vkottler/senior-design/README.md

# Fault-Tolerant Quadcopter

*Contributors: Vaughn Kottler, Cooper Green, Mayank Katwal*

An attempt at a quadcopter flight system that maintains
single-fault tolerance.

This project's documentation is hosted on
[Read the Docs](https://fault-tolerant-quadcopter.readthedocs.io/en/latest/).

## Repository Structure

### [cad](cad)

Schematic, printed circuit board, mechanical structure and mechanical enclosure
design assets.

### [docs](docs)

Documentation, including storage for documentation referenced for development
as well as design documentation.

### [logistics](logistics)

Bill of materials and other logistics-tracking assets.

### [src](src)

Source code for compute units and RIOs on the vehicle and on the ground.

### [scripts](scripts)

Utility shell scripts for installing dependencies to work on this project.
