vkottler/senior-design/docs/proposal/presentation.tex

\documentclass{beamer}
\setbeamertemplate{navigation symbols}{}

\usetheme{Madrid}
\usecolortheme{beaver}

% packages
\usepackage{graphicx}
\usepackage{enumitem}

% metadata
\title{Fault-Tolerant Quadcopter}
\author{Cooper, Vaughn, Mayank}
\date{\today}

\begin{document}

% title slide
{\setbeamertemplate{footline}{}
\begin{frame}
\begin{center}
{\Large\textbf{Fault-Tolerant Quadcopter}}\\
\vspace{\baselineskip}
ECE 453 Project Proposal (Fall 2018)\\
University of Wisconsin-Madison\\
\vspace{\baselineskip}
{\large\textit{Vaughn Kottler, Mayank Katwal, Cooper Green}}
\end{center}
\end{frame}
}

% state of the art (cheap toys)
\begin{frame}
\frametitle{State of the Art (Cheap Toys)}
\begin{center}
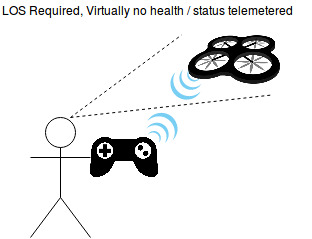
[picture p1: docs/src/im/crude.jpg]


Price Range: \$25 - \$50
\end{center}
\end{frame}

% state of the art (fpv)
\begin{frame}
\frametitle{State of the Art (Enthusiast FPV)}
\begin{center}
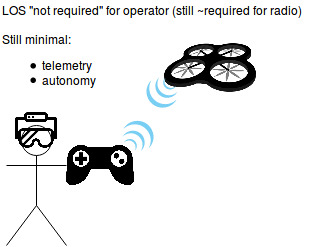
[picture p2: docs/src/im/fpv.jpg]


Price Range: \$100+
\end{center}
\end{frame}

% state of the art (industry)
\begin{frame}
\frametitle{State of the Art (Industry)}
\begin{center}
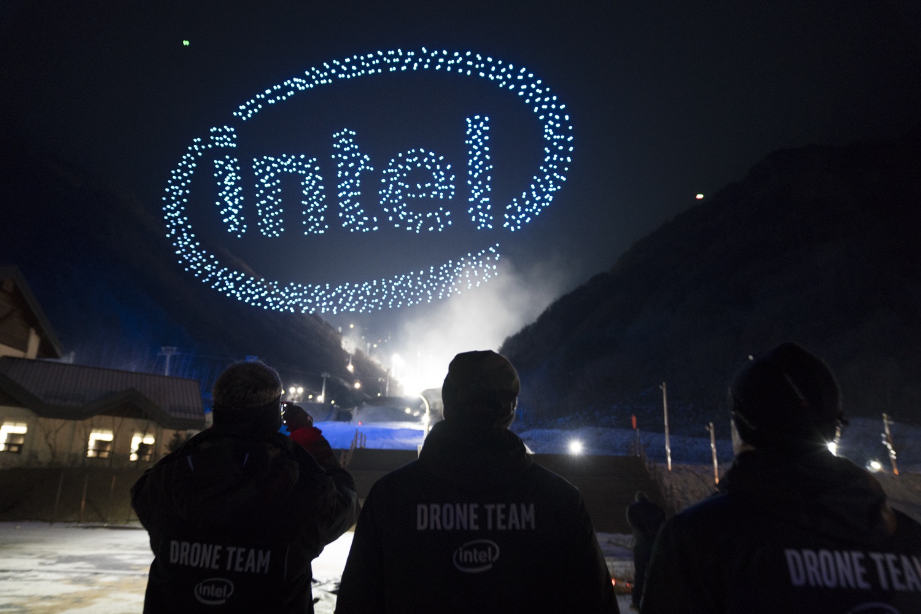
[picture p3: docs/src/im/autonomous2.jpg]


Light Show at the Olympics
\end{center}
\end{frame}

% state of the art (industry)
\begin{frame}
\frametitle{State of the Art (Industry)}
\begin{center}
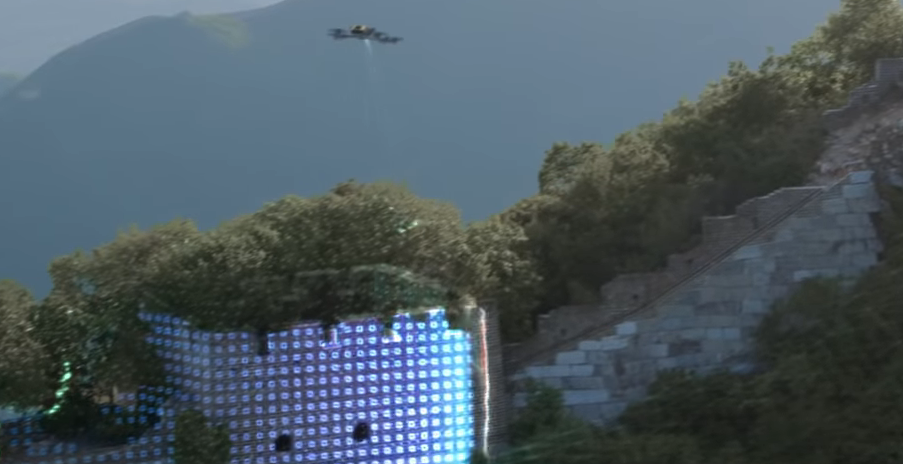
[picture p4: docs/src/im/great_wall1.png]


Intel Surveys Great Wall of China
\end{center}
\end{frame}

% problem statement
\begin{frame}
\frametitle{Problem Statement}
\Large
No ``multi-vehicle fleet'' or autonomous-flight capable drone
technology available to interact with.
\break

\textbf{What gap can we fill in this ecosystem?}
\break

To gain experience with aerospace-related problems, we propose
designing, testing and building a custom flying machine.
\break

\textbf{How hard are these problems?}
\end{frame}

% concept of approach
\begin{frame}
\frametitle{Concept of Operation}
\begin{center}
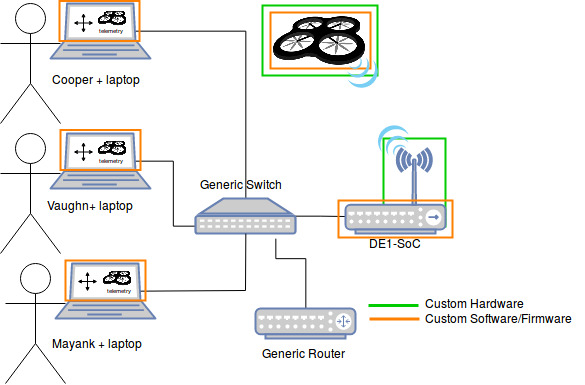
[picture p5: docs/src/im/conops.jpg]

\end{center}
\end{frame}

% features
\begin{frame}
\frametitle{Features}
\begin{description}[align=right,labelwidth=130pt,itemsep=15pt]
    \item [Telemetry Viewing] -- View vehicle data from the UI
    \item [Manual Commanding] -- Control the vehicle from the UI
    \item [Holding-Pattern Stability] -- Ability to ``idle'' with little to no motion
	\item [Single-Fault Tolerant] -- Land safely if communication is lost
\end{description}
\end{frame}

% quadcopter
\begin{frame}
\frametitle{Quadcopter}
\begin{center}
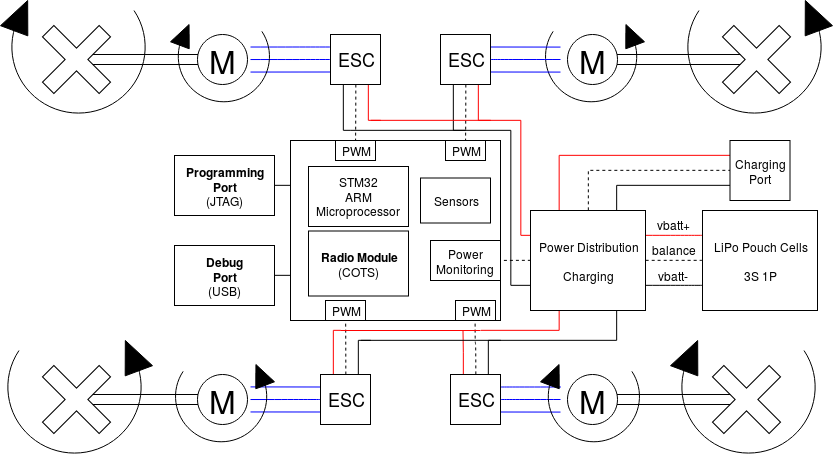
[picture p6: docs/src/im/quadcopter.png]

\end{center}
\end{frame}

% quadcopter components
\begin{frame}
\frametitle{Quadcopter Components}
\begin{center}
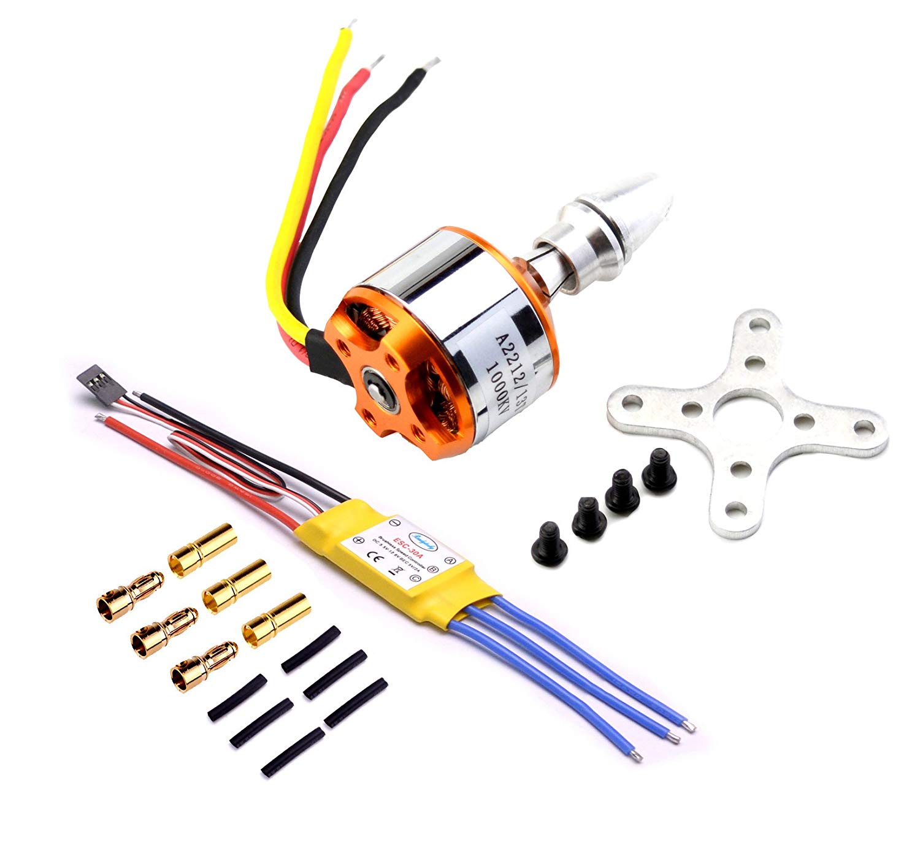
[picture p7: docs/src/im/motor_esc.jpg]




\break
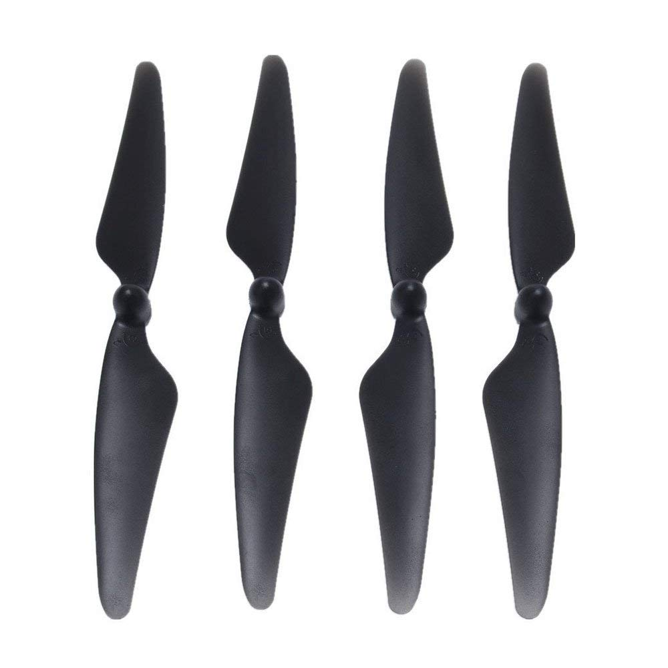
[picture p8: docs/src/im/propeller.jpg]

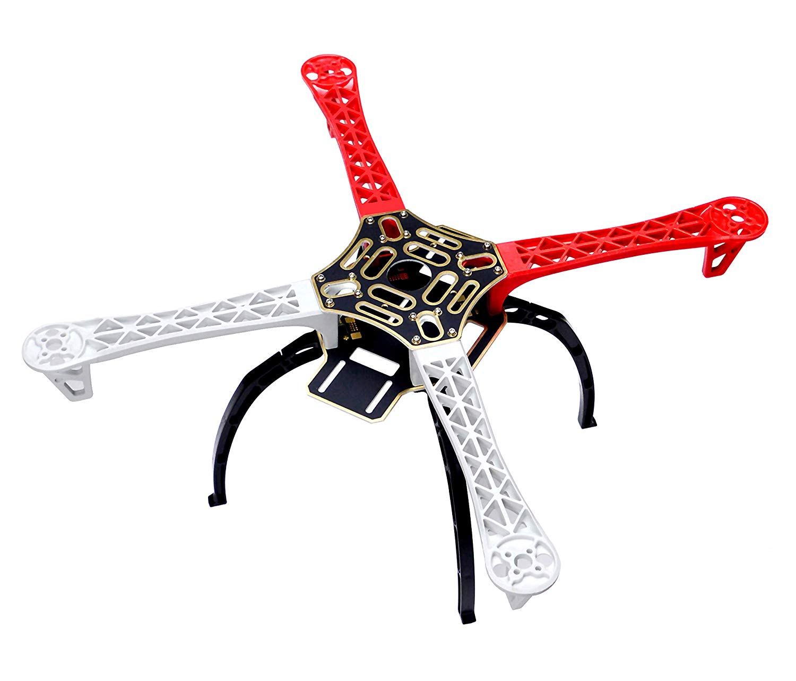
[picture p9: docs/src/im/chassis.jpg]

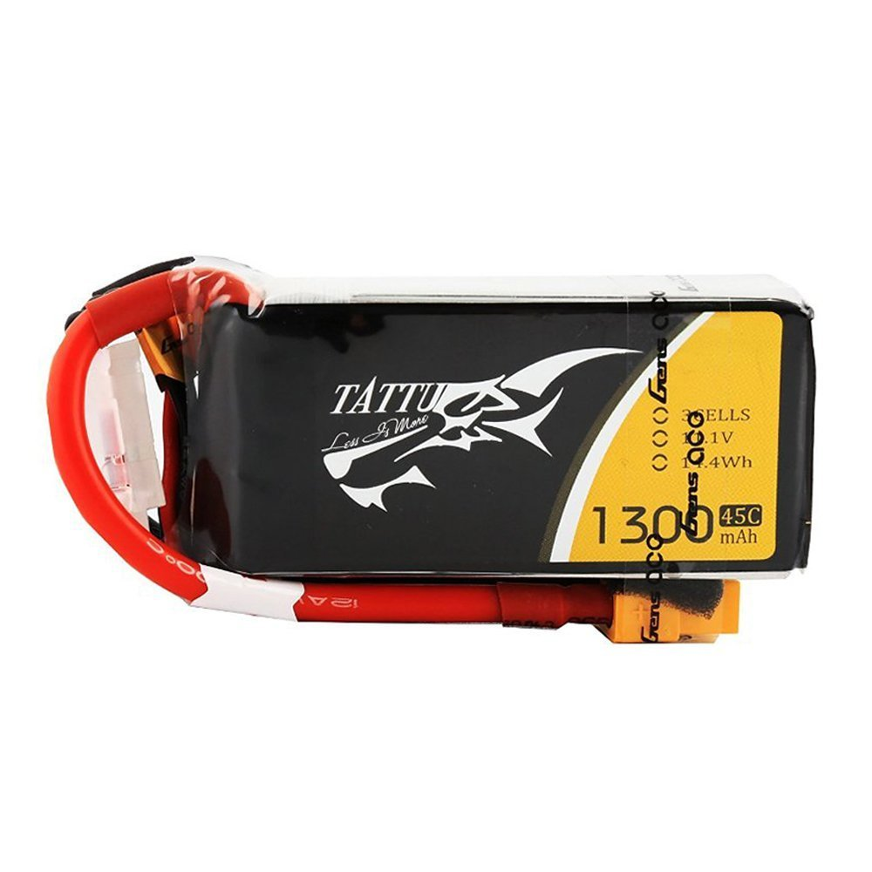
[picture p10: docs/src/im/battery.jpg]

\break
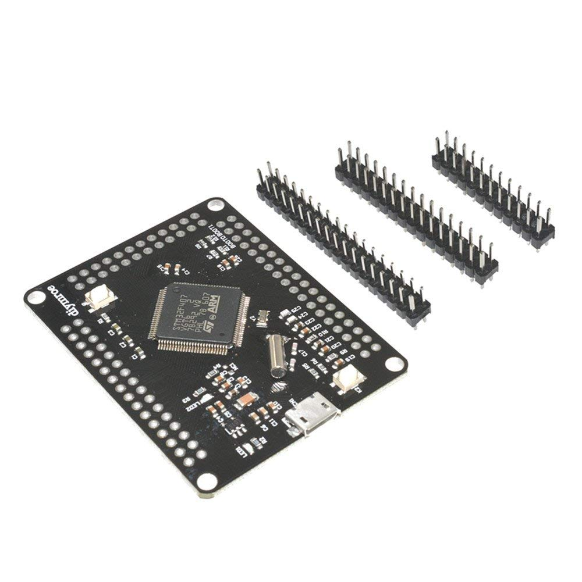
[picture p11: docs/src/im/dev_board.jpg]

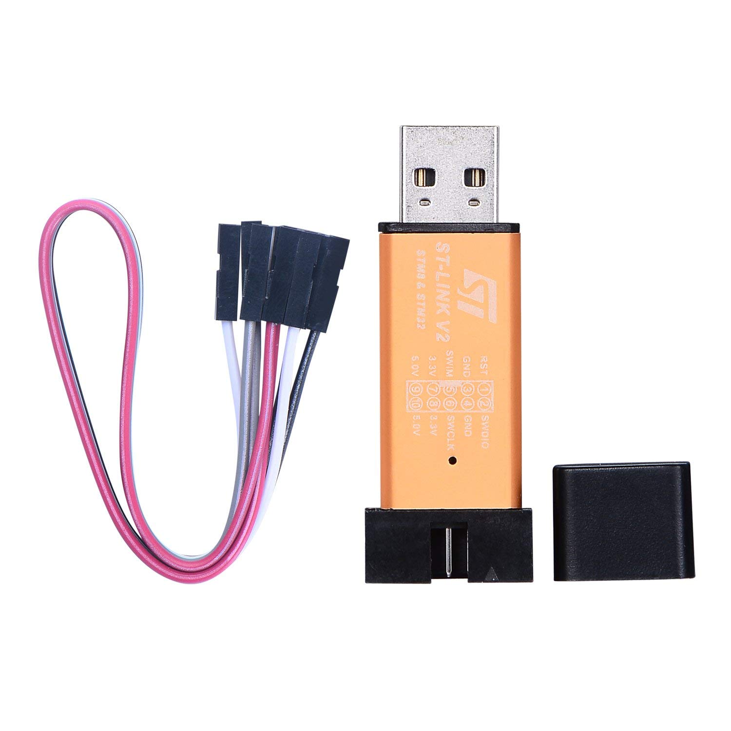
[picture p12: docs/src/im/programmer.jpg]

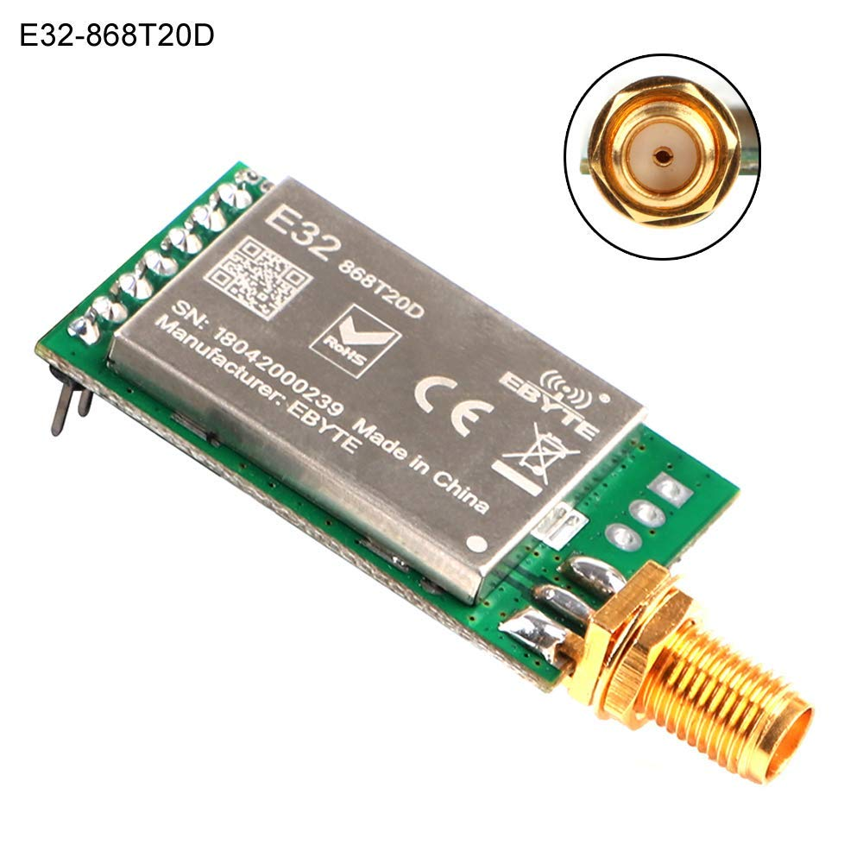
[picture p13: docs/src/im/radio1.jpg]

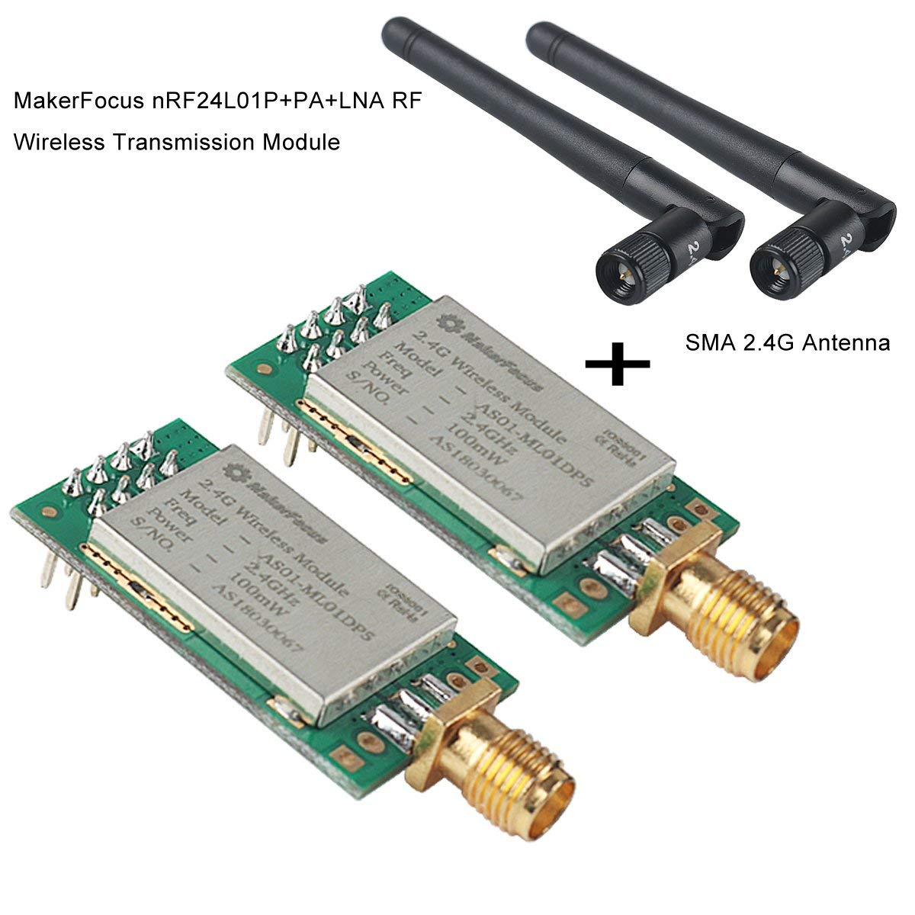
[picture p14: docs/src/im/radio2.jpg]

\end{center}
\end{frame}

% ground station
\begin{frame}
\frametitle{Ground Station}
\begin{center}
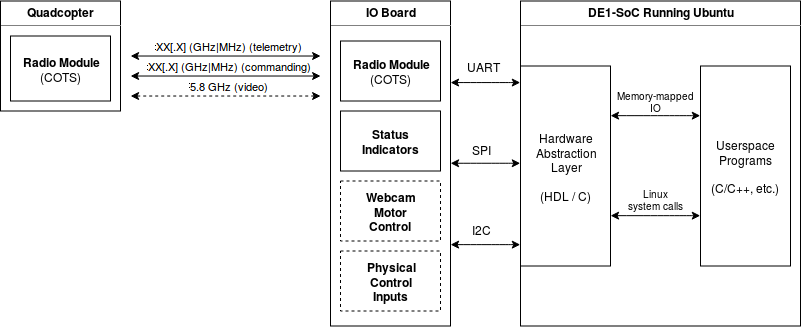
[picture p15: docs/src/im/ground_station.png]

\end{center}
\end{frame}

% display and controller
\begin{frame}
\frametitle{User Interface}
\begin{center}
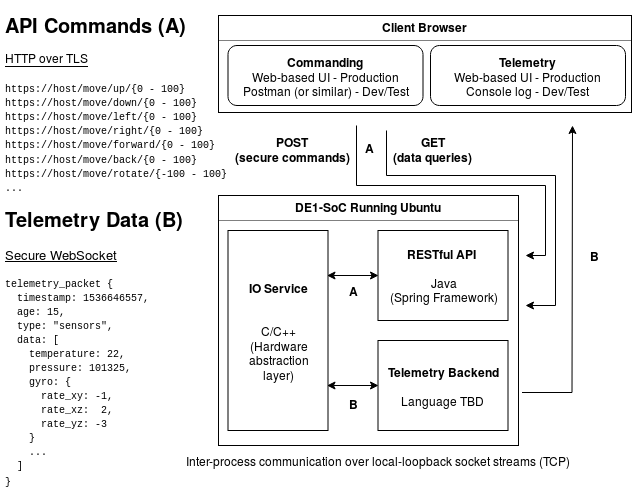
[picture p16: docs/src/im/display_controller.png]

\end{center}
\end{frame}

% total cost
\begin{frame}
\frametitle{Estimated Total Cost}
\large
\vspace{0.2in}
\begin{itemize}
\item \textbf{\$305} -- Quadcopter (Parts, custom PCB)
\item \textbf{\$108} -- Ground Station (Parts, custom PCB)
\item \textbf{\$200} -- General development and test equipment/components
\item \textbf{\$613} -- Total
\end{itemize}
\vspace{0.2in}
\Large
Higher-granularity breakdown in report.
    
\end{frame}

\begin{frame}
\frametitle{Summary}
\large
We feel prepared to take on this challenge:
\begin{itemize}
    \item[\textbullet] Prior experience with systems' engineering (vehicle projects)
    \item[\textbullet] At least a dozen previous failures
    \item[\textbullet] Confident in this architecture
    \item[\textbullet] Have development tools and equipment on standby
\end{itemize}
\vspace{0.5in}
\begin{center}
Funding would greatly increase the quality of the final product!
\end{center}
\end{frame}

\end{document}
