vkottler/senior-design/docs/src/ground.rst

Ground Hardware and Software
============================

Block diagram:
