vkottler/senior-design/docs/proposal/presentation-minimal.pdf

## Fault-Tolerant Quadcopter

ECE 453 Project Proposal (Fall 2018) University of Wisconsin-Madison

Vaughn Kottler, Mayank Katwal, Cooper Green

## Overview

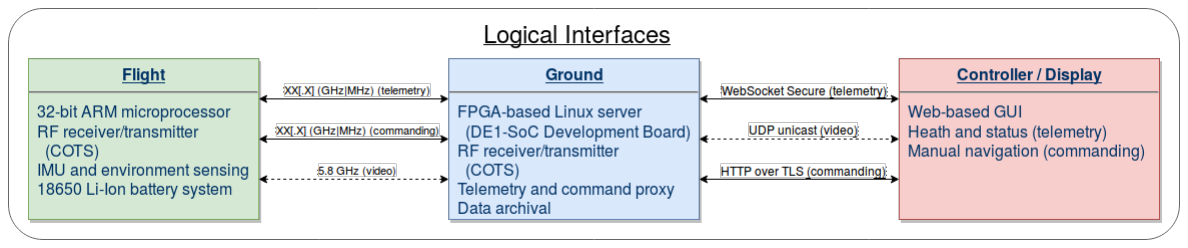
[picture p26: figure]

Quadcopter – Battery-powered, four-motor flying machine

Ground Station – Linux server managing the quadcopter’s radio endpoint, hosts wired-network services (i.e. telemetry)

Web-based UI – A modern dashboard for visualizing data and manually commanding the vehicle

## Learning Objectives and Features

Exposure to:
– Radio-frequency communication – Control theory
– SoC platform(s)
– Data pipelining in the aerospace/avionics problem space

– Modern user-interface design and implementation

Features:
Single-Fault Tolerant – Land safely in the event of communication “heartbeat timeout”
Telemetry Archival – Implement long-term telemetry storage for post-flight data analysis

## Quadcopter

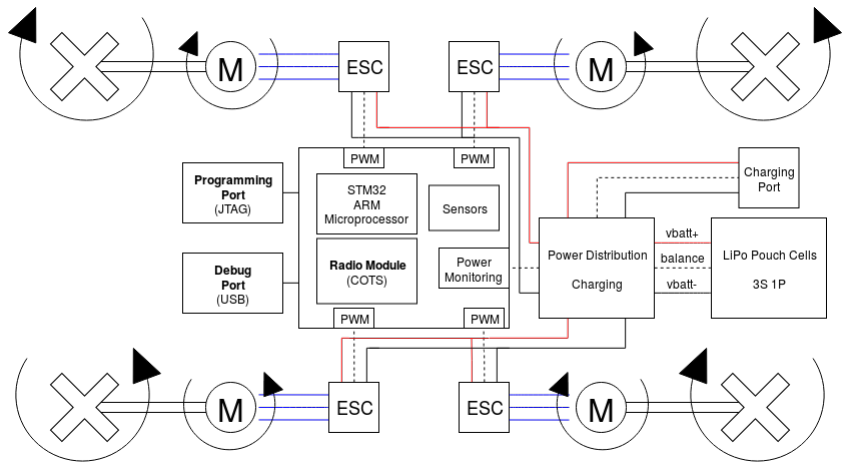
[picture p27: figure]

## Ground Station

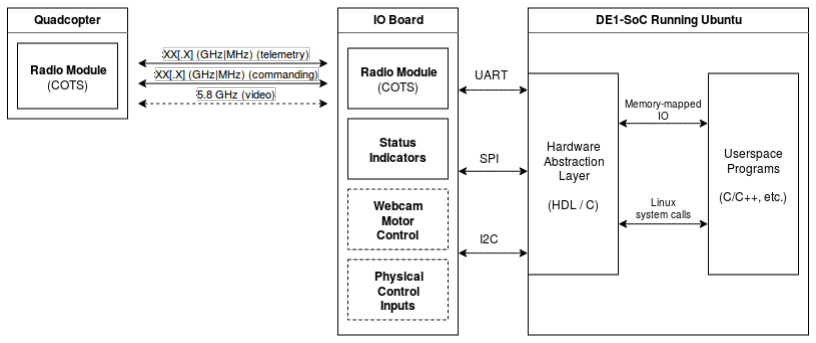
[picture p28: figure]

## User Interface

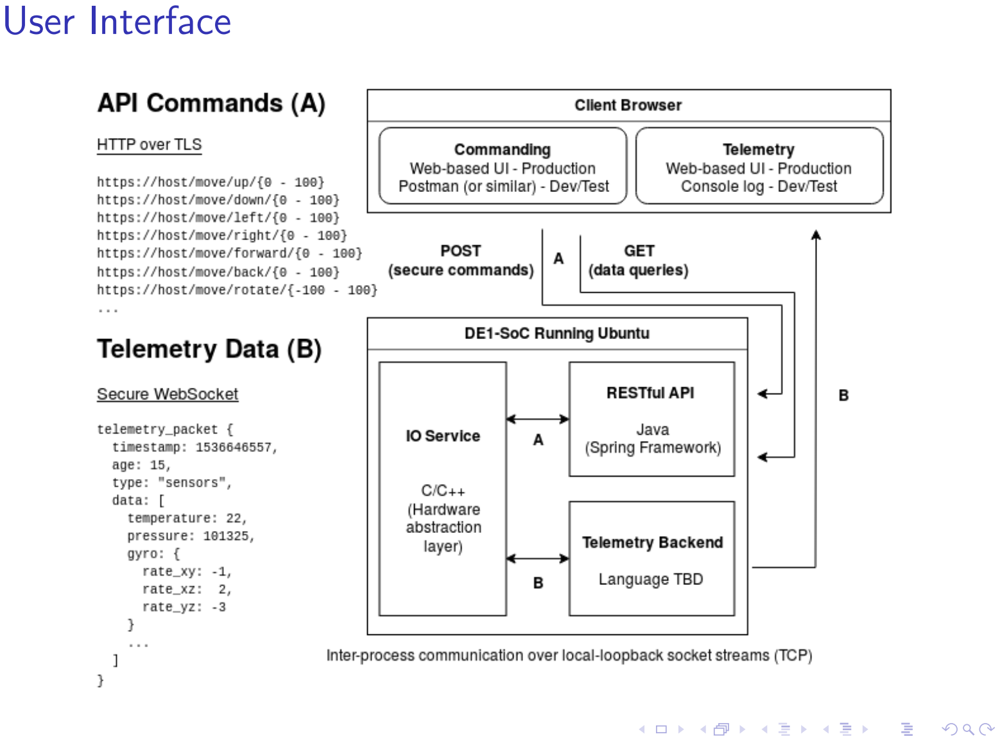
[picture p29: page 6]
