vkottler/senior-design/docs/proposal/presentation.pdf

## Fault-Tolerant Quadcopter

ECE 453 Project Proposal (Fall 2018) University of Wisconsin-Madison

Vaughn Kottler, Mayank Katwal, Cooper Green

## Overview


Quadcopter – Battery-powered, four-motor flying machine

Ground Station – Linux server managing the quadcopter’s radio endpoint, hosts wired-network services (i.e. telemetry)

Web-based UI – A modern dashboard for visualizing data and manually commanding the vehicle

## Learning Objectives

Exposure to:
– Radio-frequency communication

– Control theory

– System-level engineering

– SoC platform(s)

Also:
– Data pipelining in the aerospace/avionics problem space

– Modern user-interface design and implementation

## Features

Single-Fault Tolerant – Land safely in the event of communication “heartbeat timeout”

Telemetry Archival – Implement long-term telemetry storage for post-flight data analysis

## Quadcopter


## Ground Station


## User Interface


## Milestones

1) Establish wireless communication between the vehicle and ground station
2) Establish percentage-based throttle control over each motor
3) Establish manual-commanding capability to the vehicle from a web-based user interface
4) View live telemetry from a web-based user interface
5) Sense angular velocity via gyroscope and force experienced via inertial measurement unit

Milestones cont.

6) Develop a control algorithm to fly in a stable hover or holding pattern
7) Extend control algorithm to control for velocity in three axes to achieve controlled motion
8) Sense relative altitude
9) Extend control algorithm to control for a specific delta-y (perpendicular to ground plane)

## Initial Development and Prototyping

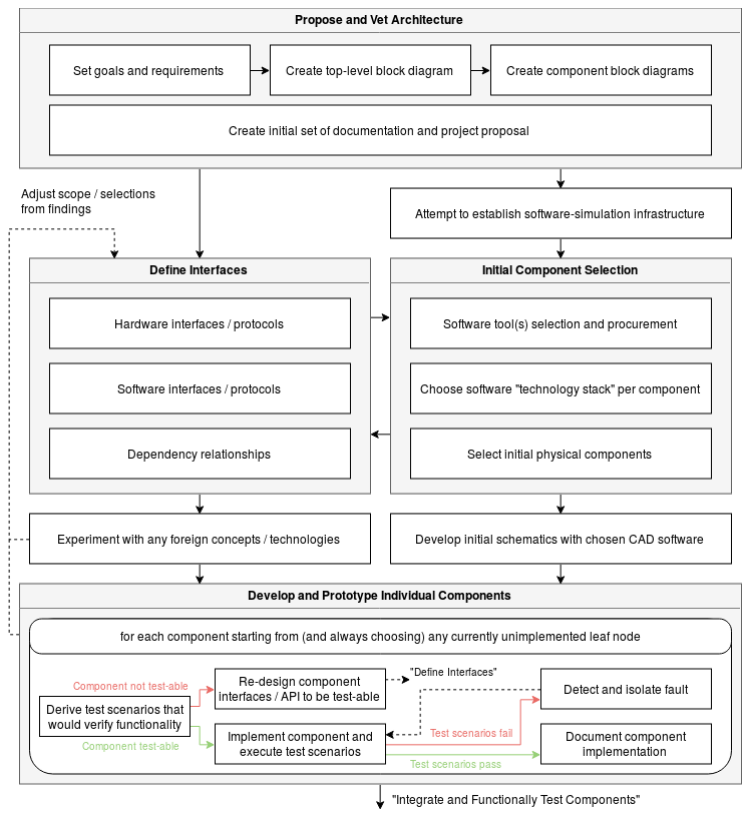
[picture p30: figure]

## Final Stages

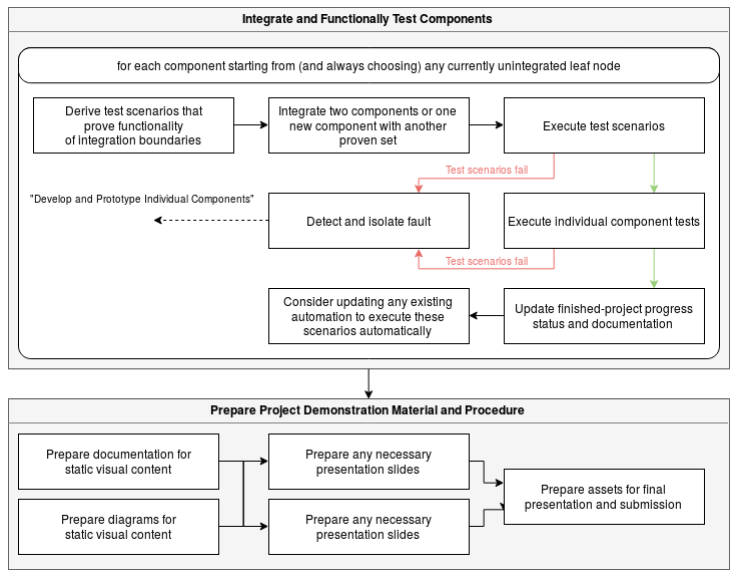
[picture p31: figure]
