vkottler/senior-design/docs/pdf/workflow.pdf

Propose and Vet Architecture

Define Interfaces | Initial Component Selection
Set goals and requirements | Create top-level block diagram | Create component block diagrams

Create initial set of documentation and project proposal

Attempt to establish software-simulation infrastructure

Hardware interfaces / protocols

Software interfaces / protocols

Dependency relationships

Software tool(s) selection and procurement

Choose software "technology stack" per component

Select initial physical components

Develop and Prototype Individual Components

Experiment with any foreign concepts / technologies | Develop initial schematics with chosen CAD software

Adjust scope / selections
from findings

for each component starting from (and always choosing) any currently unimplemented leaf node

Derive test scenarios that would verify functionality Implement component and
execute test scenarios

Re-design component
interfaces / API to be test-able

Component not test-able

Component test-able

"Define Interfaces"
Detect and isolate fault

Document component
implementation
Test scenarios pass

Test scenarios fail

"Integrate and Functionally Test Components"

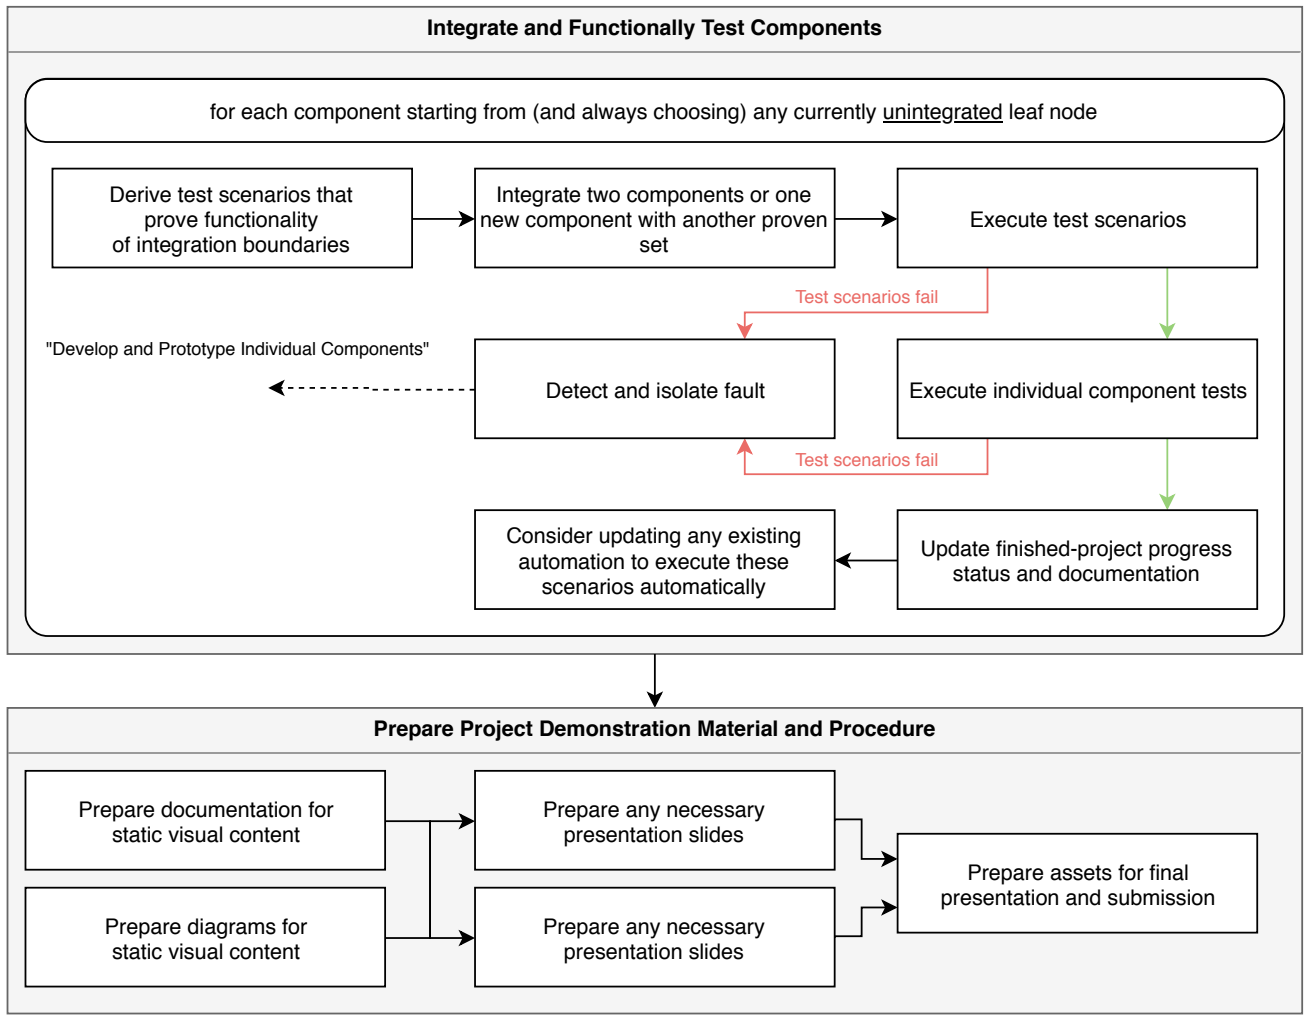
[picture p34: figure]
Integrate and Functionally Test Components; Derive test scenarios that prove functionality of integration boundaries; Integrate two components or one new component with another proven set; Execute test scenarios; Detect and isolate fault; Execute individual component tests; "Develop and Prototype Individual Components"; Test scenarios fail; Update finished-project progress status and documentation; Consider updating any existing automation to execute these scenarios automatically; Prepare documentation for static visual content; Prepare diagrams for static visual content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

Prepare Project Demonstration Material and Procedure for each component starting from (and always choosing) any currently unintegrated leaf node
