vkottler/senior-design/docs/src/display.rst

Display and Control Architecture
================================

Block diagram:
