vkottler/senior-design/docs/src/flight.rst

Flight Hardware and Software
============================

Block diagram:
