vkottler/senior-design/coursework/lab_2/Lab2_Software.PNG

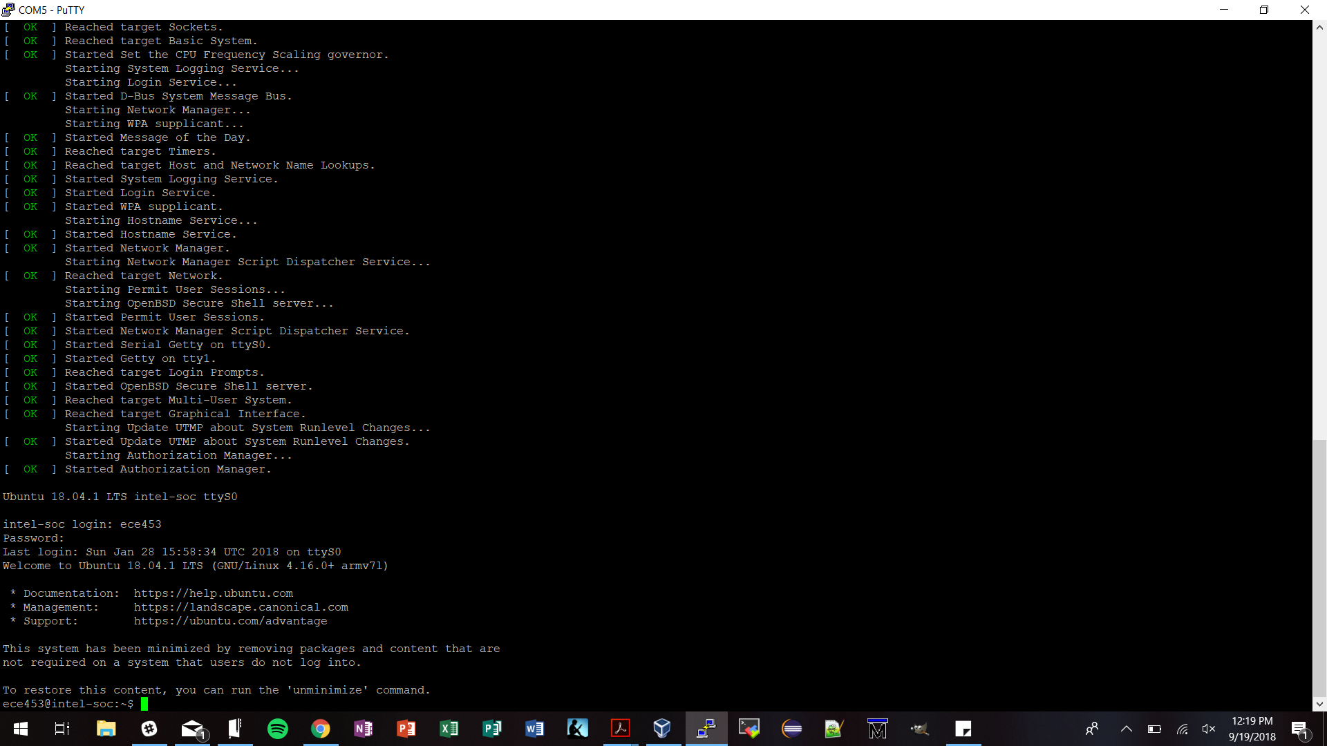
coursework/lab_2/Lab2_Software.PNG
