vkottler/senior-design/docs/src/im/autonomous3.jpg

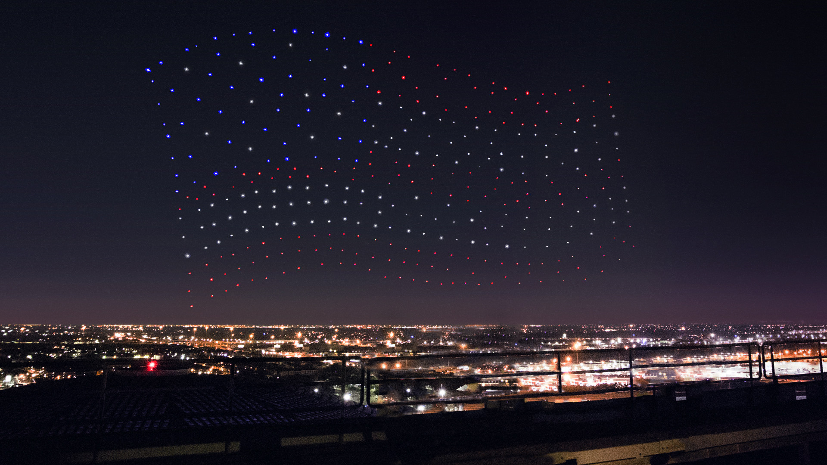
docs/src/im/autonomous3.jpg
