vkottler/senior-design/docs/src/im/autonomous.jpeg

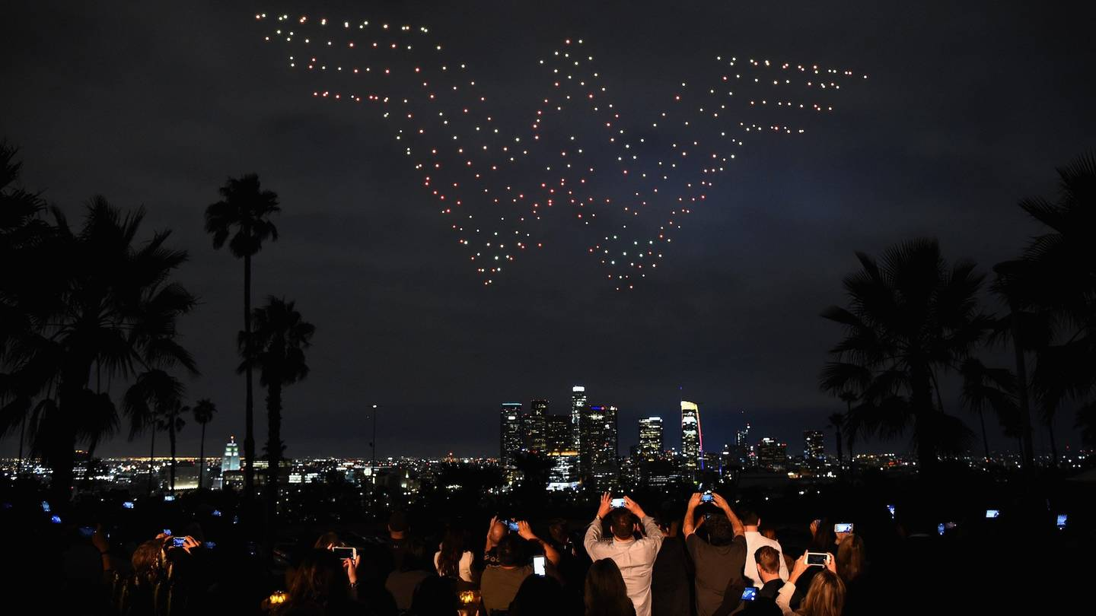
docs/src/im/autonomous.jpeg
