vkottler/senior-design/docs/src/im/great_wall2.png

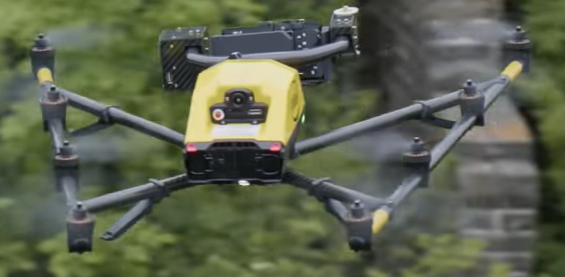
docs/src/im/great_wall2.png
