vkottler/senior-design/docs/src/im/great_wall3.png

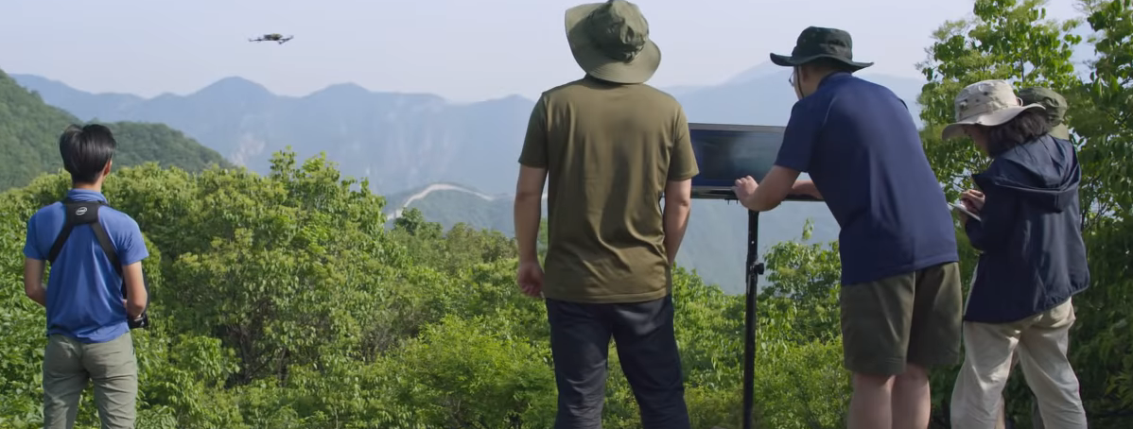
docs/src/im/great_wall3.png
