vkottler/senior-design/coursework/lab_1/InterfaceBoard/Bill of Materials-ECE453_Interface.xlsx

Description | Designator | Manufacturer Part Number | Quantity | Manufacturer Part Number 1 | Supplier Part Number | Supplier Part Number 1
CAP ALUM 100UF 20% 10V SMD | C1, C2, C8 | EEE-1AA101WR | 3 | EEE-1AA101WR (https://octopart-clicks.com/click/altium?sku=PCE3867CT-ND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) |  | PCE3867CT-ND (https://octopart-clicks.com/click/altium?sku=PCE3867CT-ND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)
CAP CER 10UF 16V 10% X5R 0805 | C3 | GRM21BR61C106KE15L | 1 | GRM21BR61C106KE15L (https://octopart-clicks.com/click/altium?sku=490-3886-1-ND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) | 490-3886-1-ND | 490-3886-1-ND (https://octopart-clicks.com/click/altium?sku=490-3886-1-ND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)
CAP CER 0.1UF 25V 10% X7R 0805 | C4, C5, C6, C7, C9 | C0805C104K3RACTU | 5 |  | 399-1168-1-ND
LED RED CLEAR 0805 SMD | D1, D2, D3 | LTST-C171KRKT | 3 | LTST-C171KRKT (https://octopart-clicks.com/click/altium?sku=160-1427-1-ND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) |  | 160-1427-1-ND (https://octopart-clicks.com/click/altium?sku=160-1427-1-ND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)
PTC RESTTBLE 0.75A 6V CHIP 0805 | F1, F2 | 0ZCK0075FF2E | 2 | 0ZCK0075FF2E (https://octopart-clicks.com/click/altium?sku=507-1814-1-ND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) |  | 507-1814-1-ND (https://octopart-clicks.com/click/altium?sku=507-1814-1-ND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)
CONN HEADER 2.54MM 10POS GOLD | J1 | SBH11-PBPC-D05-ST-BK | 1 |  | S9169-ND
CONN HEADER 2.54MM 16POS GOLD | J2 | SBH11-PBPC-D08-ST-BK | 1 |  | S9171-ND
Header, 4-Pin | J3 | 61300411121 | 1 | 61300411121 (https://octopart-clicks.com/click/altium?sku=732-5317-ND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) |  | 732-5317-ND (https://octopart-clicks.com/click/altium?sku=732-5317-ND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)
Header, 3-Pin | J4, J5, J6, J7, J8, J9 | PREC003SFAN-RC | 6 | PREC003SFAN-RC (https://octopart-clicks.com/click/altium?sku=S1212EC-03-ND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) | S1212EC-03-ND | S1212EC-03-ND (https://octopart-clicks.com/click/altium?sku=S1212EC-03-ND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)
 | JP1 | SFH11-PBPC-D20-ST-BK | 1 | SFH11-PBPC-D20-ST-BK (https://octopart-clicks.com/click/altium?sku=S9200-ND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) |  | S9200-ND (https://octopart-clicks.com/click/altium?sku=S9200-ND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)
SHUNT JUMPER .1" BLACK GOLD | M1, M2, M3, M4, M5, M6 | 969102-0000-DA | 6 | 969102-0000-DA (https://octopart-clicks.com/click/altium?sku=3M9580-ND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) |  | 3M9580-ND (https://octopart-clicks.com/click/altium?sku=3M9580-ND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)
RES SMD 2.21K OHM 1% 1/8W 0805 | R1, R2 | RC0805FR-072K21L | 2 | RC0805FR-072K21L (https://octopart-clicks.com/click/altium?sku=311-2.21KCRCT-ND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) |  | 311-2.21KCRCT-ND (https://octopart-clicks.com/click/altium?sku=311-2.21KCRCT-ND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)
RES 220 1/10W 1% 0805 SMD | R3, R13, R14 | ERJ-6ENF2200V | 3 |  | P220CTR-ND
RES 10K 1/10W 1% 0805 SMD | R4, R5, R6, R7, R8, R9, R15, R16, R17, R18, R19, R20 | ERJ-6ENF1002V | 12 | ERJ-6ENF1002V (https://octopart-clicks.com/click/altium?sku=P10.0KCCT-ND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) | P10.0KCCT-ND | P10.0KCCT-ND (https://octopart-clicks.com/click/altium?sku=P10.0KCCT-ND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)
RES 0, , 1%, 0.125W, 1/8W 0805 | R10 |  | 1 | ERJ-6GEY0R00V (https://octopart-clicks.com/click/altium?sku=P0.0ACT-ND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) | P0.0ACT-ND | P0.0ACT-ND (https://octopart-clicks.com/click/altium?sku=P0.0ACT-ND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)
RES SMD 330 mOHM 1% 1/3W 0805 | R11, R12 | RL1220S-R33-F | 2 | RL1220S-R33-F (https://octopart-clicks.com/click/altium?sku=RL12S.33FCT-ND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) |  | RL12S.33FCT-ND (https://octopart-clicks.com/click/altium?sku=RL12S.33FCT-ND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)
SWITCH SLIDE DPDT 500MA 15V | SW1 | EG2219 | 1 | EG2219 (https://octopart-clicks.com/click/altium?sku=EG4367-ND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) |  | EG4367-ND (https://octopart-clicks.com/click/altium?sku=EG4367-ND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)
BLUETOOTH 4.2 BLE MODULE, SHIELD | U1 |  | 1 | RN4870-V/RM118 (https://octopart-clicks.com/click/altium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) | RN4870-V/RM118-ND | RN4870-V/RM118-ND (https://octopart-clicks.com/click/altium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)
IMU ACCEL/GYRO/TEMP I2C/SPI LGA | U2 |  | 1 | LSM6DS3HTR (https://octopart-clicks.com/click/altium?sku=497-16367-1-ND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) | 497-16367-1-ND | 497-16367-1-ND (https://octopart-clicks.com/click/altium?sku=497-16367-1-ND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)
IC MOTOR DRIVER STEP/DIR 24TSSOP | U3 | A5984GLPTR-T | 1 | A5984GLPTR-T (https://octopart-clicks.com/click/altium?sku=620-1787-1-ND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) |  | 620-1787-1-ND (https://octopart-clicks.com/click/altium?sku=620-1787-1-ND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)
SENSOR TEMPERATURE I2C 8VSSOP | U4 | LM75AIMMX/NOPB | 1 | LM75AIMMX/NOPB (https://octopart-clicks.com/click/altium?manufacturer=TI%20National%20Semiconductor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) |  | 296-35312-1-ND (https://octopart-clicks.com/click/altium?manufacturer=TI%20National%20Semiconductor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)
