vkottler/senior-design/coursework/lab_1/Lab1_PWR/Output/BOM/Bill of Materials-ECE453-PWR.xlsx

Comment | Description | Designator | Footprint | LibRef | Manufacturer 1 | Manufacturer Part Number 1 | Quantity
1uF | CAP CER 1 UF 6.3V 10% X5R 0805 | C1, C4 | CAP_0805 | CAP_0805_U_001.00 | KEMET (https://octopart-clicks.com/click/altium?sku=399-9160-1-ND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) | C0805C105K9PACTU (https://octopart-clicks.com/click/altium?sku=399-9160-1-ND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) | 2
4.7uF | CAP CER 4.7 UF 16V 10% X5R 0805 | C2, C3 | CAP_0805 | CAP_0805_U_004.70 | Kyocera AVX (https://octopart-clicks.com/click/altium?sku=478-5166-6-ND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) | 0805YD475KAT2A (https://octopart-clicks.com/click/altium?sku=478-5166-6-ND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) | 2
0.01uF | CAP CER 10000PF 16V 10% X7R 0805 | C5 | CAP_0805 | CAP_0805_U_000.01 | KEMET (https://octopart-clicks.com/click/altium?sku=399-7995-1-ND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) | C0805C103K4RACTU (https://octopart-clicks.com/click/altium?sku=399-7995-1-ND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) | 1
100 uF |  | C6 | CAP_100uF | CAP_100uF | Nichicon (https://octopart-clicks.com/click/altium?sku=493-6186-1-ND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) | UCD1V101MNL1GS (https://octopart-clicks.com/click/altium?sku=493-6186-1-ND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) | 1
0.1uF | CAP CER 0.1 UF 6.3V 10% X7R 0805 | C7 | CAP_0805 | CAP_0805_U_000.10 | KEMET (https://octopart-clicks.com/click/altium?sku=399-9155-6-ND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) | C0805C104K9RACTU (https://octopart-clicks.com/click/altium?sku=399-9155-6-ND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) | 1
DIODE_B340A | DIODE SCHOTTKY 40V 3A SMA | D1 | B340A | DIODE_B340A | Diodes (https://octopart-clicks.com/click/altium?sku=B340A-FDICT-ND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) | B340A-13-F (https://octopart-clicks.com/click/altium?sku=B340A-FDICT-ND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) | 1
LED_GREEN_0805.1 | LED GREEN CLEAR THIN 0805 SMD | D2, D3 | LED_GRN_0805 | LED_GREEN_0805.1 | Vishay Lite-On (https://octopart-clicks.com/click/altium?sku=160-1426-1-ND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) | LTST-C171KGKT (https://octopart-clicks.com/click/altium?sku=160-1426-1-ND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) | 2
CONN_HEADER_MALE_8x2 | CONN HEADER 2.54MM 16POS GOLD | J1 | SBH11-PBPC-D08-ST-BK | CONN_HEADER_MALE_8x2 | Sullins (https://octopart-clicks.com/click/altium?sku=S9171-ND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) | SBH11-PBPC-D08-ST-BK (https://octopart-clicks.com/click/altium?sku=S9171-ND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) | 1
CONN_HEADER_MALE_5x2 | CONN HEADER 2.54MM 10POS GOLD | J2 | SBH11-PBPC-D05-ST-BK | CONN_HEADER_MALE_5x2 | Sullins (https://octopart-clicks.com/click/altium?sku=S9169-ND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) | SBH11-PBPC-D05-ST-BK (https://octopart-clicks.com/click/altium?sku=S9169-ND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) | 1
PWR2.5 | Low Voltage Power Supply Connector | J3 | PJ-102 | PWR2.5 | CUI (https://octopart-clicks.com/click/altium?sku=CP-102A-ND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) | PJ-102A (https://octopart-clicks.com/click/altium?sku=CP-102A-ND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) | 1
IND_8040S_270M |  | L1 | IND-ASPI-8040S | IND_8040S_270M | Abracon (https://octopart-clicks.com/click/altium?sku=ASPI-8040S-270M-TCT-ND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) | ASPI-8040S-270M-T (https://octopart-clicks.com/click/altium?sku=ASPI-8040S-270M-TCT-ND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) | 1
PMOD F14 REV A | ECE 453 Digital Themometer PMOD F14 Rev A Bare PCB | PCB1 |  | PMOD F14 Rev A Bare PCB | TBD (https://octopart-clicks.com/click/altium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) | PMOD F14 REV A (https://octopart-clicks.com/click/altium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) | 1
10K | RES SMD 10K OHM 1% 1/8W 0805 | R1, R4 | RES_0805 | RES_0805_K_010.00 |  |  | 2
RES_0805_K_003.34 | RES SMD 3.24K OHM 1% 1/8W 0805 | R2 | RES_0805 | RES_0805_K_003.34 | Panasonic (https://octopart-clicks.com/click/altium?sku=P3.24KCCT-ND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) | ERJ-6ENF3241V (https://octopart-clicks.com/click/altium?sku=P3.24KCCT-ND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) | 1
27K | RES SMD 27.0K OHM 1% 1/8W 0805 | R3 | RES_0805 | RES_0805_K_027.00 | Bourns (https://octopart-clicks.com/click/altium?sku=CR0805-FX-2702GLFDKR-ND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) | CR0805-FX-2702GLF (https://octopart-clicks.com/click/altium?sku=CR0805-FX-2702GLFDKR-ND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) | 1
330 | RES SMD 330 OHM 1% 1/8W 0805 | R5, R6 | RES_0805 | RES_0805_R_330.00 |  |  | 2
TP_1206 | Test Point SMD 1206 | TP1, TP2, TP3, TP4, TP5, TP6, TP7, TP8, TP9 | TP-SMC-1206 | TP_1206 | TE Connectivity CGS (https://octopart-clicks.com/click/altium?sku=A106143CT-ND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) | RCS-0C (https://octopart-clicks.com/click/altium?sku=A106143CT-ND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) | 9
IC-TLV733P | IC REG LINEAR 3.3V 300MA SOT23-5 | U1 | TI-SOT-23-5 | IC-TLV733P |  |  | 1
IC_TPS5420 | IC REG BUCK ADJ 2A 8SOIC | U2 | TI-SOIC-8 | IC_TPS5420 | Texas Instruments (https://octopart-clicks.com/click/altium?sku=296-31984-1-ND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) | TPS5420DR (https://octopart-clicks.com/click/altium?sku=296-31984-1-ND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) | 1
IC_TPS3705-33DGN.1 | IC 2.93V PROCESSOR MONITOR 8MSOP | U3 | TI-SOIC-8 | IC_TPS3705-33DGN.1 | Texas Instruments (https://octopart-clicks.com/click/altium?sku=296-2623-5-ND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) | TPS3705-33D (https://octopart-clicks.com/click/altium?sku=296-2623-5-ND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) | 1
