vkottler/senior-design/cad/pcb/altium/outputs/flight_controller/BOM/Bill of Materials-flight-controller.xlsx

Supplier Part Number 1 | Supplier 1 | Manufacturer Part Number 1 | Designator | Quantity | Comment | Description | Footprint | LibRef
CKN9112DKR-ND (https://octopart-clicks.com/click/altium?sku=CKN9112DKR-ND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) | Digi-Key | PTS645SM43SMTR92LFS (https://octopart-clicks.com/click/altium?sku=CKN9112DKR-ND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) | B1 | 1 | Tactile Switch | NO, MOM, 6mm | 6mm Tactile Switch | Tactile Switch
 |  |  | C1, C5, C9, C19 | 4 | 1 uF | 10%, 0805, ±10%, 0805 | CAP-CER-0805-TALL | CAP-CER-1uF-10V
 |  |  | C2, C3, C4, C6, C7, C8, C10, C12, C13, C15, C16, C17, C18, C25, C29, C31, C34 | 17 | 0.1 uF | 10%, 0805, ±10%, 0805 | CAP-CER-0805-SHORT | CAP-CER-0.1uF-25V
 |  |  | C11, C20 | 2 | 10 nF | ±10%, 0805, 10%, 0805 | CAP-CER-0805-SHORT | CAP-CER-10nF-50V
 |  |  | C14, C27, C28, C30 | 4 | 4.7 uF | 10%, 0805, ±10%, 0805 | CAP-CER-0805-TALL | CAP-CER-4.7uF-10V
 |  |  | C21, C22 | 2 | 1 pF | ±0.25pF, 0805 | CAP-CER-0805-SHORT | CAP-CER-1pF-50V
 |  |  | C23, C24 | 2 | 16 pF | ±5%, 0805 | CAP-CER-0805-SHORT | CAP-CER-16pF-50V
 |  |  | C26 | 1 | 100 pF | ±0.25pF, 0805 | CAP-CER-0805-SHORT | CAP-CER-100pF-50V
 |  |  | C32, C33 | 2 | 47 pF | ±5%, 0805 | CAP-CER-0805-SHORT | CAP-CER-47pF-50V
475-1410-1-ND (https://octopart-clicks.com/click/altium?sku=475-1410-1-ND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) | Digi-Key | Q62702P5179 (https://octopart-clicks.com/click/altium?sku=475-1410-1-ND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) | D1, D2, D3, D4, D5, D6, D7, D8, D9, D10, D11, D12, D13 | 13 | LED-WHT-20mA | 2.2V, 0805 | LED-0805 | LED-WHT-20mA
 |  |  | H1, H2, H3, H4 | 4 | Mount Hole |  | 4mm Mount Hole | Mount Hole
 |  |  | P1 | 1 | LoRa 868 MHz Radio | UART Interface, 0.1" Pitch, E32 (868T20D) chipset | LoRa Breakout | 868 MHz SX1276 LoRa Breakout
 |  |  | P2 | 1 | 2Pos Pin Header | 0.1" Pitch 1x2 | 2Pos Pin Header JST | 2Pos Pin Header
 |  |  | P3, P4, P7, P8 | 4 | ESC | PWM Interface, 0.1" Pitch 1x3 | ESC RA | ESC
 |  |  | P5 | 1 | 6Pos Pin Header | 0.1" Pitch 1x6 | 6Pos Pin Header JST | 6Pos Pin Header
 |  |  | P6 | 1 | 4Pos Pin Header | 0.1" Pitch 1x4 | 4Pos Pin Header JST | 4Pos Pin Header
H2201-ND (https://octopart-clicks.com/click/altium?sku=H2201-ND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) | Digi-Key | DF13-4P-1.25DS(20) (https://octopart-clicks.com/click/altium?sku=H2201-ND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) | P9, P10 | 2 | Lidar Range Sensor |  | 4x1 Shrouded Header 1.25mm | Lidar Range Sensor
3220-10-0300-00 (https://octopart-clicks.com/click/altium?sku=3220-10-0300-00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) | Arrow | 3220-10-0300-00 (https://octopart-clicks.com/click/altium?sku=3220-10-0300-00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) | P12 | 1 | JTAG Header |  | SMD Header 5x2x1.27mm | 10-pin JTAG Header
609-4616-6-ND (https://octopart-clicks.com/click/altium?sku=609-4616-6-ND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) | Digi-Key | 10118193-0001LF (https://octopart-clicks.com/click/altium?sku=609-4616-6-ND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) | P13 | 1 | USB Micro B |  | USB Micro B | USB Micro B
2N7002K-T1-E3DKR-ND (https://octopart-clicks.com/click/altium?manufacturer=Vishay%20Siliconix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) | Digi-Key | 2N7002K-T1-E3 (https://octopart-clicks.com/click/altium?manufacturer=Vishay%20Siliconix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) | Q1, Q2, Q3 | 3 | 2N7002K | N-Channel, SOT-23 | SC-89 | NMOS-2.0VT-60VDS-300mA
 |  |  | R1, R3, R5, R8, R9, R16, R17, R18 | 8 | 47K | 0805 | RES-0805 | RES-47K-1/8W
 |  |  | R2, R4, R13, R15 | 4 | 10K | 0805 | RES-0805 | RES-10K-1/8W
 |  |  | R6, R7, R10, R11, R19, R20, R21, R37, R40, R41 | 10 | 330 | 0805 | RES-0805 | RES-330-1/8W
 |  |  | R12, R14, R25, R26 | 4 | 0 | 0805 | RES-0805 | RES-0-1/8W
 |  |  | R22, R23, R24, R27, R30, R31, R33, R34, R35, R36 | 10 | 100K | 0805 | RES-0805 | RES-100K-1/8W
 |  |  | R28 | 1 | 300K | 0805 | RES-0805 | RES-300K-1/8W
 |  |  | R29 | 1 | 750K | 0805 | RES-0805 | RES-750K-1/8W
 |  |  | R32 | 1 | 150K | 0805 | RES-0805 | RES-150K-1/8W
 |  |  | R38, R39 | 2 | 33 | 0805 | RES-0805 | RES-33-1/8W
 |  |  | R42, R43, R44 | 3 | 680 | 0805 | RES-0805 | RES-680-1/8W
A106145DKR-ND (https://octopart-clicks.com/click/altium?sku=A106145DKR-ND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) | Digi-Key | 1625854-3 (https://octopart-clicks.com/click/altium?sku=A106145DKR-ND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) | TP1, TP2, TP3, TP4, TP5, TP6, TP7, TP8, TP9, TP10, TP11, TP12, TP13, TP14, TP15, TP16, TP17, TP18, TP19, TP20, TP21, TP22, TP23, TP24, TP25, TP26, TP27, TP28, TP29, TP30, TP31 | 31 | Test Point | 0603 | 0603 Test Point | Test Point
828-1064-6-ND (https://octopart-clicks.com/click/altium?sku=828-1064-6-ND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) | Digi-Key | BMP280 (https://octopart-clicks.com/click/altium?sku=828-1064-6-ND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) | U | 1 | BMP280 | Digital Pressure Sensor | LGA8 | BMP280
MMA8652FCR1DKR-ND (https://octopart-clicks.com/click/altium?sku=MMA8652FCR1DKR-ND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) | Digi-Key | MMA8652FCR1 (https://octopart-clicks.com/click/altium?sku=MMA8652FCR1DKR-ND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) | U1 | 1 | 3-Axis Accelerometer | 3-Axis, 12-bit Digital Accelerometer, I2C 400kHz | SON10 | MMA8652FC
FXAS21002CQR1CT-ND (https://octopart-clicks.com/click/altium?sku=FXAS21002CQR1CT-ND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) | Digi-Key | FXAS21002CQR1 (https://octopart-clicks.com/click/altium?sku=FXAS21002CQR1CT-ND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) | U2 | 1 | 3-Axis Gyroscope | 3-Axis Digital Angular Rate Gyroscope | QFN24 | FXAS21002C
497-15163-ND (https://octopart-clicks.com/click/altium?sku=497-15163-ND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) | Digi-Key | STM32F303RET6 (https://octopart-clicks.com/click/altium?sku=497-15163-ND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) | U3 | 1 | LQFP-64 STM32F303RE | ARM Cortex-M4 32-bit MCU+FPU | LQFP64 | STM32F303RET6
768-1130-6-ND (https://octopart-clicks.com/click/altium?sku=768-1130-6-ND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) | Digi-Key | FT230XQ-R (https://octopart-clicks.com/click/altium?sku=768-1130-6-ND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) | U7 | 1 | FTDI USB to UART | FTDI USB to UART | QFN16-0.65 | FT230XQ-R
535-12373-6-ND (https://octopart-clicks.com/click/altium?sku=535-12373-6-ND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) | Digi-Key | ABS06-107-32.768KHZ-T (https://octopart-clicks.com/click/altium?sku=535-12373-6-ND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) | X1 | 1 | 32.768 MHz, 4 pF | Crystal, 0805 | XTAL-0805 | XTAL-32.768kHz-4pF
535-9089-6-ND (https://octopart-clicks.com/click/altium?sku=535-9089-6-ND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) | Digi-Key | ABLS-8.000MHZ-B2-T (https://octopart-clicks.com/click/altium?sku=535-9089-6-ND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) | X2 | 1 | 8 MHz, 18 pF | Crystal, HC-49 | HC-49 | XTAL-8MHz-18pF
