vkottler/senior-design/cad/pcb/altium/outputs/power/BOM/Bill of Materials-power_dist.xlsx

Supplier Part Number 1 | Manufacturer Part Number 1 | Supplier 1 | Quantity | Designator | Comment | Description | Footprint | LibRef
541-3123-6-ND (https://octopart-clicks.com/click/altium?sku=541-3123-6-ND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) | WSLF2512L3000FEA (https://octopart-clicks.com/click/altium?sku=541-3123-6-ND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) | Digi-Key | 1 | R17 | 300u, 6W | 2512, 1% | RES-SHNT-2512 | RES-300u-6W
296-23087-6-ND (https://octopart-clicks.com/click/altium?sku=296-23087-6-ND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) | TPS54383PWPR (https://octopart-clicks.com/click/altium?sku=296-23087-6-ND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) | Digi-Key | 1 | U1 | Dual 3A Converter, 300kHz | Dual 3A Non-Synchronous Converters with Integrated High-Side MOSFET | 14-HTSSOP | TPS54383
296-2623-5-ND (https://octopart-clicks.com/click/altium?sku=296-2623-5-ND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) | TPS3705-33D (https://octopart-clicks.com/click/altium?sku=296-2623-5-ND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) | Digi-Key | 1 | U6 | IC_TPS3705-33DGN.1 | IC 2.93V PROCESSOR MONITOR 8MSOP | 8SOIC | IC_TPS3705-33DGN.1
360-2924-1-ND (https://octopart-clicks.com/click/altium?sku=360-2924-1-ND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) | SS312SAH4-R (https://octopart-clicks.com/click/altium?sku=360-2924-1-ND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) | Digi-Key | 1 | S1 | Slide Switch | 2mm Pitch | SMT Slide Switch RA | SMT Slide Switch
SRR1210-220MDKR-ND (https://octopart-clicks.com/click/altium?sku=SRR1210-220MDKR-ND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) | SRR1210-220M (https://octopart-clicks.com/click/altium?sku=SRR1210-220MDKR-ND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) | Digi-Key | 2 | L1, L2 | 22 uH | ±20%, 8 MHz res | IND-12mm | IND-22uH-38m-5.2A
SQJQ900E-T1_GE3DKR-ND (https://octopart-clicks.com/click/altium?sku=SQJQ900E-T1_GE3DKR-ND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) | SQJQ900E-T1_GE3 (https://octopart-clicks.com/click/altium?sku=SQJQ900E-T1_GE3DKR-ND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) | Digi-Key | 1 | Q2 | Dual N-Channel | Dual N-Channel 40V 100A | PowerPAK 8x8L | SQJQ900E
RMCF0603FT698RDKR-ND (https://octopart-clicks.com/click/altium?manufacturer=Stackpole%20Electronics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) | RMCF0603FT698R (https://octopart-clicks.com/click/altium?manufacturer=Stackpole%20Electronics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) | Digi-Key | 1 | R23 | 698 | 1%, 0603 | RES-0603 | RES-698-1/10W
311-422HRCT-ND (https://octopart-clicks.com/click/altium?sku=311-422HRCT-ND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) | RC0603FR-07422RL (https://octopart-clicks.com/click/altium?sku=311-422HRCT-ND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) | Digi-Key | 1 | R6 | 422 | 1%, 0603 | RES-0603 | RES-422-1/10W
311-6.34KHRDKR-ND (https://octopart-clicks.com/click/altium?sku=311-6.34KHRDKR-ND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) | RC0603FR-076K34L (https://octopart-clicks.com/click/altium?sku=311-6.34KHRDKR-ND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) | Digi-Key | 1 | R22 | 6.34K | 1%, 0603 | RES-0603 | RES-6.34K-1/10W
475-1410-1-ND (https://octopart-clicks.com/click/altium?sku=475-1410-1-ND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) | Q62702P5179 (https://octopart-clicks.com/click/altium?sku=475-1410-1-ND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) | Digi-Key | 3 | D3, D5, D6 | LED-WHT-20mA | 2.2V, 0805 | LED-0805 | LED-WHT-20mA
MBRS330T3GOSDKR-ND (https://octopart-clicks.com/click/altium?sku=MBRS330T3GOSDKR-ND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) | MBRS330T3G (https://octopart-clicks.com/click/altium?sku=MBRS330T3GOSDKR-ND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) | Digi-Key | 2 | D1, D2 | 30V, 4A | Schottky, SMC (DO-214AB) | DO-214AB-SMC | DIO-500mV-30V-4A
LTC4365CTS8#TRMPBFDKR-ND (https://octopart-clicks.com/click/altium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) | LTC4365CTS8#TRMPBF (https://octopart-clicks.com/click/altium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) | Digi-Key | 1 | U8 | Over, Under, Reverse Protection | Overvoltage, Undervoltage and Reverse Supply Protection Controller | SOT-23-8 | LTC4365
INA199B2DCKR-ND (https://octopart-clicks.com/click/altium?sku=INA199B2DCKR-ND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) | INA199B2DCKR (https://octopart-clicks.com/click/altium?sku=INA199B2DCKR-ND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) | Digi-Key | 1 | U5 | INA199B2 | 100 V/V, Current-Shunt Monitor | SC70 | INA199B2
490-5523-6-ND (https://octopart-clicks.com/click/altium?sku=490-5523-6-ND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) | GRM21BR61E106KA73L (https://octopart-clicks.com/click/altium?sku=490-5523-6-ND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) | Digi-Key | 4 | C5, C6, C9, C10 | 10 uF | ±10%, 0805 | CAP-CER-0805-TALL | CAP-CER-10uF-25V
RHM10DDKR-ND (https://octopart-clicks.com/click/altium?sku=RHM10DDKR-ND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) | ESR03EZPJ100 (https://octopart-clicks.com/click/altium?sku=RHM10DDKR-ND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) | Digi-Key | 2 | R1, R2 | 10 | 5%, 0603 | RES-0603 | RES-10-1/4W
P45.3KCDKR-ND (https://octopart-clicks.com/click/altium?sku=P45.3KCDKR-ND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) | ERJ-6ENF4532V (https://octopart-clicks.com/click/altium?sku=P45.3KCDKR-ND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) | Digi-Key | 1 | R14 | 45.3K | 1%, 0805 | RES-0805 | RES-45.3K-1/8W
P1.87BTDKR-ND (https://octopart-clicks.com/click/altium?sku=P1.87BTDKR-ND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) | ERJ-6ENF1874V (https://octopart-clicks.com/click/altium?sku=P1.87BTDKR-ND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) | Digi-Key | 1 | R13 | 1.87M | 1%, 0805 | RES-0805 | RES-1.87M-1/8W
P0.0GDKR-ND (https://octopart-clicks.com/click/altium?sku=P0.0GDKR-ND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) | ERJ-3GEY0R00V (https://octopart-clicks.com/click/altium?sku=P0.0GDKR-ND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) | Digi-Key | 2 | R9, R10 | 0 | 0603 | RES-0603 | RES-0-1/10W
P3.83KHDKR-ND (https://octopart-clicks.com/click/altium?sku=P3.83KHDKR-ND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) | ERJ-3EKF3831V (https://octopart-clicks.com/click/altium?sku=P3.83KHDKR-ND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) | Digi-Key | 1 | R5 | 3.83K | 1%, 0603 | RES-0603 | RES-3.83K-1/10W
P20.0KHDKR-ND (https://octopart-clicks.com/click/altium?sku=P20.0KHDKR-ND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) | ERJ3EKF-2002V (https://octopart-clicks.com/click/altium?sku=P20.0KHDKR-ND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) | Digi-Key | 2 | R3, R4 | 20K | 1%, 0603 | RES-0603 | RES-20K-1/10W
PCE3989DKR-ND, PCE4003DKR-ND (https://octopart-clicks.com/click/altium?manufacturer=Panasonic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) | EEE-FC1A101P, EEE-FC1E101P (https://octopart-clicks.com/click/altium?manufacturer=Panasonic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) | Digi-Key | 3 | C7, C8, C19 | 100 uF | ±20%, 8.3mm x 8.3mm | CAP-CAN-8.3x8.3 | CAP-CAN-100uF-10V, CAP-CAN-100uF-25V
541-54.9KCDKR-ND (https://octopart-clicks.com/click/altium?sku=541-54.9KCDKR-ND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) | CRCW080554K9FKEA (https://octopart-clicks.com/click/altium?sku=541-54.9KCDKR-ND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) | Digi-Key | 1 | R15 | 54.9K | 1%, 0805 | RES-0805 | RES-54.9K-1/8W
1276-6675-6-ND (https://octopart-clicks.com/click/altium?sku=1276-6675-6-ND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) | CL10B333KA8WPNC (https://octopart-clicks.com/click/altium?sku=1276-6675-6-ND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) | Digi-Key | 2 | C3, C4 | 0.033 uF | 10%, 0603 | CAP-CER-0603 | CAP-CER-0.033uF-25V
311-3377-6-ND (https://octopart-clicks.com/click/altium?sku=311-3377-6-ND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) | CC0603MRX7R9BB471 (https://octopart-clicks.com/click/altium?sku=311-3377-6-ND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) | Digi-Key | 2 | C11, C12 | 470 pF | 20%, 0603 | CAP-CER-0603 | CAP-CER-470pF-50V
445-14678-6-ND (https://octopart-clicks.com/click/altium?sku=445-14678-6-ND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) | C3216X5R1E106M085AC (https://octopart-clicks.com/click/altium?sku=445-14678-6-ND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) | Digi-Key | 2 | C1, C2 | 10 uF | ±20%, 1206 | CAP-CER-1206 | CAP-CER-10uF-25V-1206
399-8989-6-ND (https://octopart-clicks.com/click/altium?sku=399-8989-6-ND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) | C0603C103M3RACTU (https://octopart-clicks.com/click/altium?sku=399-8989-6-ND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) | Digi-Key | 1 | C14 | 10 nF | ±20%, 0603 | CAP-CER-0603 | CAP-CER-10nF-25V
732-7982-6-ND (https://octopart-clicks.com/click/altium?sku=732-7982-6-ND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) | 885012206064 (https://octopart-clicks.com/click/altium?sku=732-7982-6-ND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) | Digi-Key | 1 | C20 | 6.8 nF | ±10%, 0603 | CAP-CER-0603 | CAP-CER-6.8nF-25V
2N7002K-T1-E3DKR-ND (https://octopart-clicks.com/click/altium?manufacturer=Vishay%20Siliconix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) | 2N7002K-T1-E3 (https://octopart-clicks.com/click/altium?manufacturer=Vishay%20Siliconix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) | Digi-Key | 1 | Q1 | 2N7002K | N-Channel, SOT-23 | SOT-23-3 | NMOS-2.0VT-60VDS-300mA
 |  |  | 1 | C13 | 4.7 uF | ±10%, 0805 | CAP-CER-0805-TALL | CAP-CER-4.7uF-10V
 |  |  | 1 | P5 | 6Pos Pin Header | 0.1" Pitch 1x6 | 6Pos Pin Header JST | 6Pos Pin Header
 |  |  | 1 | P6 | 2Pos Pin Header | 0.1" Pitch 1x2 | 2Pos Pin Header JST | 2Pos Pin Header
 |  |  | 1 | P7 | 2Pos Screw Terminal | 0.2" Pitch 1x2 | 2Pos Screw Terminal | 2Pos Screw Terminal
 |  |  | 1 | R7 | 680 | 0805 | RES-0805 | RES-680-1/8W
 |  |  | 1 | R8 | 100K | 0805 | RES-0805 | RES-100K-1/8W
 |  |  | 1 | R19 | 27K | 0805 | RES-0805 | RES-27K-1/8W
 |  |  | 2 | C25, C26 | 0.1 uF | 10%, 0805 | CAP-CER-0805-SHORT | CAP-CER-0.1uF-25V
 |  |  | 2 | R16, R21 | 10K | 0805 | RES-0805 | RES-10K-1/8W
 |  |  | 2 | R18, R20 | 330 | 0805 | RES-0805 | RES-330-1/8W
 |  |  | 2 | R24, R25 | 0 | 0805 | RES-0805 | RES-0-1/8W
 |  |  | 4 | H1, H2, H3, H4 | Mount Hole |  | 4mm Mount Hole | Mount Hole
 |  |  | 4 | P1, P2, P3, P4 | ESC Power | 0.2" Pitch 1x2 | 2Pos Screw Terminal | ESC Power
