vkottler/senior-design/cad/pcb/altium/outputs/esc/BOM/Bill of Materials-esc.xlsx

Comment | Description | Designator | Footprint | LibRef | Manufacturer Part Number 1 | Quantity | Supplier 1 | Supplier Part Number 1
1 uF | 10%, 0805, ±10%, 0805 | C1, C2, C3, C20 | CAP-CER-0805-TALL | CAP-CER-1uF-10V |  | 4
0.1 uF | 10%, 0805 | C4, C5, C6, C7, C9, C12, C16, C18 | CAP-CER-0805-SHORT | CAP-CER-0.1uF-25V |  | 8
10 nF | 10%, 0805, ±10%, 0805 | C8, C14, C17 | CAP-CER-0805-SHORT | CAP-CER-10nF-50V |  | 3
22 pF | ±5%, 0805 | C10 | CAP-CER-0805-SHORT | CAP-CER-22pF-50V |  | 1
22uF | ±20%, 5.3mm x 5.3mm | C11 | CAP-CAN-5.3x5.3 | CAP-CAN-22uF-35V | EEE-FK1V220R (https://octopart-clicks.com/click/altium?sku=PCE3838DKR-ND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) | 1 | Digi-Key | PCE3838DKR-ND (https://octopart-clicks.com/click/altium?sku=PCE3838DKR-ND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)
220 uF | ±20%, 8.3mm x 8.3mm | C13 | CAP-CAN-8.3x8.3 | CAP-CAN-220uF-35V | EEE-1VA221UP (https://octopart-clicks.com/click/altium?sku=PCE3955DKR-ND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) | 1 | Digi-Key | PCE3955DKR-ND (https://octopart-clicks.com/click/altium?sku=PCE3955DKR-ND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)
0.22 uF | 10%, 0805 | C15 | CAP-CER-0805-SHORT | CAP-CER-0.22uF-50V |  | 1
0.47 uF | ±10%, 0805 | C19 | CAP-CER-0805-TALL | CAP-CER-0.47uF-50V |  | 1
Mount Hole |  | H1, H2, H3, H4 | m2 Mount Hole | Mount Hole |  | 4
3Pos Screw Terminal | 0.2" Pitch 1x3 | P1 | 3Pos Screw Terminal | 3Pos Screw Terminal |  | 1
3Pos Pin Header | 0.1" Pitch 1x3 | P2 | 3Pos Pin Header F RA R | 3Pos Pin Header |  | 1
2Pos Pin Header | 0.1" Pitch 1x2 | P3 | 2Pos Pin Header F RA R | 2Pos Pin Header |  | 1
2Pos Screw Terminal | 0.2" Pitch 1x2 | P4 | 2Pos Screw Terminal | 2Pos Screw Terminal |  | 1
P-Channel | P-Channel MOSFET | Q1, Q2, Q3 | DPAK | PMOS-1.9VT-40VDS-40A | AOD4189 (https://octopart-clicks.com/click/altium?manufacturer=Alpha%20%26%20Omega%20Semiconductor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) | 3 | Digi-Key | 785-1351-6-ND (https://octopart-clicks.com/click/altium?manufacturer=Alpha%20%26%20Omega%20Semiconductor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)
N-Channel | N-Channel MOSFET | Q4, Q5, Q6 | DPAK | NMOS-2.5VT-60VDS-35A | STD35NF06LT4 (https://octopart-clicks.com/click/altium?sku=497-7965-6-ND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) | 3 | Digi-Key | 497-7965-6-ND (https://octopart-clicks.com/click/altium?sku=497-7965-6-ND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)
1K | 0805 | R1, R2, R3, R7, R8, R9, R14 | RES-0805 | RES-1K-1/8W |  | 7
10K | 0805 | R4, R5, R6, R15 | RES-0805 | RES-10K-1/8W |  | 4
100K | 0805 | R10, R11 | RES-0805 | RES-100K-1/8W |  | 2
1m | 0805 | R12 | RES-1206 | RES-1m-1W | CSR1206-0R001F1 (https://octopart-clicks.com/click/altium?sku=696-1369-6-ND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) | 1 | Digi-Key | 696-1369-6-ND (https://octopart-clicks.com/click/altium?sku=696-1369-6-ND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)
33 | 0805 | R13, R16 | RES-0805 | RES-33-1/8W |  | 2
220K | 0805 | R17 | RES-0805 | RES-220K-1/8W |  | 1
5Pos DIP Switch | 5 Position 0.1" SMT Dip Switch | S1 | DIP-SW-5 | 5Pos DIP Switch | 219-5LPST (https://octopart-clicks.com/click/altium?sku=CT2195LPST-ND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) | 1 | Digi-Key | CT2195LPST-ND (https://octopart-clicks.com/click/altium?sku=CT2195LPST-ND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)
Test Point | 0603 | TP7, TP8, TP9, TP10 | 0603 Test Point | Test Point | 1625854-3 (https://octopart-clicks.com/click/altium?sku=A106145DKR-ND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) | 4 | Digi-Key | A106145DKR-ND (https://octopart-clicks.com/click/altium?sku=A106145DKR-ND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)
TB6575FNG | Sensorless 3-Phase BLDC Controller | U1 | SSOP24-0.65 | TB6575FNG | TB6575FNG,C,8,EL (https://octopart-clicks.com/click/altium?sku=TB6575FNGC8ELDKR-ND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) | 1 | Digi-Key | TB6575FNGC8ELDKR-ND (https://octopart-clicks.com/click/altium?sku=TB6575FNGC8ELDKR-ND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)
MOSFET Driver | 0.5A MOSFET Driver | U2, U3, U4 | SOT-23-6 | MCP14A0052 | MCP14A0052T-E/CH (https://octopart-clicks.com/click/altium?manufacturer=Microchip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) | 3 | Digi-Key | MCP14A0052T-E/CHDKR-ND (https://octopart-clicks.com/click/altium?manufacturer=Microchip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)
INA199A2 | 50 V/V, Current-Shunt Monitor | U5 | SC70 | INA199A2 | INA199A1DCKR (https://octopart-clicks.com/click/altium?sku=296-27329-6-ND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) | 1 | Digi-Key | 296-27329-6-ND (https://octopart-clicks.com/click/altium?sku=296-27329-6-ND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)
Comparator, Open-Drain | Comparator, Open-Drain | U6 | SOT-23-5 | LMC7221 | LMC7221BIM5X/NOPB (https://octopart-clicks.com/click/altium?manufacturer=TI%20National%20Semiconductor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) | 1 | Digi-Key | LMC7221BIM5X/NOPBDKR-ND (https://octopart-clicks.com/click/altium?manufacturer=TI%20National%20Semiconductor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)
Linear 5V 100mA | Linear Regulator, 5V, 100mA | U7 | SOT-89 | L78L05ACUTR | L78L05ACUTR (https://octopart-clicks.com/click/altium?sku=497-1183-6-ND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) | 1 | Digi-Key | 497-1183-6-ND (https://octopart-clicks.com/click/altium?sku=497-1183-6-ND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)
4.19 MHz, 15 pF | Ceramic, 3-SMD, Built-In Capacitance | X1 | CSTCR | XTAL-4.19MHz-15pF | CSTCR4M19G53-R0 (https://octopart-clicks.com/click/altium?sku=490-1201-6-ND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) | 1 | Digi-Key | 490-1201-6-ND (https://octopart-clicks.com/click/altium?sku=490-1201-6-ND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)
