vkottler/senior-design/logistics/BOM.ods

Flight
Item | Description | Supplier | Link | Unit Price | Quantity | Total
Quadcopter chassis | Physical kit, defines form-factor | Amazon | https://www.amazon.com/gp/product/B0776WLHX7/ | 18.99 | 1 | 18.99
 |  |  |  |  |  | 0
 |  |  |  |  |  | 0
 |  |  |  |  |  | 0
 |  |  |  |  |  | 0
 |  |  |  |  |  | 0
 |  |  |  |  |  | 0
 |  |  |  |  |  | 0
 |  |  |  |  |  | 0
Overall Total: |  |  |  |  |  | 18.99
Ground
Item | Description | Supplier | Link | Unit Price | Quantity | Total
 |  |  |  |  |  | 0
 |  |  |  |  |  | 0
 |  |  |  |  |  | 0
 |  |  |  |  |  | 0
 |  |  |  |  |  | 0
 |  |  |  |  |  | 0
 |  |  |  |  |  | 0
 |  |  |  |  |  | 0
 |  |  |  |  |  | 0
Overall Total: |  |  |  |  |  | 0
Display / Controller
Item | Description | Supplier | Link | Unit Price | Quantity | Total
 |  |  |  |  |  | 0
 |  |  |  |  |  | 0
 |  |  |  |  |  | 0
 |  |  |  |  |  | 0
 |  |  |  |  |  | 0
 |  |  |  |  |  | 0
 |  |  |  |  |  | 0
 |  |  |  |  |  | 0
 |  |  |  |  |  | 0
Overall Total: |  |  |  |  |  | 0
