vkottler/senior-design/cad/mech/freecad/esc_case.FCStd

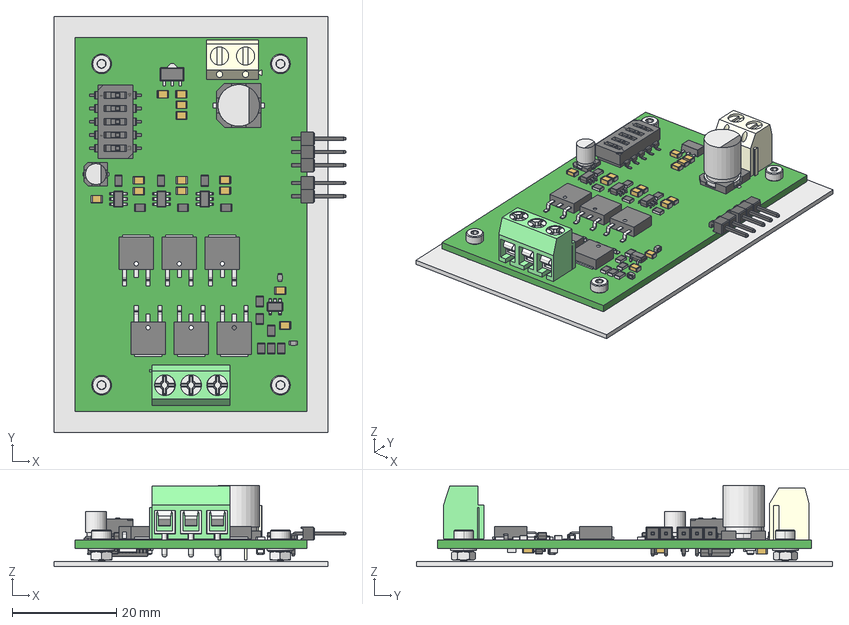
[picture p40: CAD file, 2018-10-31]
cad/mech/freecad/esc_case.FCStd
55.9 x 79.8 x 15.6 mm
Board
M2_x_0.4mm_Thread_4mm_LONG_SOCKET_HEAD_CAP_SCREW
M2_x_0.4mm_Thread_4mm_LONG_SOCKET_HEAD_CAP_SCREW001
M2_x_0.4mm_Thread_4mm_LONG_SOCKET_HEAD_CAP_SCREW002
M2_x_0.4mm_Thread_4mm_LONG_SOCKET_HEAD_CAP_SCREW003
CSTCR4M19
CSTCR4M020
CSTCR4M021
CSTCR4M022
CSTCR4M023
Open_CASCADE_STEP_translator_6.8_4.1.1
top
bottom
Open_CASCADE_STEP_translator_6.8_4.4.1
Open_CASCADE_STEP_translator_6.8_42.1.1
Leader
Leader001
Leader002
Leader003
Leader004
Open_CASCADE_STEP_translator_6.8_1.1.1
Leader005
Leader006
Leader007
Leader008
Leader009
Leader010
Open_CASCADE_STEP_translator_6.8_12.1.1
Leader011
Leader012
Leader013
Leader014
Leader015
Leader016
Open_CASCADE_STEP_translator_6.8_12.1.002
Leader017
Leader018
Leader019
Leader020
Leader021
Leader022
Open_CASCADE_STEP_translator_6.8_12.1.003
Leader023
Leader024
Leader025
Leader026
Leader027
Leader028
Open_CASCADE_STEP_translator_6.8_13.1
Open_CASCADE_STEP_translator_6.8_13.2.1
Leader029
Leader030
Leader031
Leader032
Leader033
Leader034
Leader035
Leader036
Leader037
Leader038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
