vkottler/senior-design/cad/mech/freecad/outputs/quadcopter_bottom_plate.step

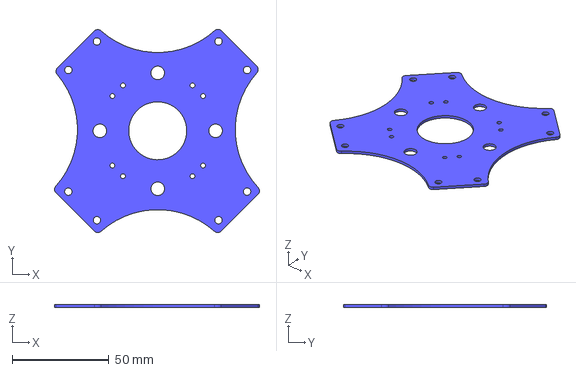
[picture p41: CAD file, 2018-11-11]
cad/mech/freecad/outputs/quadcopter_bottom_plate.step
106.2 x 105.3 x 1.50 mm
