vkottler/senior-design/coursework/lab_1/Lab1_PWR/Step_Models/DO-214AC.stp

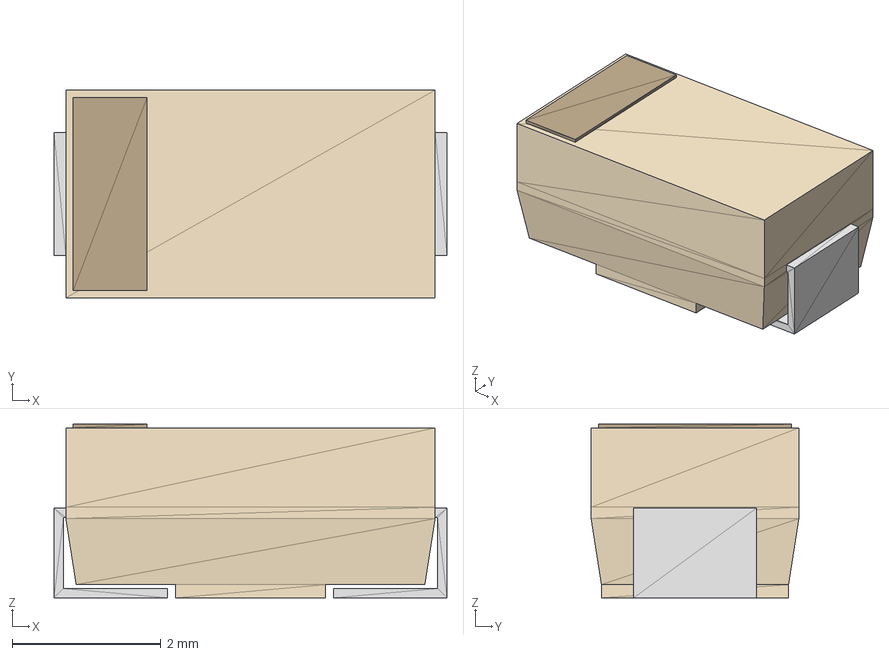
[picture p42: CAD file, 2018-09-27]
coursework/lab_1/Lab1_PWR/Step_Models/DO-214AC.stp
5.28 x 2.79 x 2.34 mm
