vkottler/senior-design/cad/mech/freecad/CSTCR4M19.FCStd

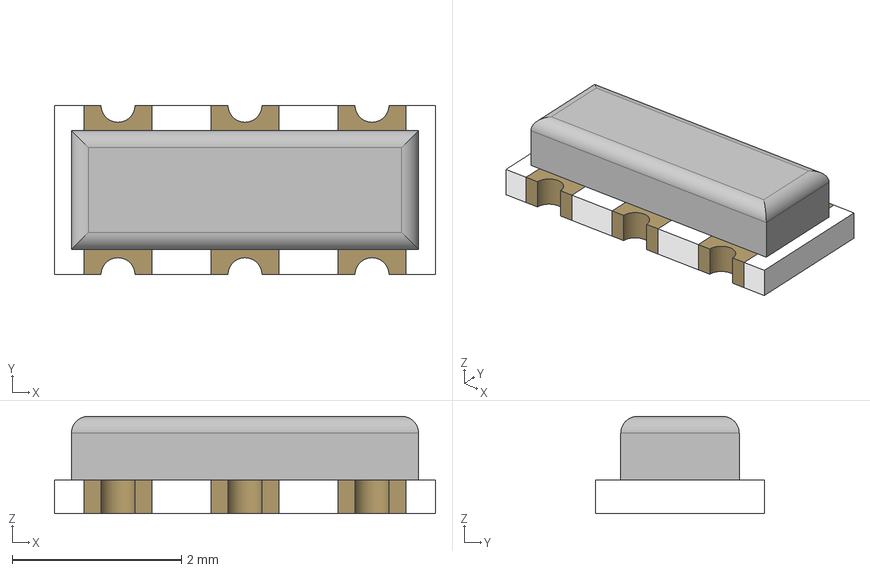
[picture p43: CAD file, 2018-10-29]
cad/mech/freecad/CSTCR4M19.FCStd
4.50 x 2.00 x 1.15 mm
lid
base_cut2
