vkottler/senior-design/cad/mech/freecad/outputs/quadcopter_top_plate.step

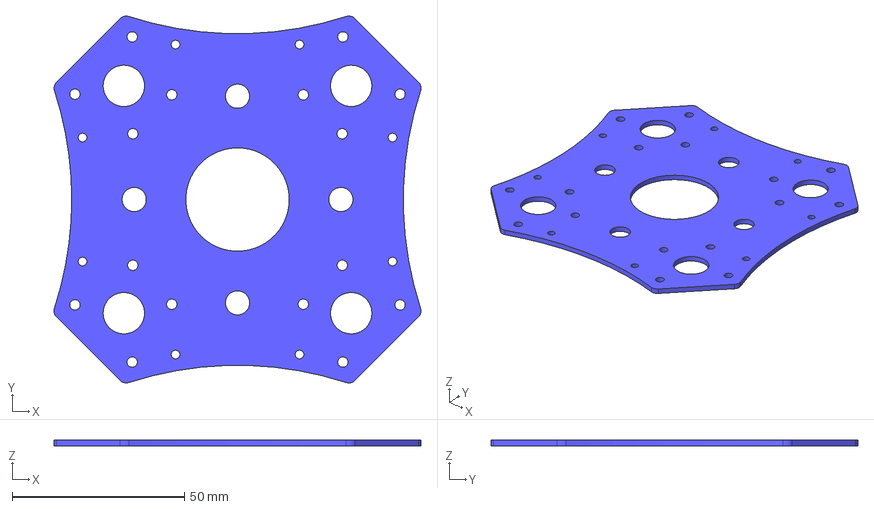
[picture p44: CAD file, 2018-11-11]
cad/mech/freecad/outputs/quadcopter_top_plate.step
106.5 x 106.5 x 1.75 mm
