vkottler/senior-design/coursework/lab_1/Lab1_PWR/Step_Models/PCAP_8x10-ELECT.stp

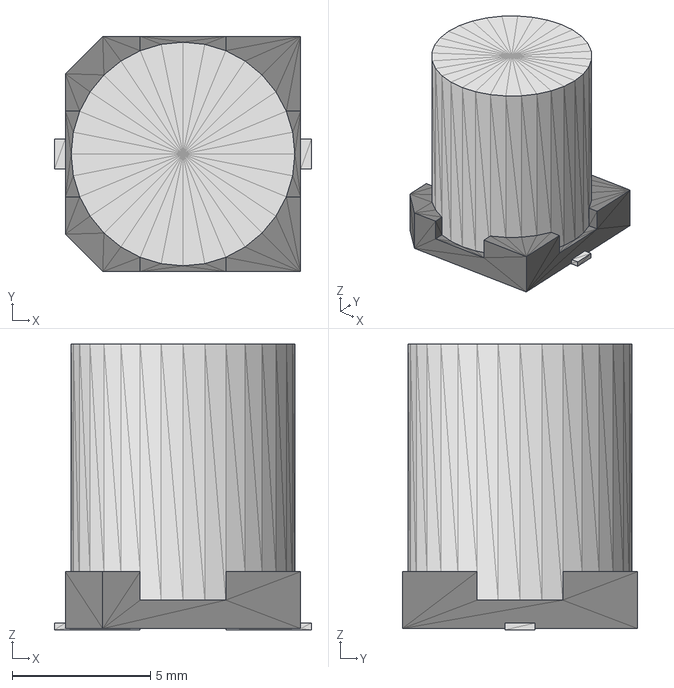
[picture p45: CAD file, 2018-09-27]
coursework/lab_1/Lab1_PWR/Step_Models/PCAP_8x10-ELECT.stp
9.30 x 8.51 x 10.3 mm
