vkottler/senior-design/coursework/lab_1/Lab1_PWR/Step_Models/D8.stp

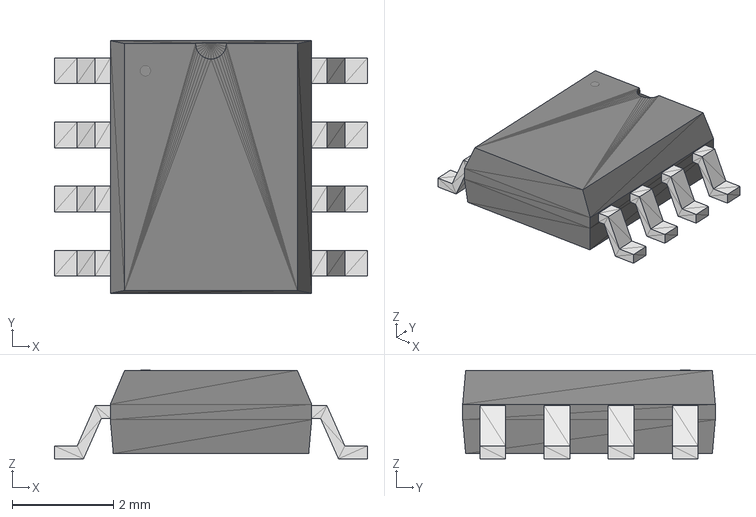
[picture p46: CAD file, 2018-09-27]
coursework/lab_1/Lab1_PWR/Step_Models/D8.stp
6.20 x 5.00 x 1.75 mm
