vkottler/senior-design/coursework/lab_1/Lab1_PWR/Step_Models/0805_single.stp

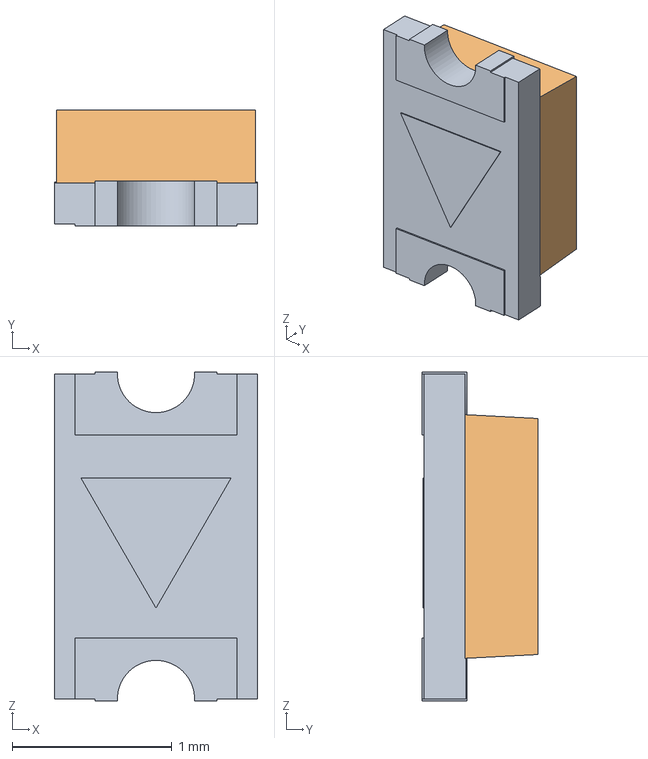
[picture p47: CAD file, 2018-09-27]
coursework/lab_1/Lab1_PWR/Step_Models/0805_single.stp
1.27 x 0.724 x 2.06 mm
