vkottler/senior-design/coursework/lab_1/Lab1_PWR/Step_Models/C0805C104M5RACTU.step

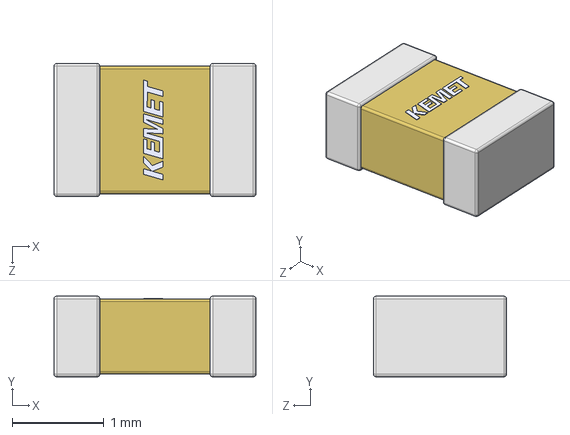
[picture p48: CAD file, 2018-09-27]
coursework/lab_1/Lab1_PWR/Step_Models/C0805C104M5RACTU.step
2.20 x 0.88 x 1.45 mm
