vkottler/senior-design/coursework/lab_1/Lab1_PWR/Step_Models/DBV5.stp

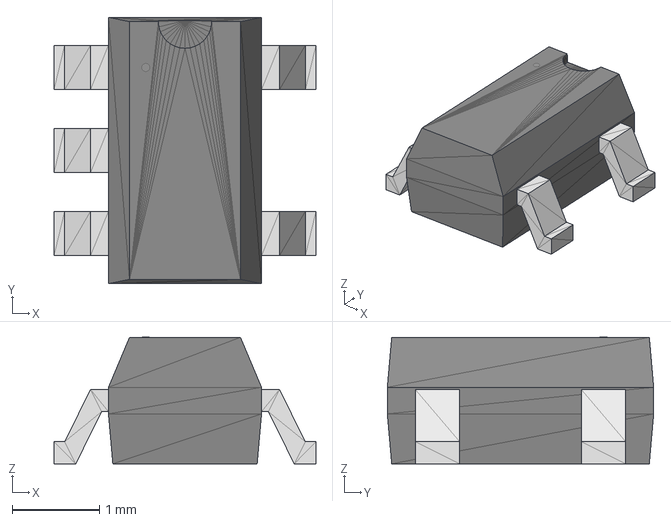
[picture p49: CAD file, 2018-09-27]
coursework/lab_1/Lab1_PWR/Step_Models/DBV5.stp
3.00 x 3.05 x 1.45 mm
