vkottler/senior-design/coursework/lab_1/Lab1_PWR/Step_Models/SBH11-_ _ _C-D08-ST-_ _.STEP

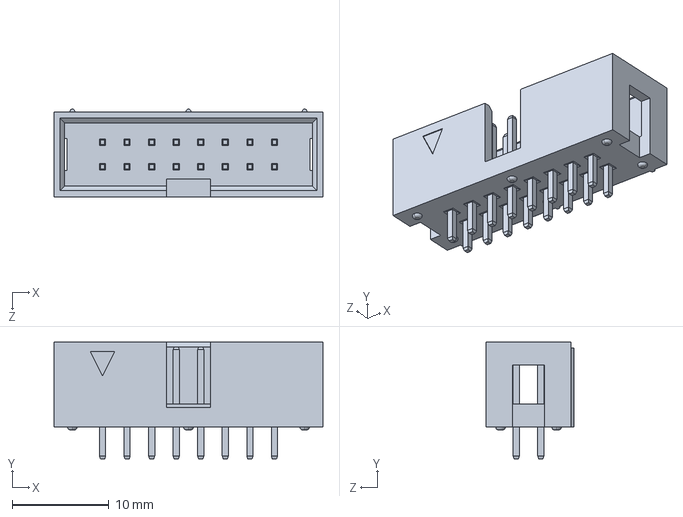
[picture p50: CAD file, 2018-09-17]
coursework/lab_1/Lab1_PWR/Step_Models/SBH11-_ _ _C-D08-ST-_ _.STEP
27.8 x 12.1 x 9.10 mm
