vkottler/senior-design/coursework/lab_1/Lab1_PWR/Step_Models/ASPI-8040S.STEP

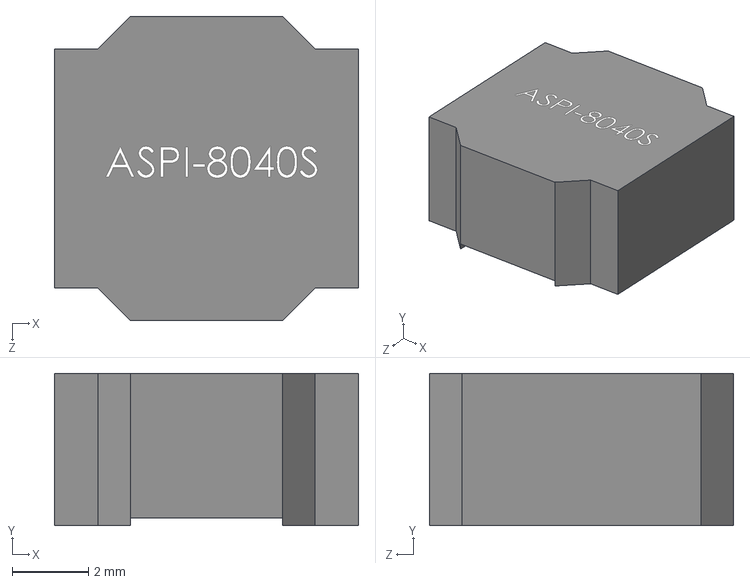
[picture p52: CAD file, 2018-09-17]
coursework/lab_1/Lab1_PWR/Step_Models/ASPI-8040S.STEP
8.00 x 4.00 x 8.00 mm
