vkottler/senior-design/coursework/lab_1/Lab1_PWR/Step_Models/SFH11-P_ _C-D05-ST-_ _.STEP

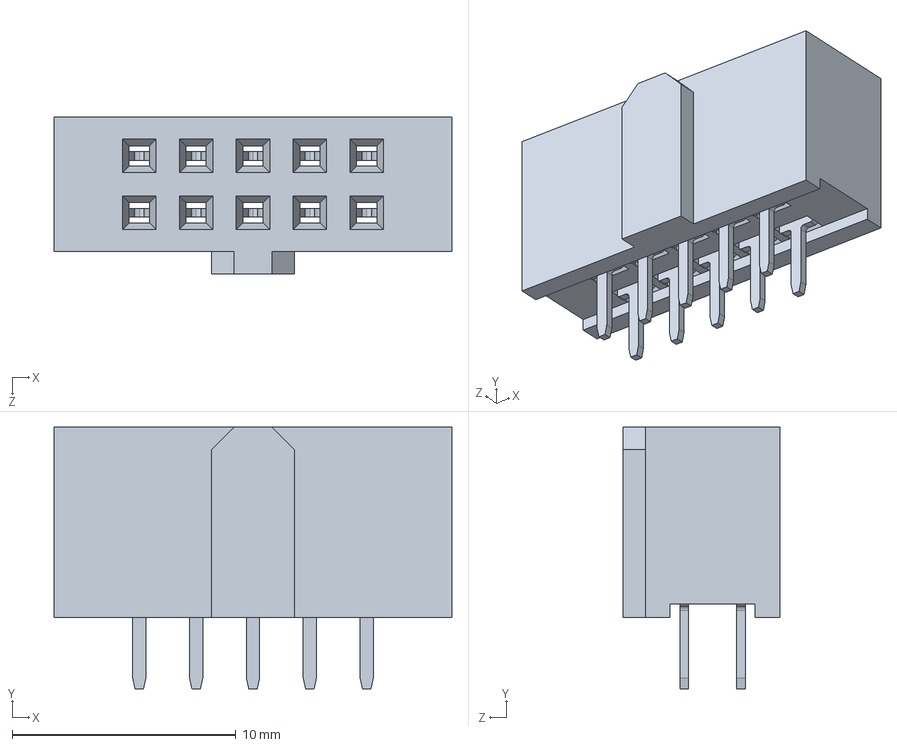
[picture p53: CAD file, 2018-09-17]
coursework/lab_1/Lab1_PWR/Step_Models/SFH11-P_ _C-D05-ST-_ _.STEP
17.8 x 11.7 x 7.00 mm
