vkottler/senior-design/coursework/lab_1/Lab1_PWR/Step_Models/CUI_PJ-002A.step

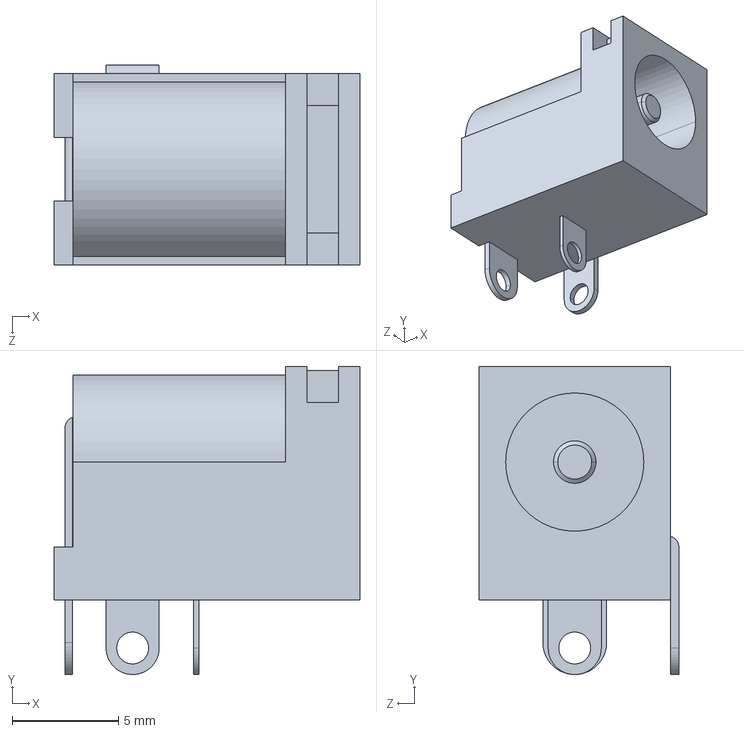
[picture p55: CAD file, 2018-09-17]
coursework/lab_1/Lab1_PWR/Step_Models/CUI_PJ-002A.step
14.4 x 14.5 x 9.40 mm
