vkottler/senior-design/cad/mech/freecad/ext/M2 x 0.4mm Thread HEX NUT.STEP

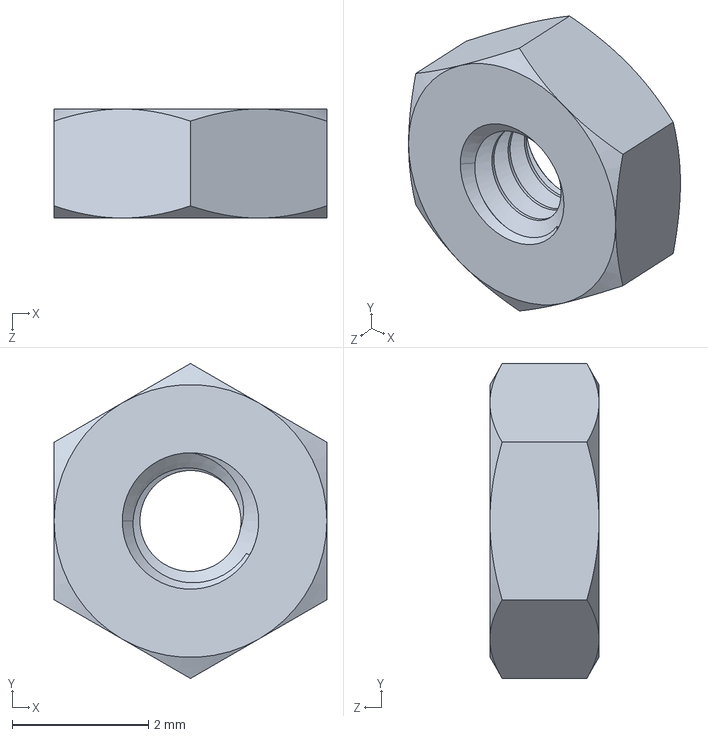
[picture p56: CAD file, 2018-10-31]
cad/mech/freecad/ext/M2 x 0.4mm Thread HEX NUT.STEP
4.00 x 4.62 x 1.60 mm
