vkottler/senior-design/cad/mech/freecad/ext/M2 screw size FLAT WASHER.STEP

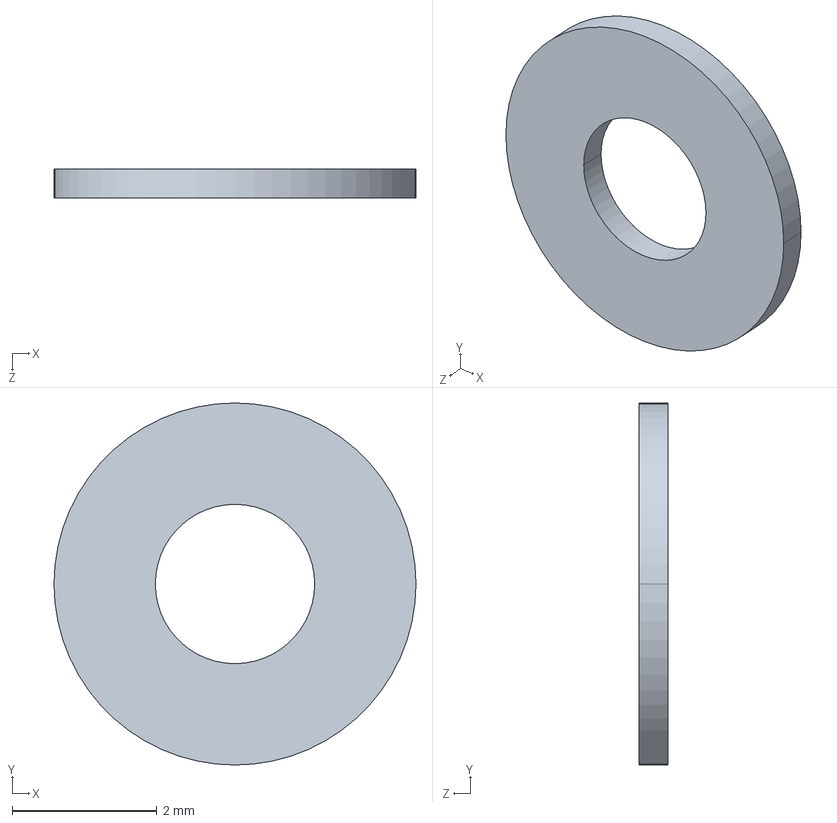
[picture p57: CAD file, 2018-10-31]
cad/mech/freecad/ext/M2 screw size FLAT WASHER.STEP
5.00 x 5.00 x 0.4 mm
