vkottler/senior-design/(list of files, cad)

Other CAD files:
cad/mech/freecad/outputs/quadcopter_bottom_plate.iges
cad/mech/freecad/outputs/quadcopter_bottom_plate.stl
cad/mech/freecad/outputs/quadcopter_top_plate.iges
cad/mech/freecad/outputs/quadcopter_top_plate.stl
