vkottler/senior-design/(threads)

Thread 2 (2018-08-12):

Create a top-level, "design intent" schematic

vkottler, 2018-08-12:
This won't be used to create a PCB, it is meant to portray the role of each PCB in the flight assembly or ground control system.

vkottler, 2018-09-06:
This would probably be much better as a [draw.io](https://www.draw.io/) document. @csgreen3 thoughts?

vkottler, 2018-09-06:
+ @katwalmayank, this is probably the first thing we need to do before we can make a legit proposal

vkottler, 2018-09-06:
[link to blank diagram](https://drive.google.com/file/d/1rurwICLfF9FT-KkoWSi40zP4c_TbZiYE/view?usp=sharing)

vkottler, 2018-09-20:
Block diagrams and proposal complete

Closed 2018-09-20.

Thread 18 (2018-09-17):

Required Material: Testing RF Radios

csgreen3, 2018-09-17:
- Breadboard x2
- JTAG Programmer
- 5V power supply and micro USB x2
- Jumper wire and bread board wire
- Resistors and Capacitors

vkottler, 2018-09-17:
One consideration is that we need to power these guys off batteries so we can be mobile and test the range.

Right now I'm thinking just 1.5V AA batteries because I have the battery holders at home

* 1.5V AA battery holders (3x)
* AA batteries
* LDO 5V / 3.3V regulator to power boards in that configuration

vkottler, 2018-09-20:
Brought quite a bit of stuff, we should have what we need

Closed 2018-09-20.

Thread 20 (2018-09-20):

Gather DE1-SoC documentation and reference materials

vkottler, 2018-09-20:
We want to make a new top-level directory for assets for this platform (I'm impartial to the name)

Inside this directory we want to create a `manuals` (or `man`) directory and put any useful literature we find in it.

This platform directory will also eventually contain our assets for production code running on the device (should be reserved for more of the deeply embedded / platform-specific stuff, not high-level code that runs natively on Ubuntu / x86)

vkottler, 2018-09-22:
[terasIC page to buy / look at product](https://www.terasic.com.tw/cgi-bin/page/archive.pl?Language=English&No=836), resources page indicates we'll need to find out the board rev ([how to check](https://www.terasic.com.tw/cgi-bin/page/archive.pl?Language=English&No=886))

vkottler, 2018-10-20:
Looks like we found a manual, probably will be enough

Closed 2018-10-20.

Thread 22 (2018-09-20):

Develop a "wire-level" telemetry protocol

vkottler, 2018-09-20:
We intend to use WebSocket to stream data from an arbitrary backend / data source to our UI.

We need to choose a serialized data format to send over this interface. JSON or another ASCII representation is probably simpler than some kind of binary format but work on this protocol should include a basic demo of streaming data to the UI from a program running on another device (any arbitrary language)

The protocol should be particularly good at handling changes in the schema of the data being received on the fly

katwalmayank, 2018-09-20:
Yeah makes sense. Initially I was thinking JSON, do you think that is still feasible or what?

vkottler, 2018-09-20:
I think JSON is definitely viable. This work would include coming up with a flexible schedule and to use on top of JSON

vkottler, 2018-10-19:
I ended up going in a completely different direction for this to support the embedded case (telemetry over radios at 115200 baud). Hoping to have a demo soon

vkottler, 2018-10-20:
This is now scoped to an entire separate repository

Closed 2018-10-20.

Thread 27 (2018-10-02):

Establish simulation infrastructure

vkottler, 2018-10-02:
We need to develop a control algorithm to fly and it needs to be "executable" with simulated inputs, which includes simulating the feedback loop(s) inherent to changing the outputs.

## List of Inputs

* IMU (fx, fy, fz)
* gyro (ax, ay, az)

## List of Outputs

* motors 1-4

vkottler, 2018-10-02:
Initial thought is that this should be a "Python wrapper" that calls the exact same C function responsible for the control algorithm when executing on a workstation (i.e. compiled for x86_64).

We probably want to tie this into some telemetry visualization so a custom GUI can be used to tune the algorithm and disrupt the system to see what happens

vkottler, 2018-10-02:
Need to characterize torque of the motors, their distance "from the origin" and the geometry of the propellers to get a good model for thrust vs. RPM

vkottler, 2018-10-02:
Need equations to represent how we expect the sensor inputs to be affected based on force vectors / angular momentum due to RPM, that would probably be the best start

vkottler, 2018-10-02:
probably want the option to select running in "real time" or running a sequence with simulated time all at once and exporting the data

vkottler, 2018-10-19:
Almost have telemetry ready, can then re-visit how this needs to work. It's looking like it will become increasingly difficult in Python but we likely can't ditch Python because of the easy WebSocket integration
