vkottler/senior-design/coursework/lab_1/Lab1_PWR/Output/Schematics/ECE453_PWR.PDF

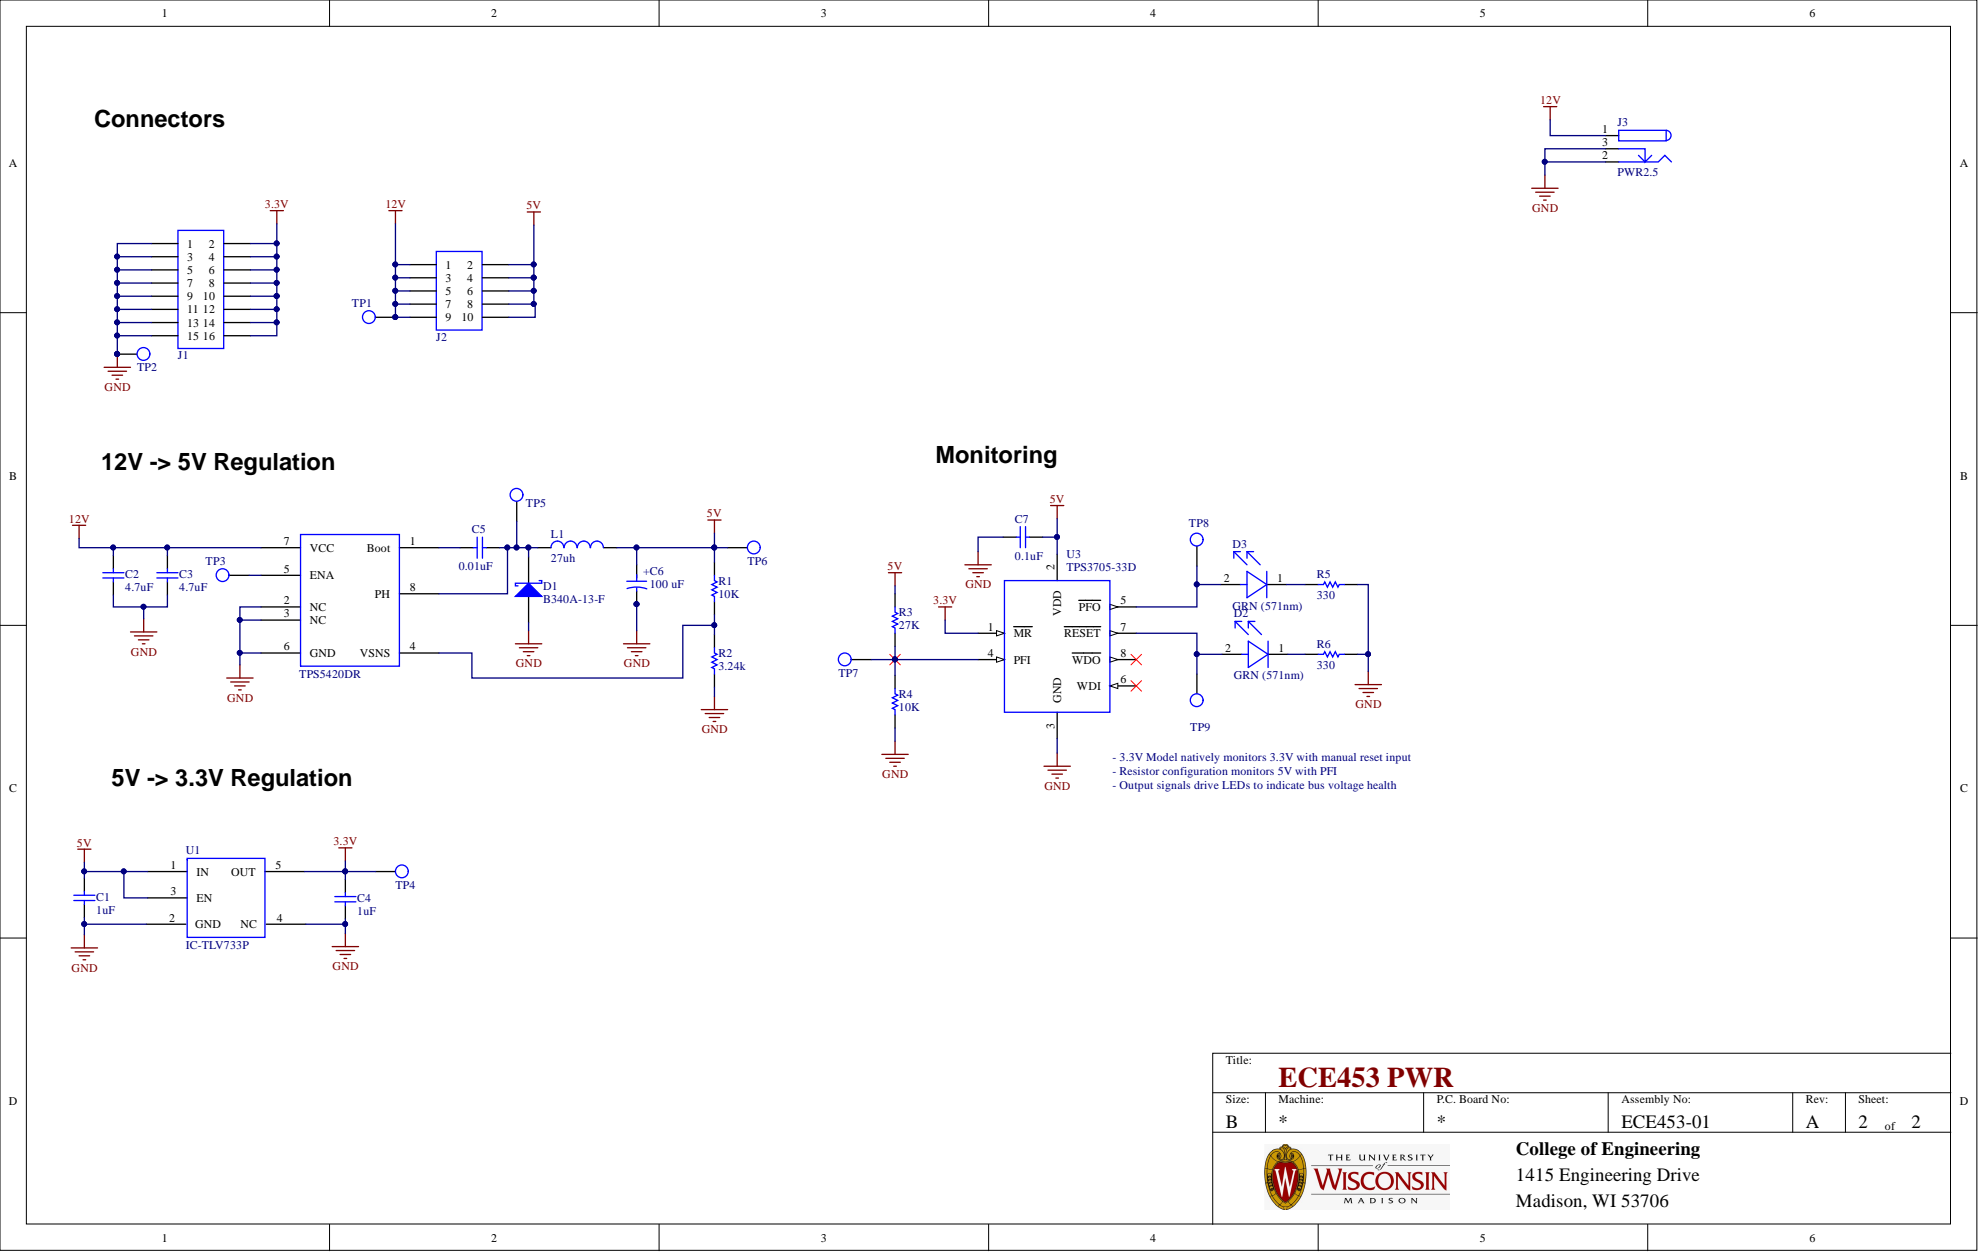
[picture p58: page 1]

- 3.3V Model natively monitors 3.3V with manual reset input
- Resistor configuration monitors 5V with PFI
- Output signals drive LEDs to indicate bus voltage health

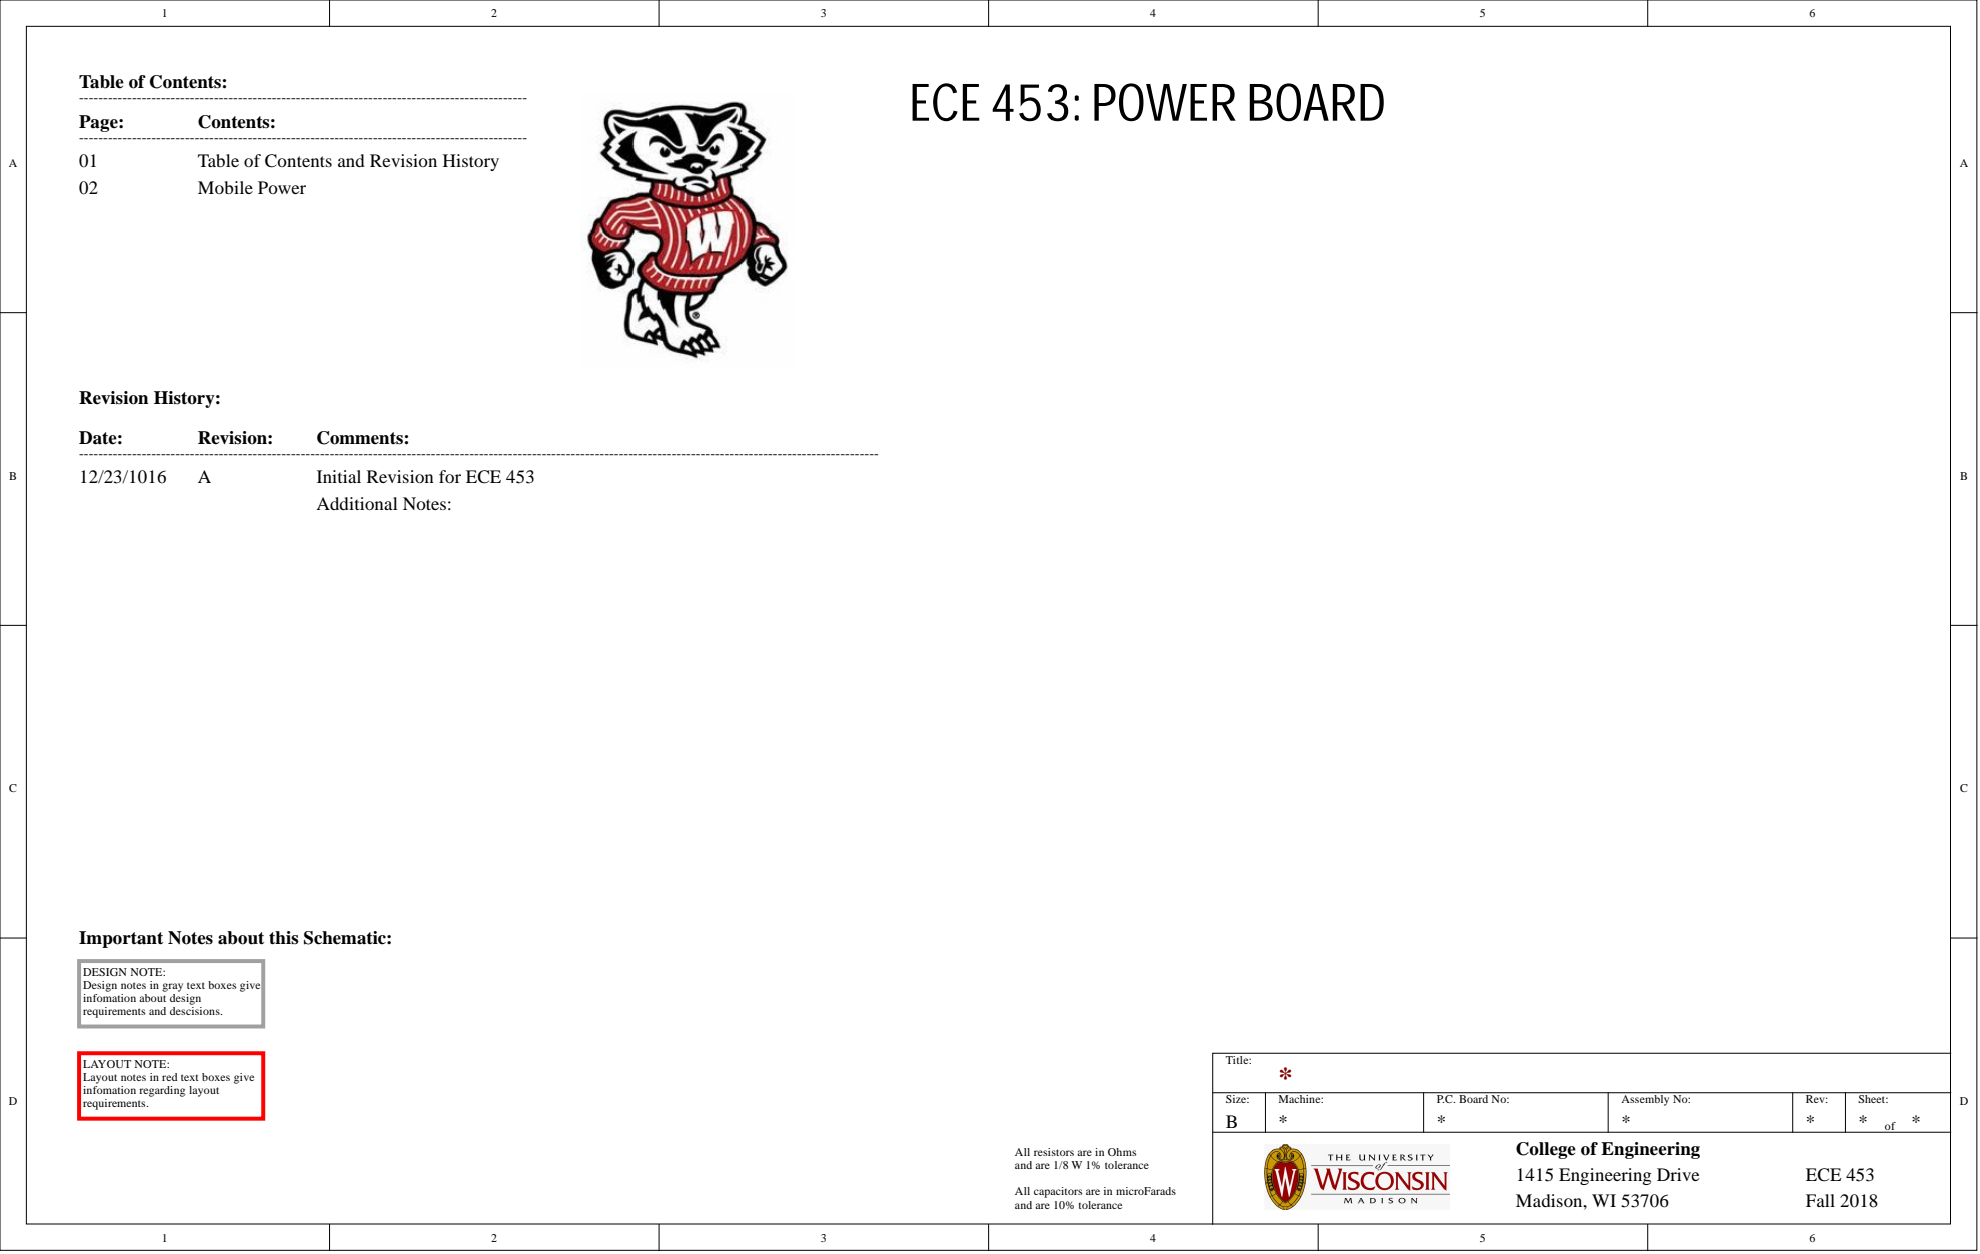
[picture p59: page 2]

Table of Contents and Revision History

Important Notes about this Schematic:

DESIGN NOTE:
Design notes in gray text boxes give
infomation about design
requirements and descisions.

LAYOUT NOTE:
Layout notes in red text boxes give
infomation regarding layout
requirements.

All resistors are in Ohms
and are 1/8 W 1% tolerance

All capacitors are in microFarads
and are 10% tolerance
