vkottler/senior-design/coursework/lab_1/InterfaceBoard/ECE453_Interface_Board.PDF

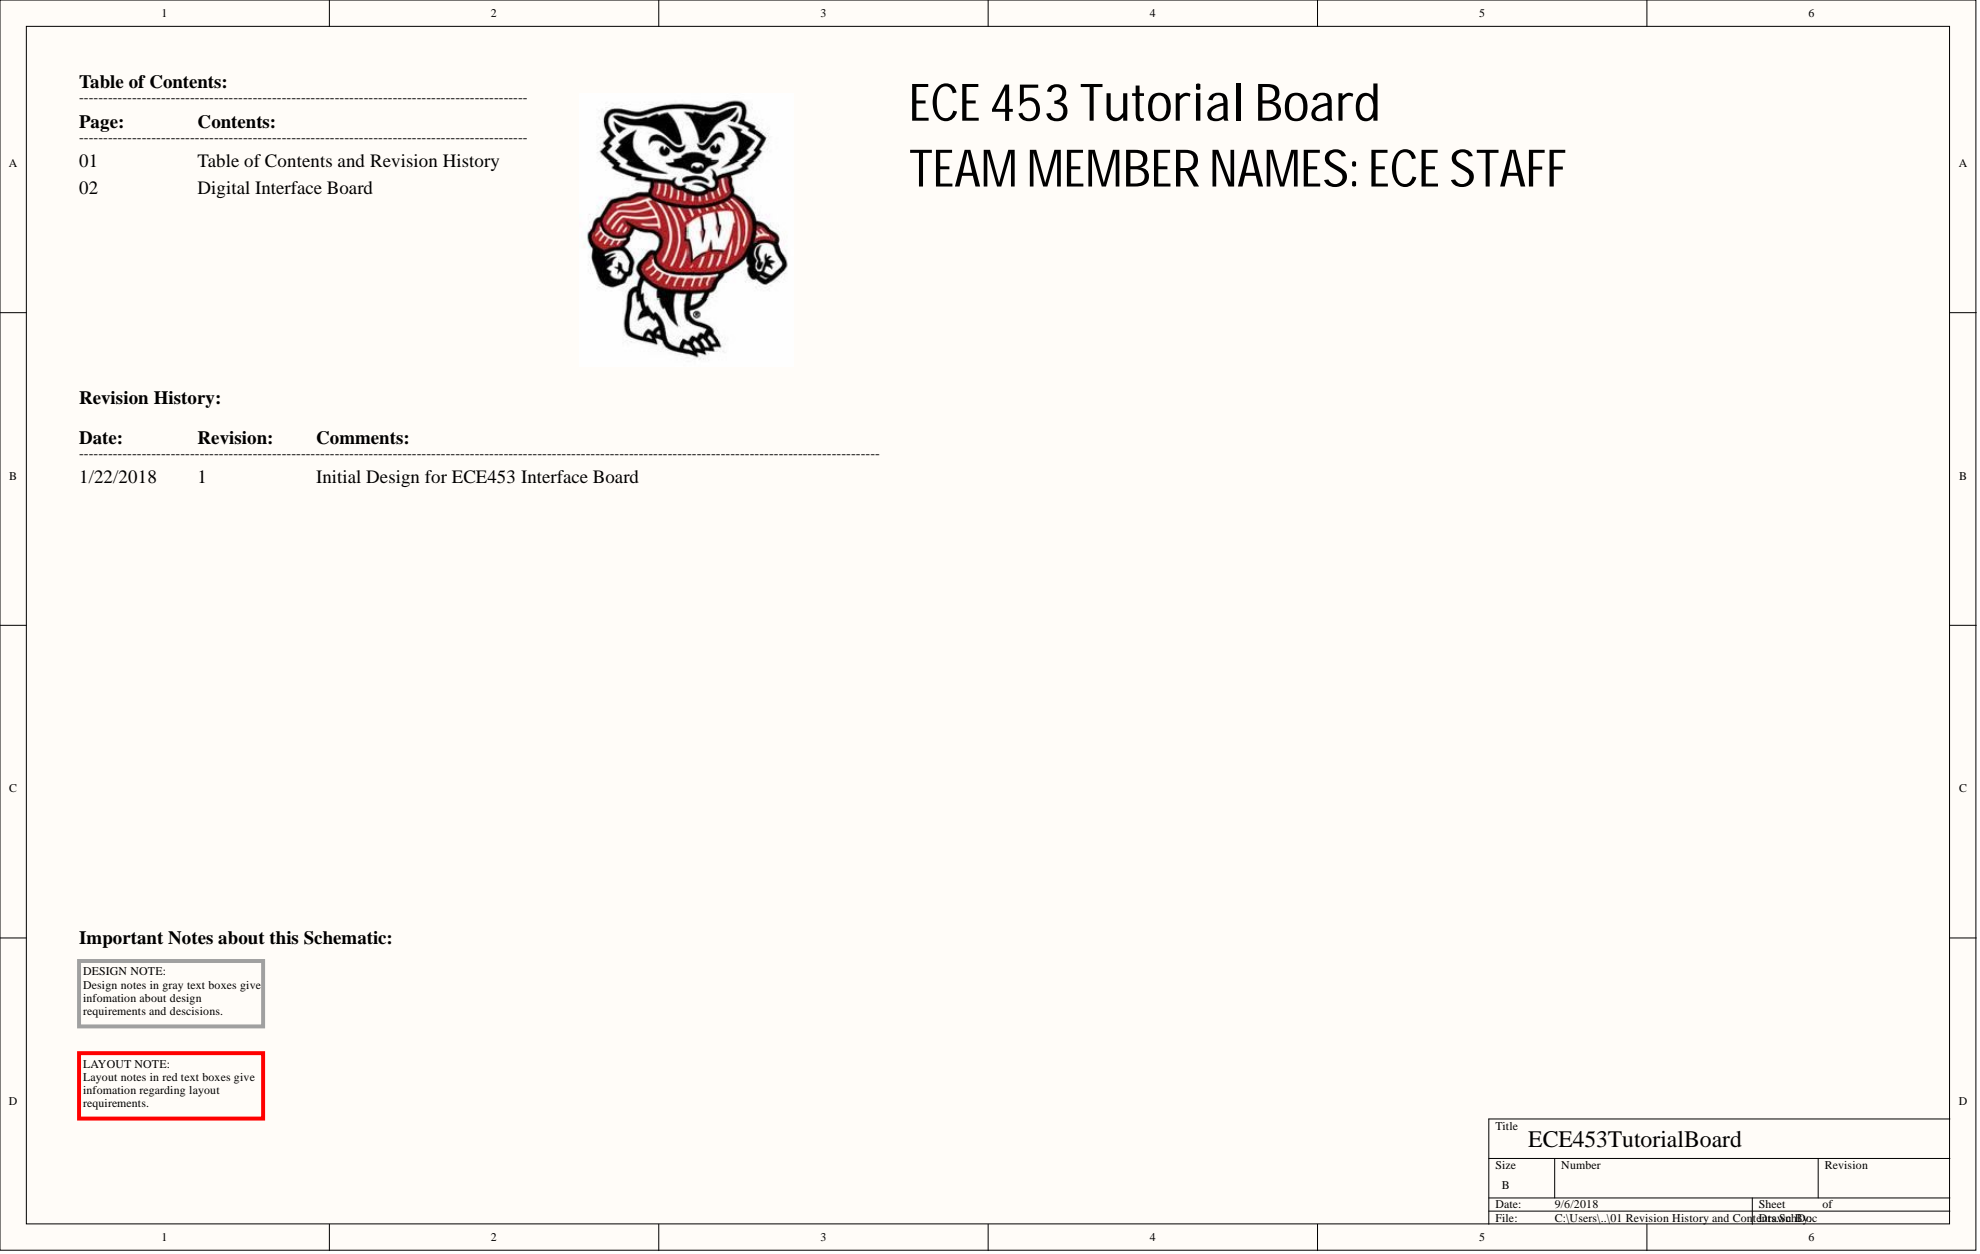
[picture p60: page 1]

ECE 453 Tutorial Board
TEAM MEMBER NAMES: ECE STAFF

Table of Contents and Revision History
Digital Interface Board

Important Notes about this Schematic:

DESIGN NOTE:
Design notes in gray text boxes give
infomation about design
requirements and descisions.

LAYOUT NOTE:
Layout notes in red text boxes give
infomation regarding layout
requirements.

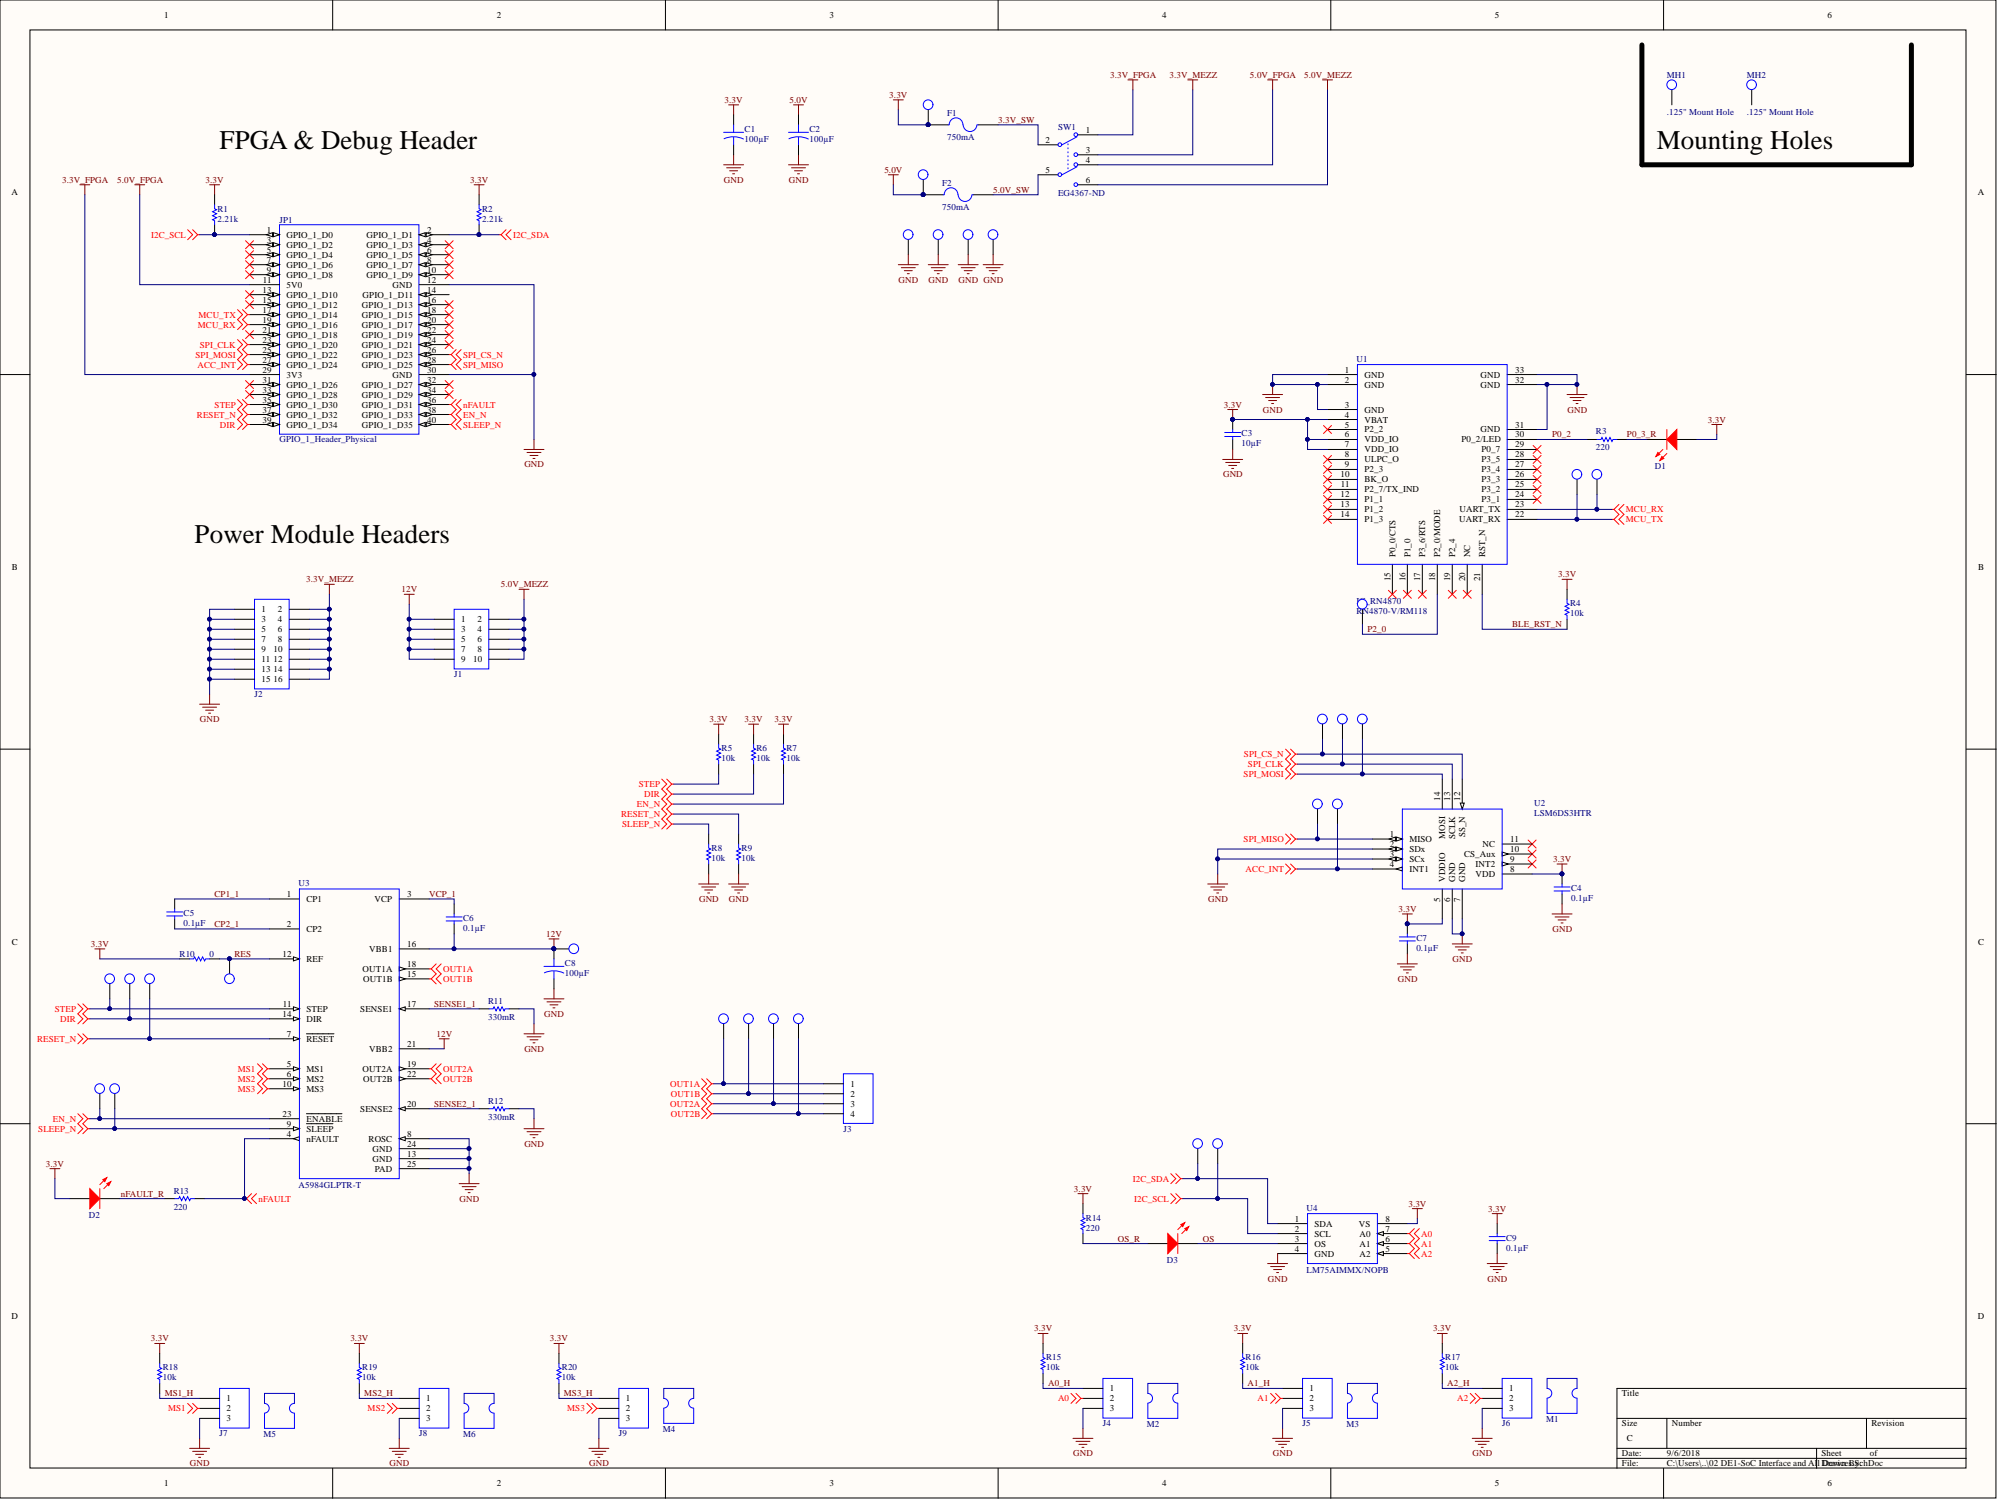
[picture p61: page 2]

VDD_IO 7
