vkottler/senior-design/cad/pcb/altium/outputs/quadcopter_esc.PDF

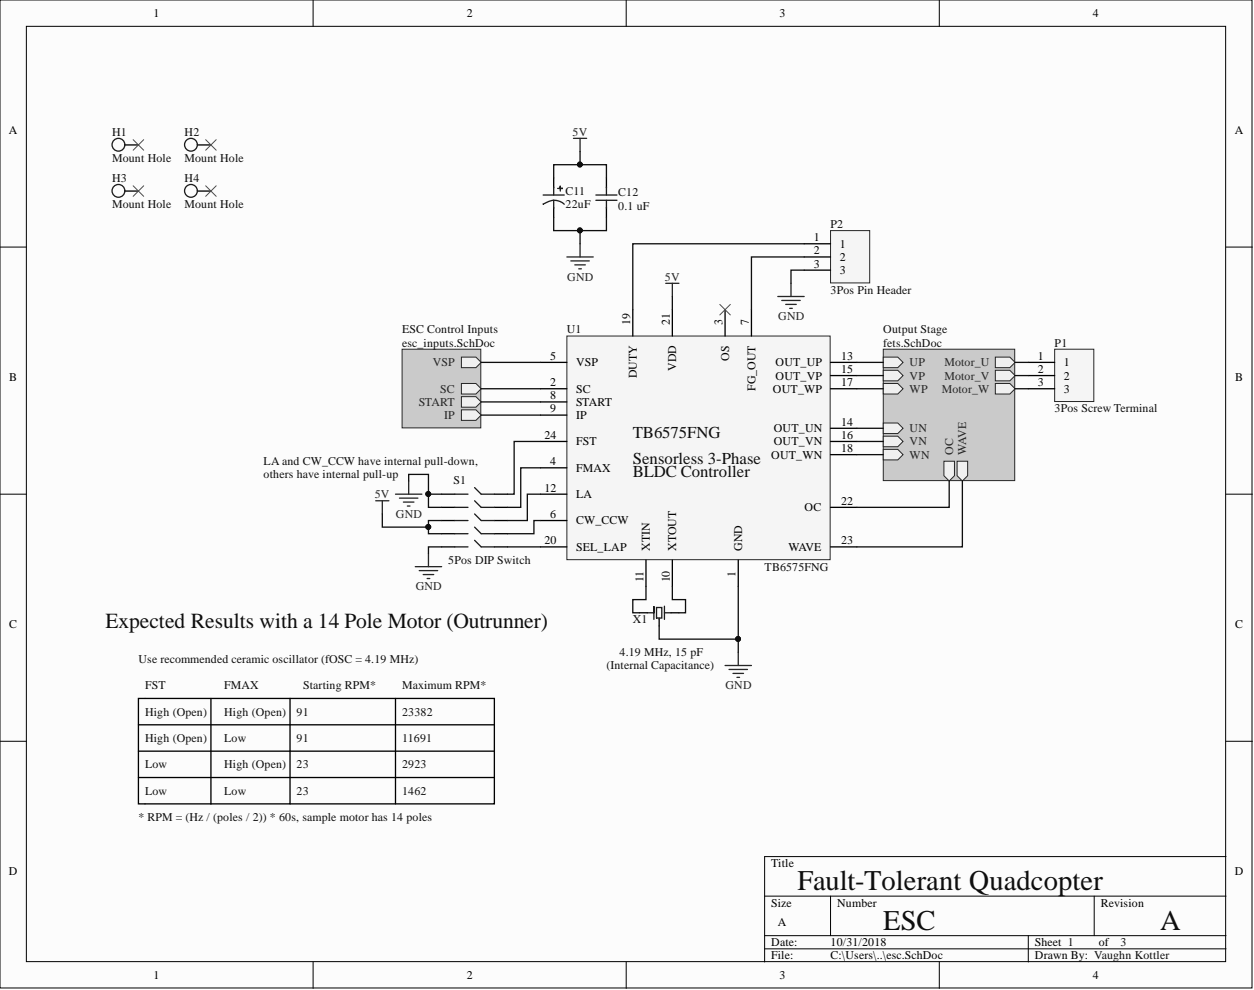
[picture p62: page 1]

H i g h (O pen ) | H i g h (O pen ) | 9 1 | 2 3 3 8 2

H i g h (O pen ) | L o w | 9 1 | 1 1 6 9 1

L o w | H i g h (O pen ) | 2 3 | 2 9 2 3

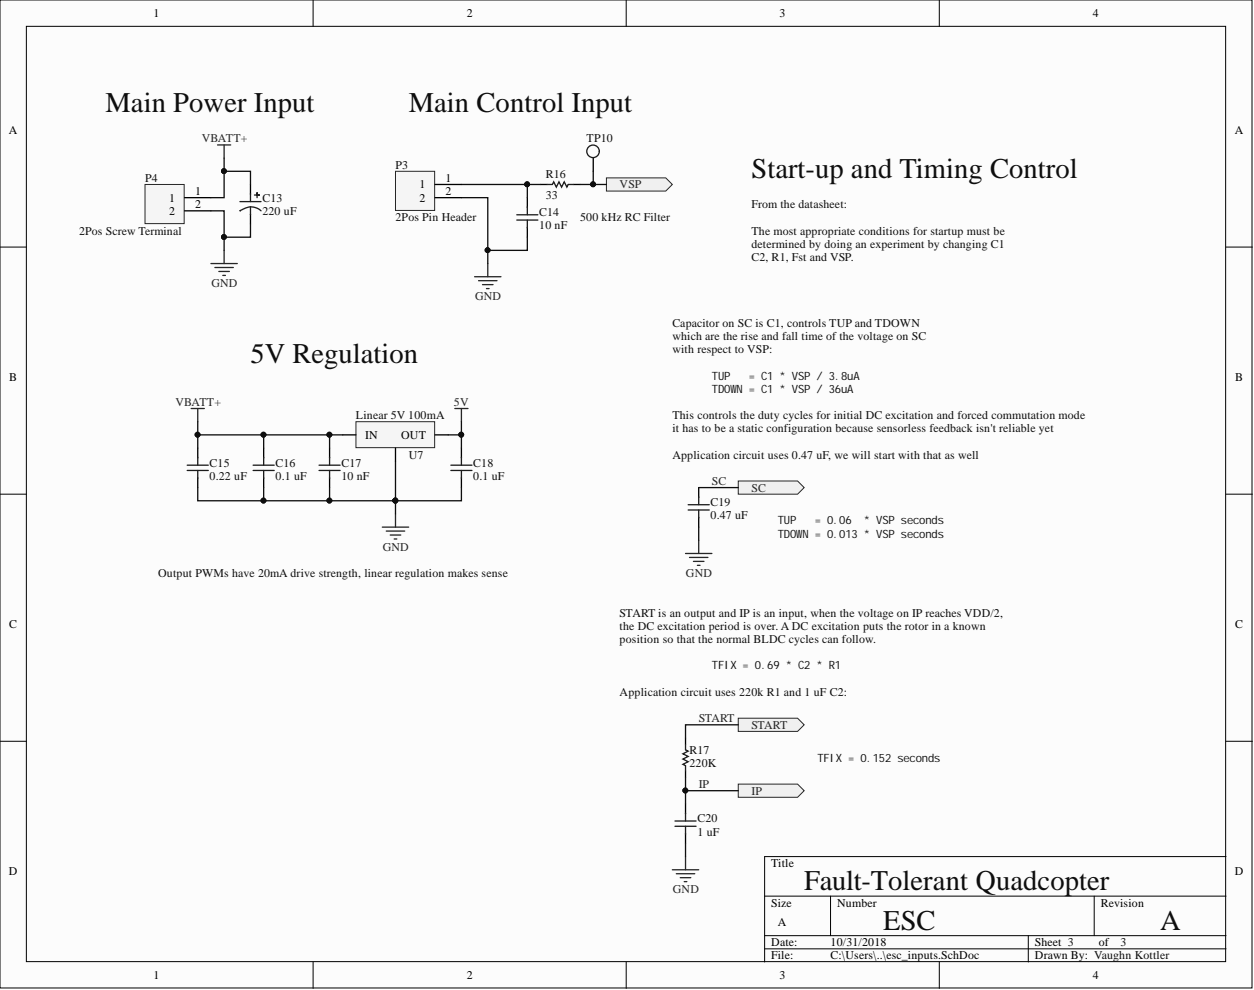
[picture p63: page 2]

Start-up and Timing Control

The most appropriate conditions for startup must be
determined by doing an experiment by changing C1
C2, R1, Fst and VSP.

Capacitor on SC is C1, controls TUP and TDOWN
which are the rise and fall time of the voltage on SC
with respect to VSP:

This controls the duty cycles for initial DC excitation and forced commutation mode
it has to be a static configuration because sensorless feedback isn't reliable yet

Application circuit uses 0.47 uF, we will start with that as well

Output PWMs have 20mA drive strength, linear regulation makes sense

START is an output and IP is an input, when the voltage on IP reaches VDD/2,
the DC excitation period is over. A DC excitation puts the rotor in a known
position so that the normal BLDC cycles can follow.

Application circuit uses 220k R1 and 1 uF C2:

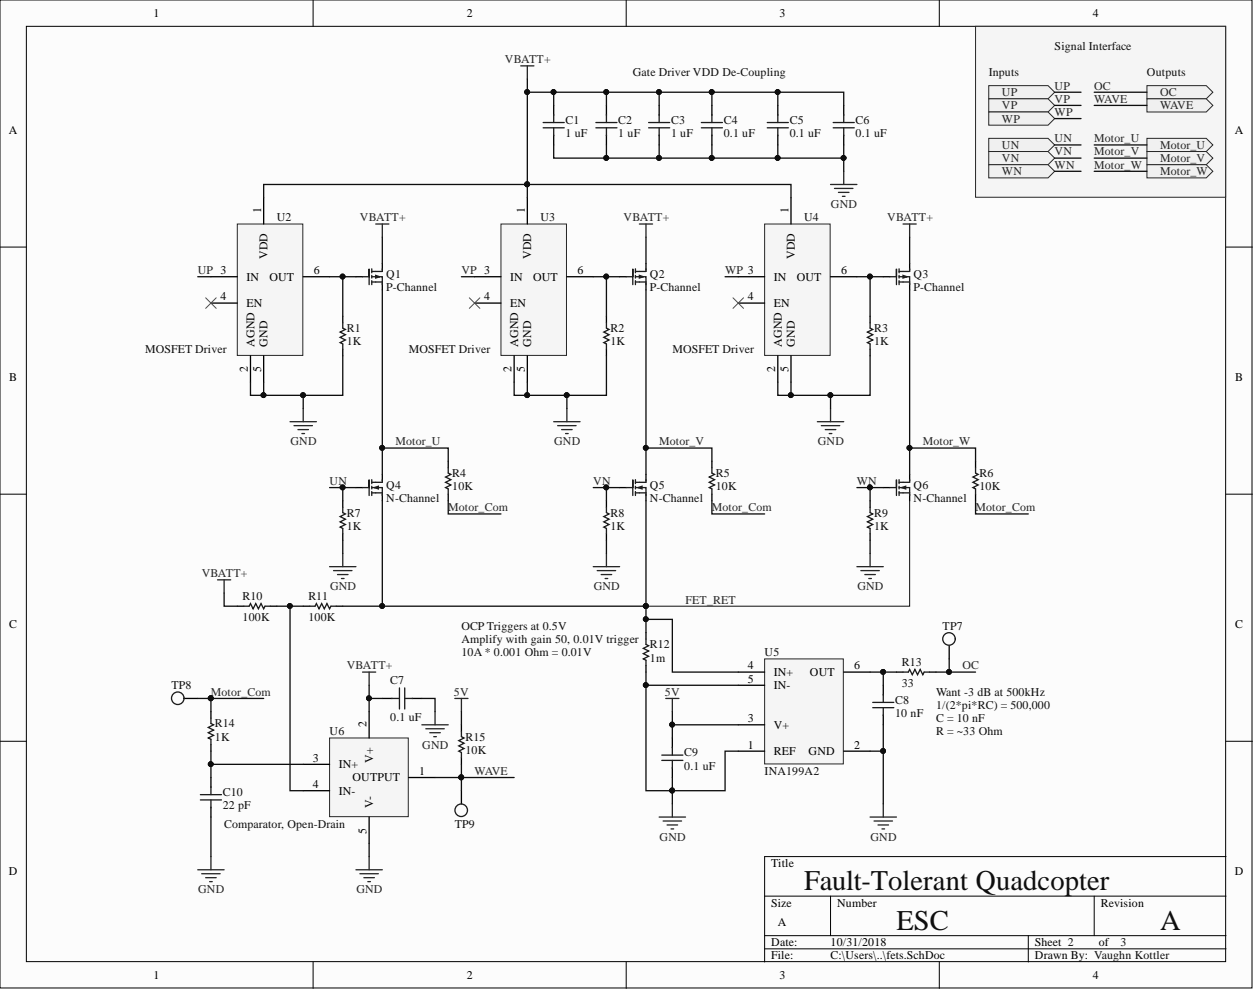
[picture p64: page 3]

Gate Driver VDD De-Coupling

OCP Triggers at 0.5V
Amplify with gain 50, 0.01V trigger
10A * 0.001 Ohm = 0.01V
