vkottler/senior-design/cad/pcb/altium/outputs/flight_controller/flight_controller_sheets.PDF

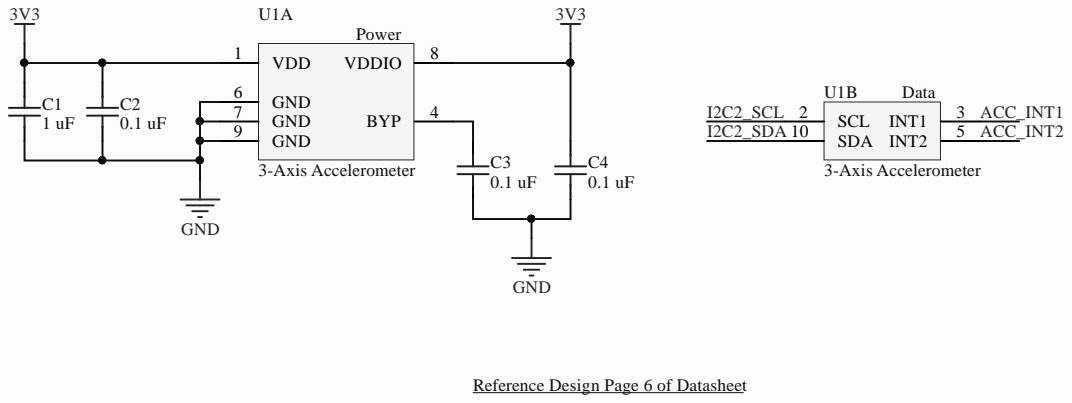
[picture p65: page 1]

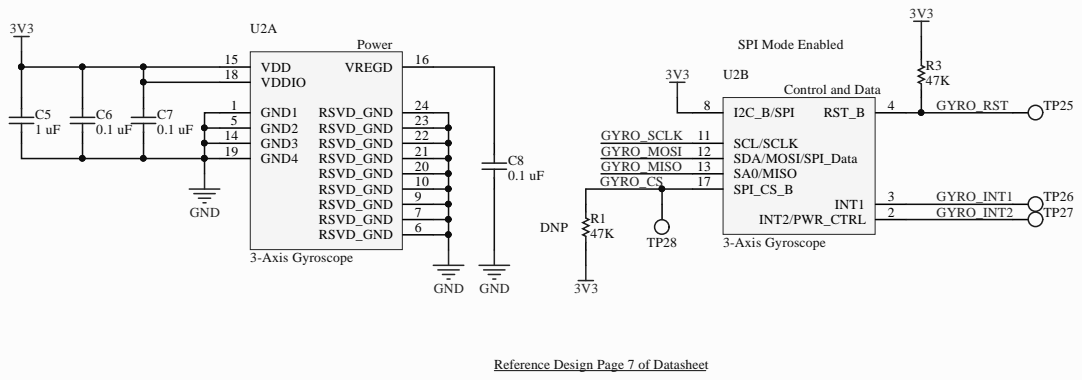
[picture p66: page 2]

5 | | 21 RSVD_GND 22 RSVD_GND 23 RSVD_GND 24 0 RSVD_GND

1 4
1 9

6 RSVD_GND 7 RSVD_GND 9 RSVD_GND 1

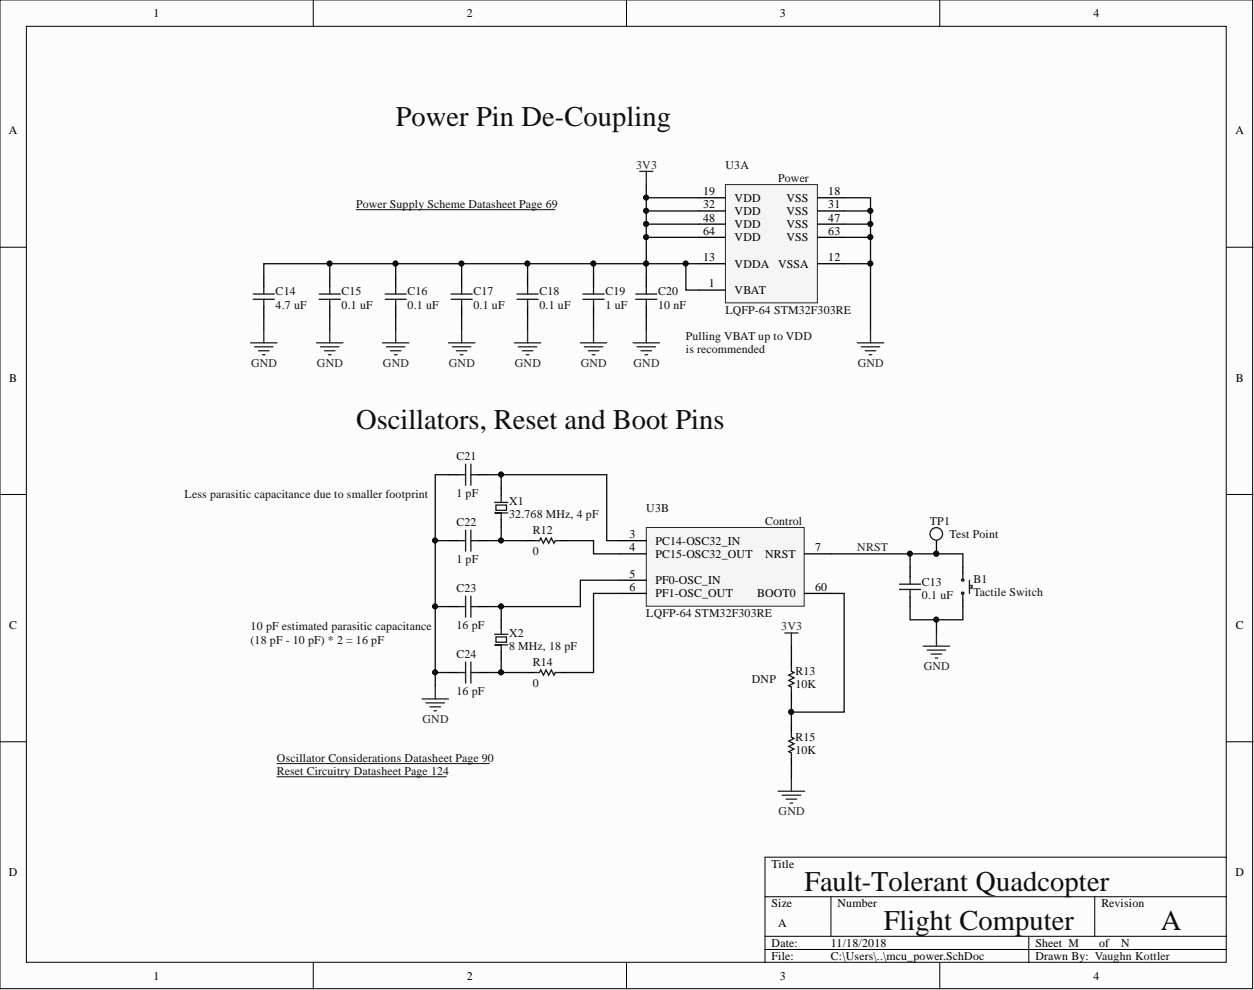
[picture p67: page 3]

Power Pin De-Coupling

Power Supply Scheme Datasheet Page 69 (https://www.st.com/content/ccc/resource/technical/document/datasheet/2c/6f/d7/64/1f/a3/4f/c9/DM00118585.pdf/files/DM00118585.pdf/jcr:content/translations/en.D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)

Pulling VBAT up to VDD
is recommended

Oscillators, Reset and Boot Pins

Less parasitic capacitance due to smaller footprint

10 pF estimated parasitic capacitance

Oscillator Considerations Datasheet Page 90
Reset Circuitry Datasheet Page 124 (https://www.st.com/content/ccc/resource/technical/document/datasheet/2c/6f/d7/64/1f/a3/4f/c9/DM00118585.pdf/files/DM00118585.pdf/jcr:content/translations/en.D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)

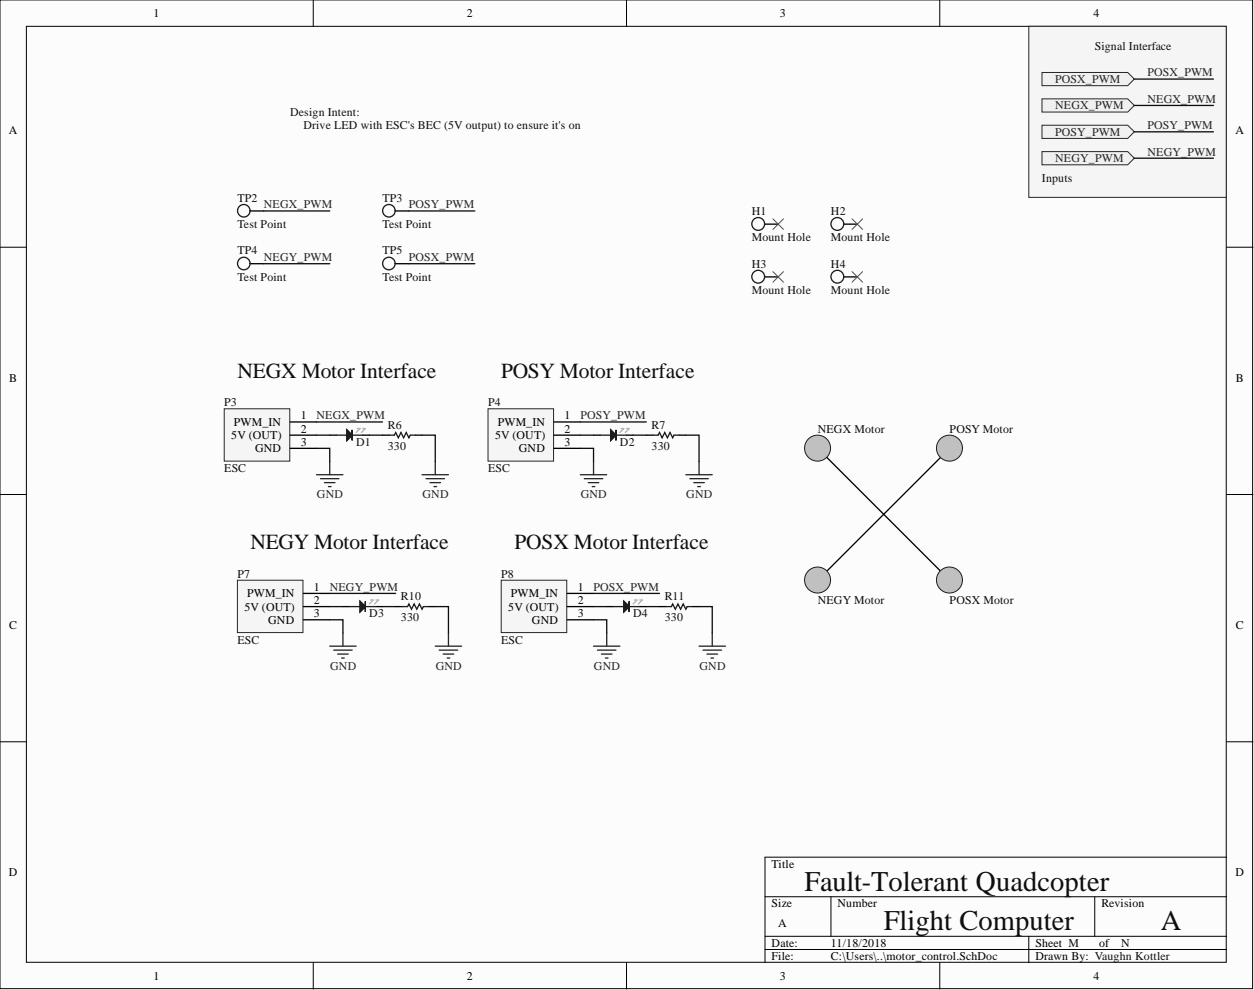
[picture p68: page 4]

Design Intent:
Drive LED with ESC's BEC (5V output) to ensure it's on

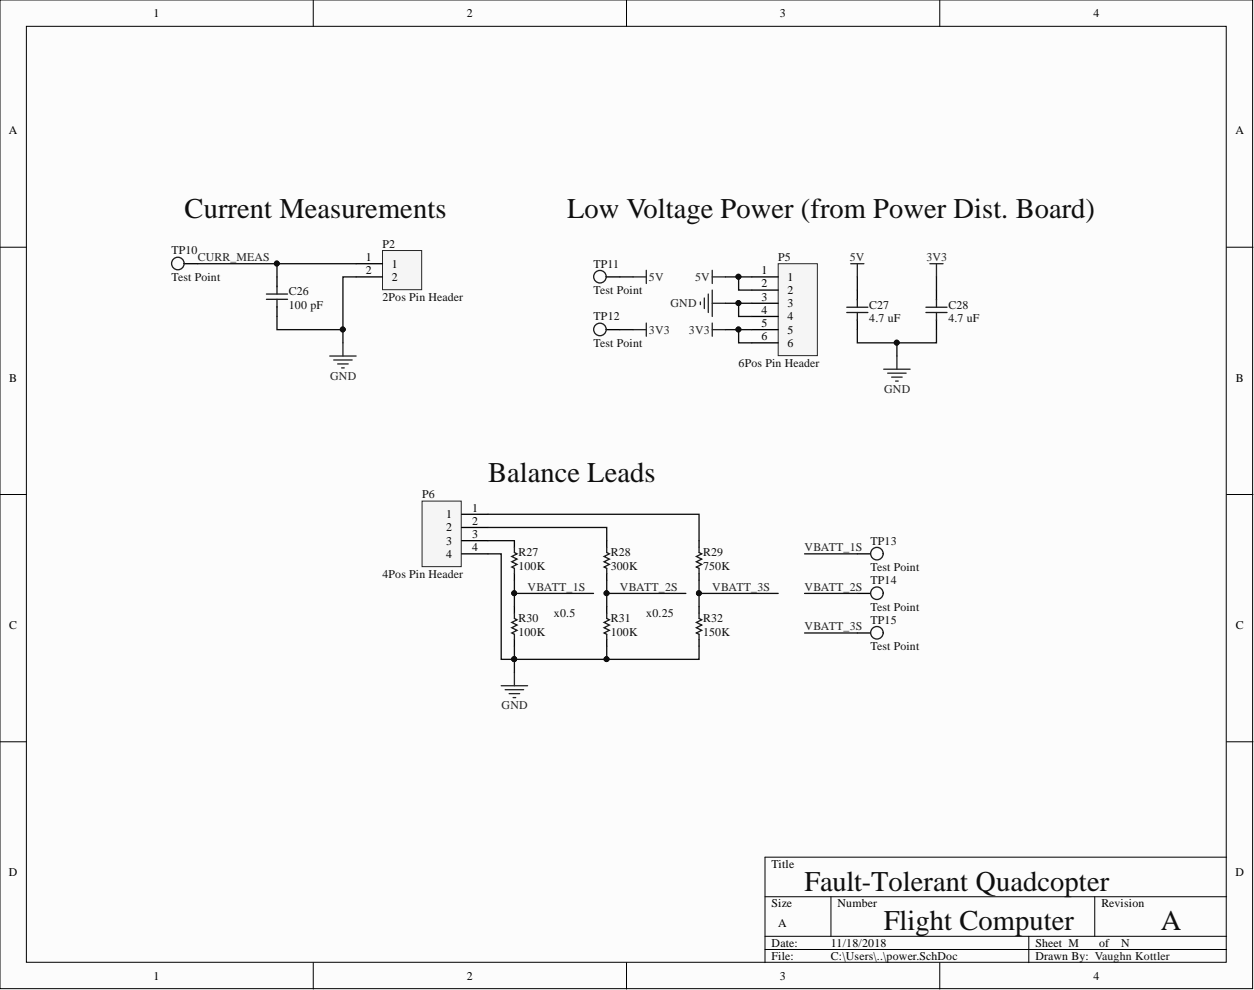
[picture p69: page 5]

Low Voltage Power (from Power Dist. Board)

3 3
4 4
5 5
6 6

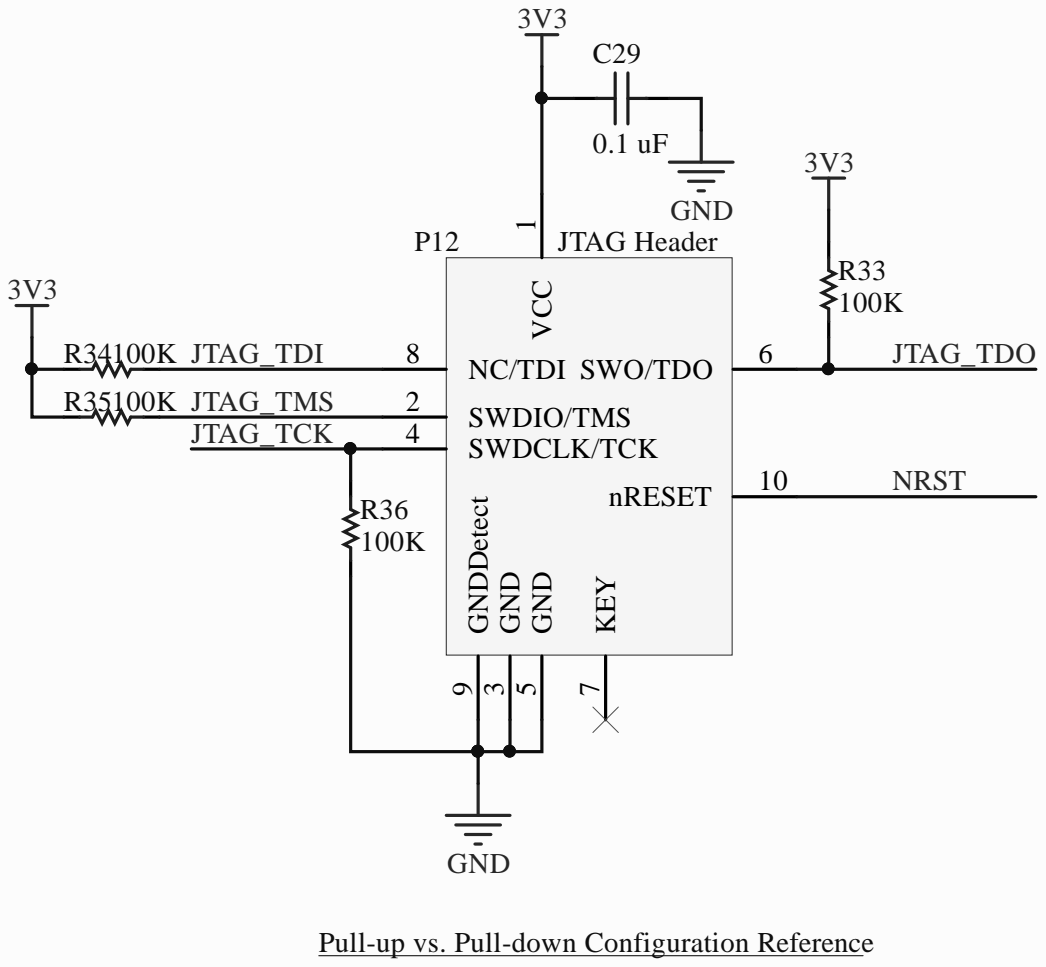
[picture p70: page 6]

Pull-up vs. Pull-down Configuration Reference (http://support.code-red-tech.com/CodeRedWiki/HardwareDebugConnections)

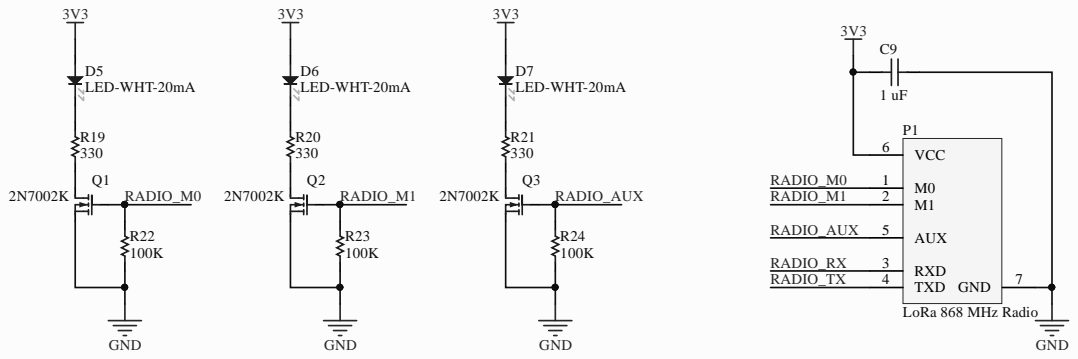
[picture p71: page 7]

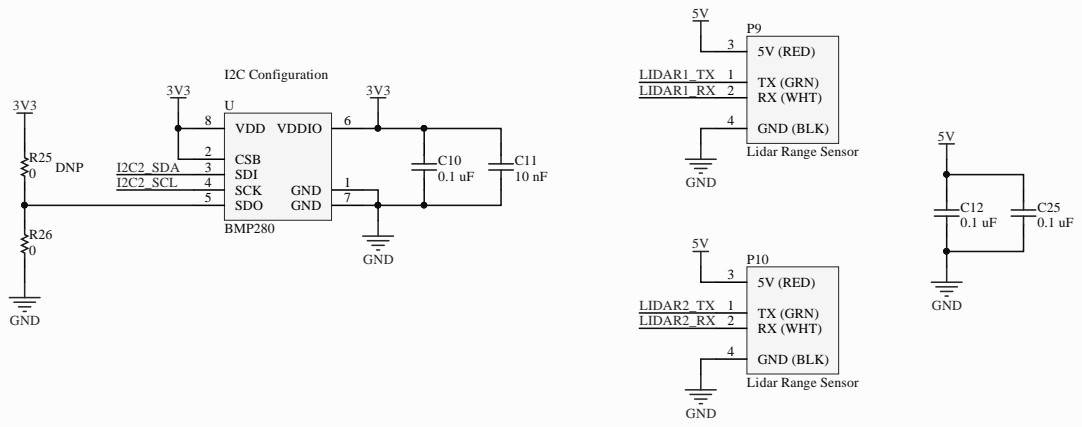
[picture p72: page 8]

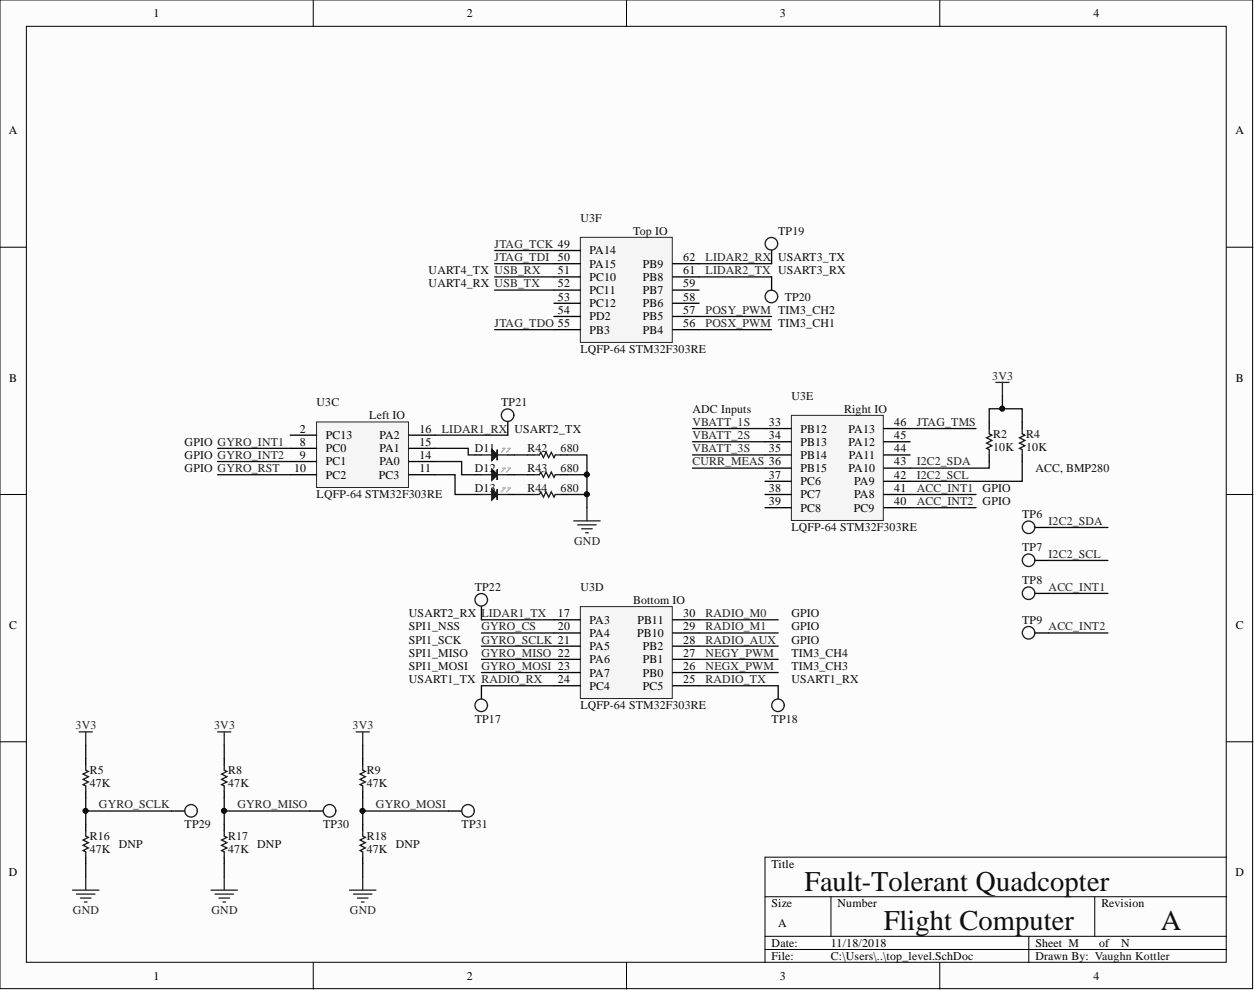
[picture p73: page 9]

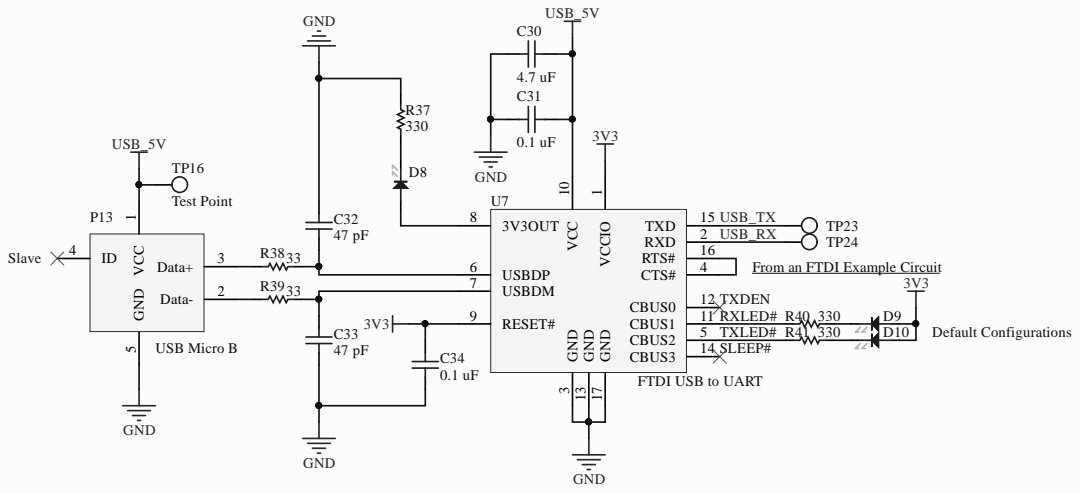
[picture p74: page 10]

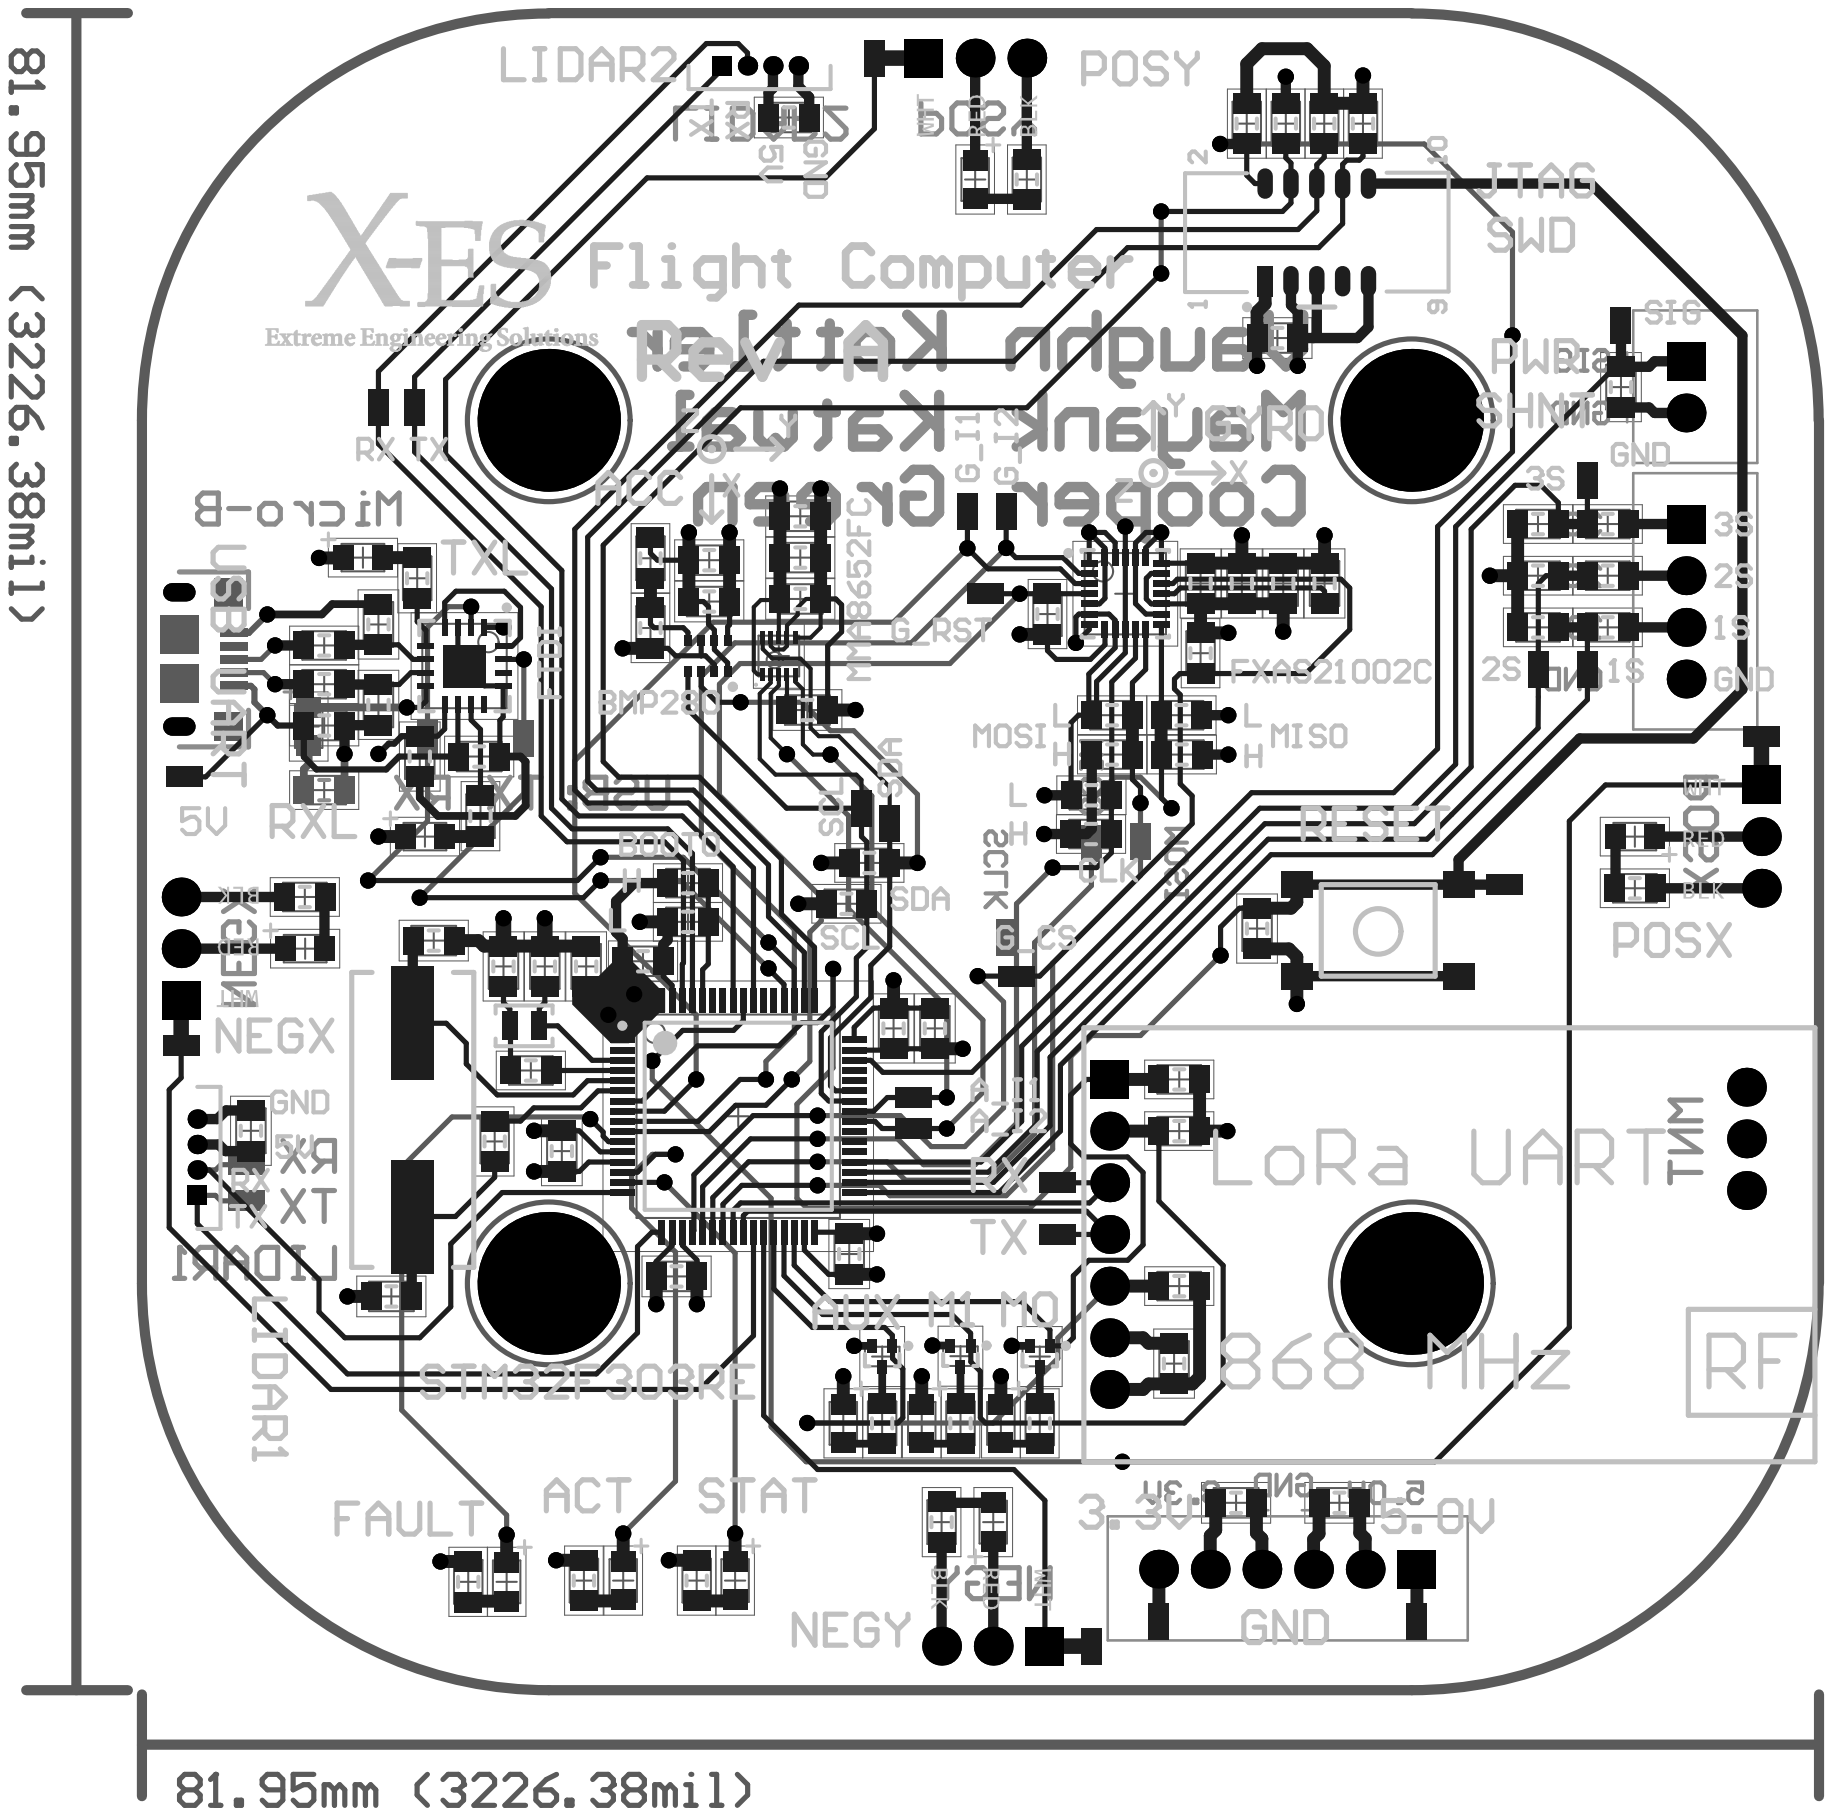
[picture p75: page 11]
