vkottler/senior-design/cad/pcb/altium/outputs/power/power_distribution.pdf

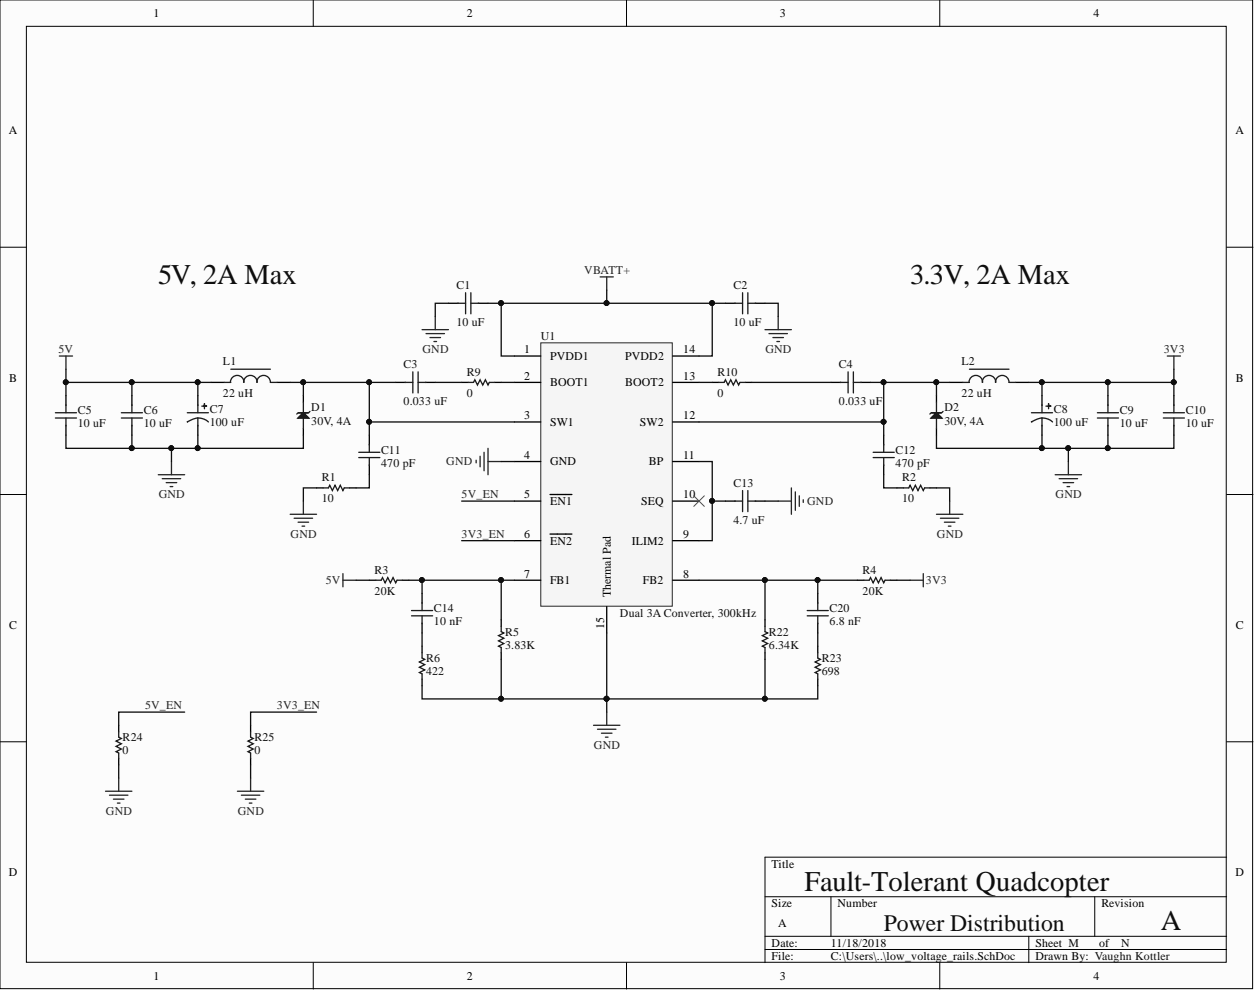
[picture p76: page 1]

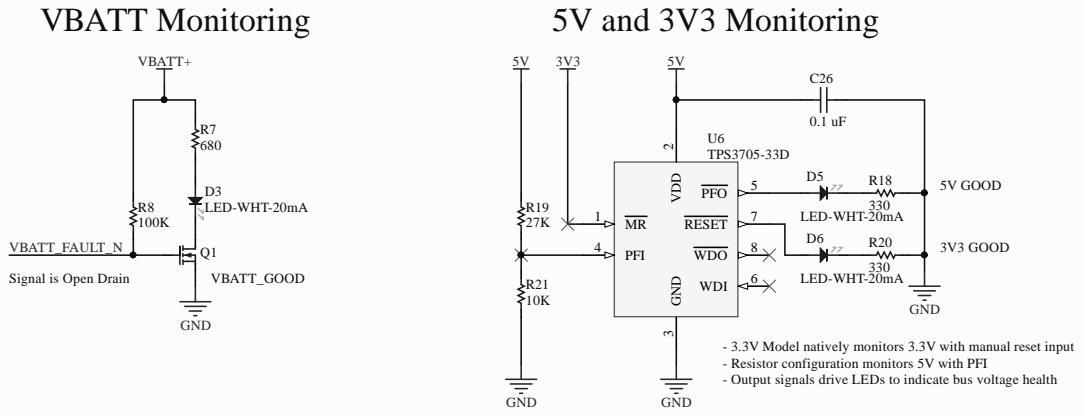
[picture p77: page 2]

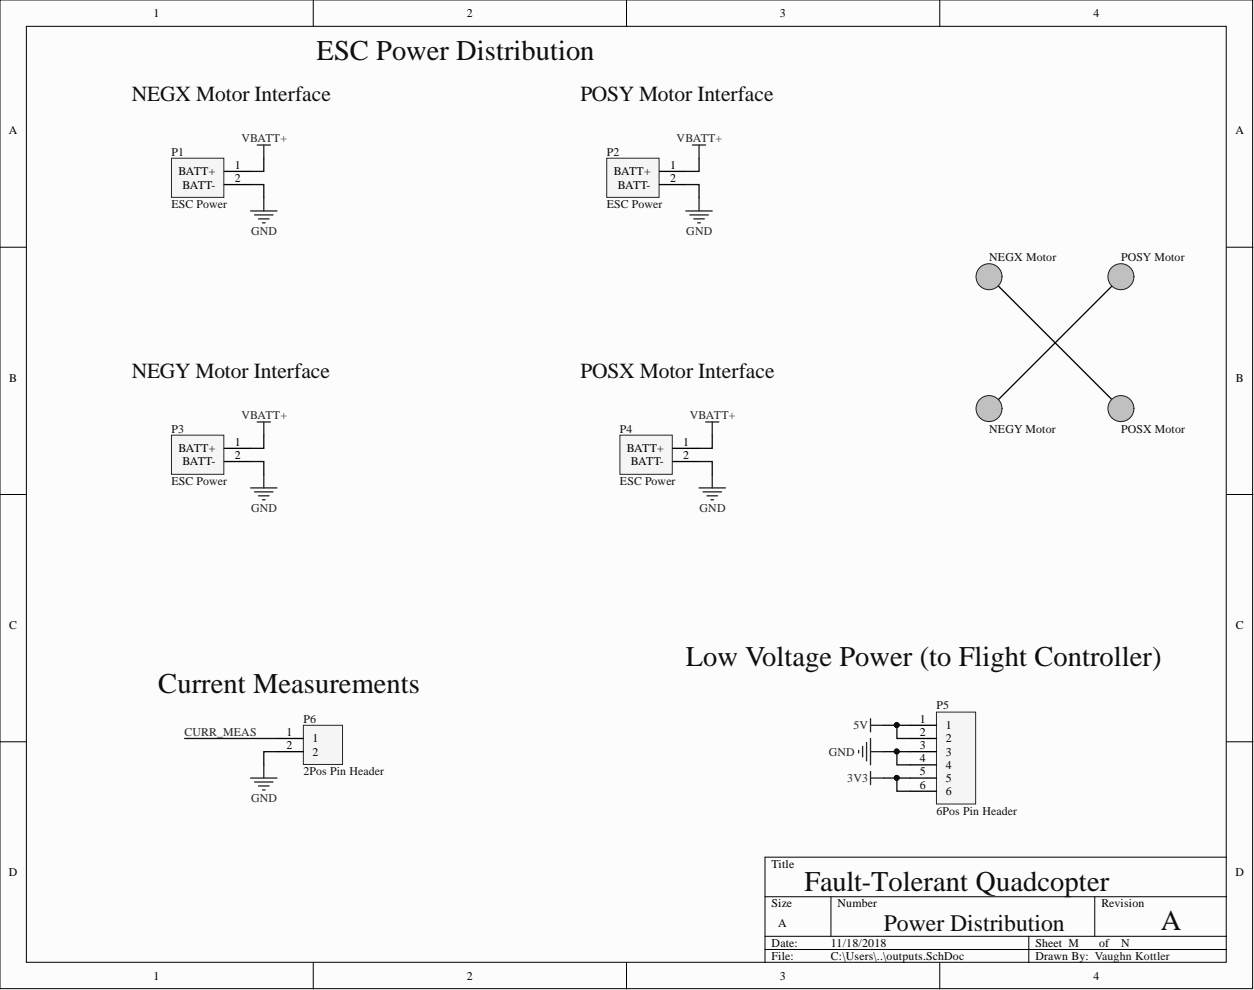
[picture p78: page 3]

Low Voltage Power (to Flight Controller)

4 4
5 5
6 6

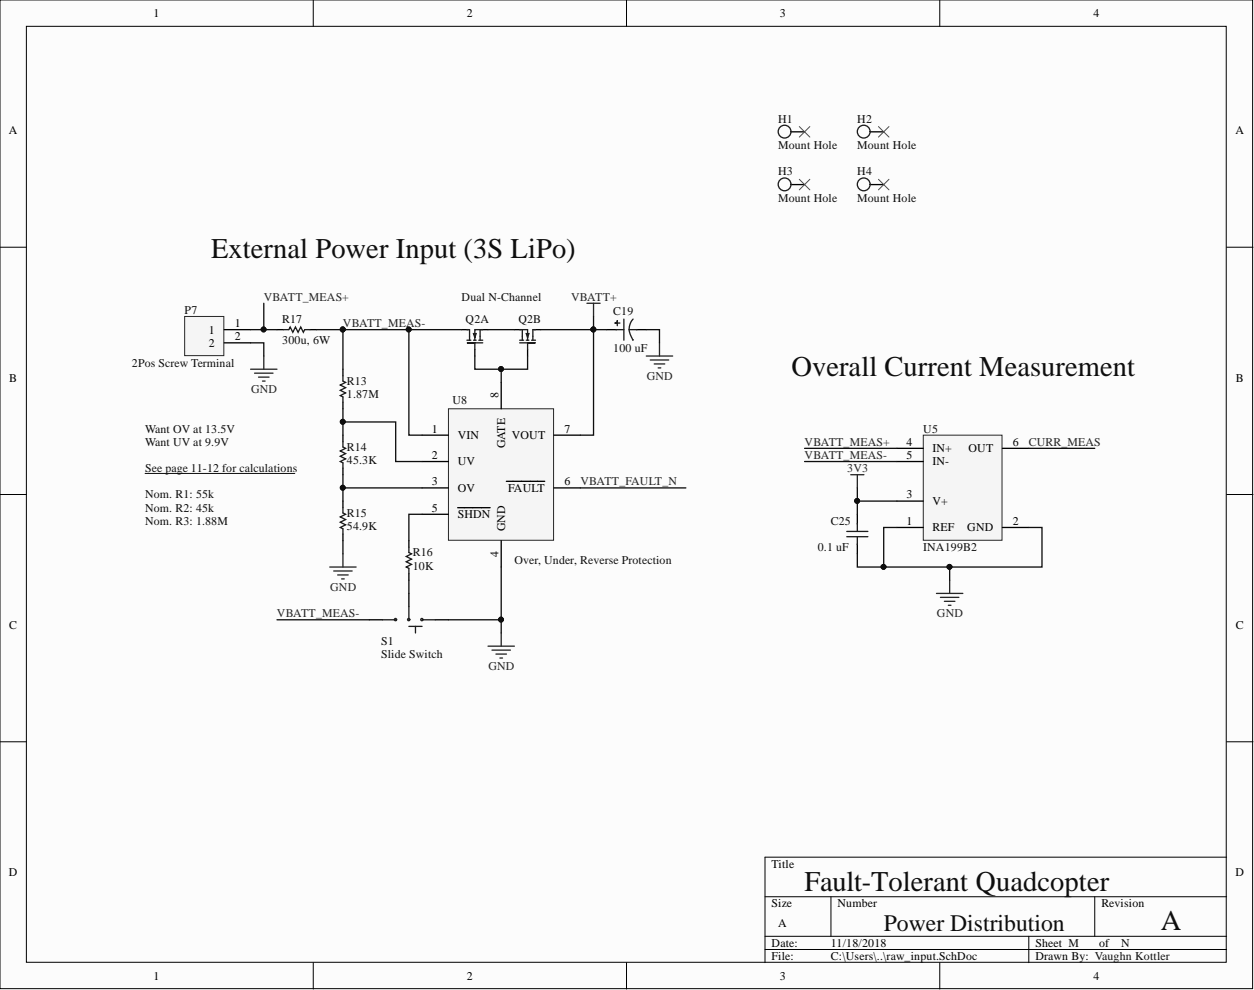
[picture p79: page 4]

External Power Input (3S LiPo)

See page 11-12 for calculations (https://www.analog.com/media/en/technical-documentation/data-sheets/4365fa.pdf)

Over, Under, Reverse Protection
