vkottler/senior-design/(list of files, drawings)

Other design files:
cad/pcb/altium/flight/accelerometer.SchDoc
cad/pcb/altium/flight/blank_template.SchDoc
cad/pcb/altium/flight/esc.PcbDoc
cad/pcb/altium/flight/esc.PrjPCB
cad/pcb/altium/flight/esc.SchDoc
cad/pcb/altium/flight/esc_inputs.SchDoc
cad/pcb/altium/flight/esc_outputs.SchDoc
cad/pcb/altium/flight/fets.SchDoc
cad/pcb/altium/flight/flight-controller.PrjPCB
cad/pcb/altium/flight/flight-power.PrjPCB
cad/pcb/altium/flight/gyro.SchDoc
cad/pcb/altium/flight/mcu_power.SchDoc
cad/pcb/altium/flight/motor_control.SchDoc
cad/pcb/altium/flight/power.SchDoc
cad/pcb/altium/flight/programming.SchDoc
cad/pcb/altium/flight/radio.SchDoc
cad/pcb/altium/flight/sensors.SchDoc
cad/pcb/altium/flight/top_level.SchDoc
cad/pcb/altium/flight/usb_serial.SchDoc
cad/pcb/altium/ground/de1_soc_connector.SchLib
cad/pcb/altium/ground/mezzanine-card.PrjPCB
cad/pcb/altium/ground/mezzanine_card.SchDoc
cad/pcb/altium/power/low_voltage_rails.SchDoc
cad/pcb/altium/power/monitoring.SchDoc
cad/pcb/altium/power/outputs.SchDoc
cad/pcb/altium/power/power_dist.PcbDoc
cad/pcb/altium/power/power_dist.PrjPCB
cad/pcb/altium/power/raw_input.SchDoc
cad/pcb/altium/reference_designs/MB1136C_schematic_layout/Connectors.SchDoc
cad/pcb/altium/reference_designs/MB1136C_schematic_layout/MB1136.PcbDoc
cad/pcb/altium/reference_designs/MB1136C_schematic_layout/MB1136.PrjPCB
cad/pcb/altium/reference_designs/MB1136C_schematic_layout/MB1136.SchDoc
cad/pcb/altium/reference_designs/MB1136C_schematic_layout/MB1136.SCHLIB
cad/pcb/altium/reference_designs/MB1136C_schematic_layout/MCU_64.SchDoc
cad/pcb/altium/reference_designs/MB1136C_schematic_layout/ST_LINK_V2-1.SCHDOC
coursework/lab_1/Lab1_PWR/01 Revision History and Contents.SchDoc
coursework/lab_1/Lab1_PWR/02 Mobile Power.SchDoc
coursework/lab_1/Lab1_PWR/ECE453-PWR.PrjPcb
coursework/lab_1/Lab1_PWR/ECE453-PWR.SCHLIB
coursework/lab_1/Lab1_PWR/ECE453_PWR.PcbDoc
coursework/lab_1/Lab1_PWR/ECE453_PWR.PcbLib
coursework/lab_1/Lab1_PWR/ECE453_PWR.SchLib
