vkottler/senior-design/src/include/adc.h

/**
  ******************************************************************************
  * @file    stm32f3xx_ll_adc.h
  * @author  MCD Application Team
  * @brief   Header file of ADC LL module.
  ******************************************************************************
  * @attention
  *
  * <h2><center>&copy; COPYRIGHT(c) 2016 STMicroelectronics</center></h2>
  *
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
  ******************************************************************************
  */

/* Define to prevent recursive inclusion -------------------------------------*/
#ifndef __STM32F3xx_LL_ADC_H
#define __STM32F3xx_LL_ADC_H

/* Includes ------------------------------------------------------------------*/
#include "stm32f3xx.h"

/** @addtogroup STM32F3xx_LL_Driver
  * @{
  */

/* Note: Devices of STM32F3 serie embed 1 out of 2 different ADC IP.          */
/*       - STM32F30x, STM32F31x, STM32F32x, STM32F33x, STM32F35x, STM32F39x:  */
/*         ADC IP 5Msamples/sec, from 1 to 4 ADC instances and other specific */
/*         features (refer to reference manual).                              */
/*       - STM32F37x:                                                         */
/*         ADC IP 1Msamples/sec, 1 ADC instance                               */
/*       This file contains the drivers of these ADC IP, located in 2 area    */
/*       delimited by compilation switches.                                   */

/* Internal mask for ADC group regular sequencer:                             */
/* To select into literal LL_ADC_REG_RANK_x the relevant bits for:            */
/* - sequencer register offset                                                */
/* - sequencer rank bits position into the selected register                  */

/* Internal register offset for ADC group regular sequencer configuration */
/* (offset placed into a spare area of literal definition) */
#define ADC_SQR1_REGOFFSET                 ((uint32_t)0x00000000U)
#define ADC_SQR2_REGOFFSET                 ((uint32_t)0x00000100U)
#define ADC_SQR3_REGOFFSET                 ((uint32_t)0x00000200U)
#define ADC_SQR4_REGOFFSET                 ((uint32_t)0x00000300U)

#define ADC_REG_SQRX_REGOFFSET_MASK        (ADC_SQR1_REGOFFSET | ADC_SQR2_REGOFFSET | ADC_SQR3_REGOFFSET | ADC_SQR4_REGOFFSET)
#define ADC_REG_RANK_ID_SQRX_MASK          (ADC_CHANNEL_ID_NUMBER_MASK_POSBIT0)

/* Definition of ADC group regular sequencer bits information to be inserted  */
/* into ADC group regular sequencer ranks literals definition.                */
#define ADC_REG_RANK_1_SQRX_BITOFFSET_POS  ((uint32_t) 6U) /* Value equivalent to POSITION_VAL(ADC_SQR1_SQ1) */
#define ADC_REG_RANK_2_SQRX_BITOFFSET_POS  ((uint32_t)12U) /* Value equivalent to POSITION_VAL(ADC_SQR1_SQ2) */
#define ADC_REG_RANK_3_SQRX_BITOFFSET_POS  ((uint32_t)18U) /* Value equivalent to POSITION_VAL(ADC_SQR1_SQ3) */
#define ADC_REG_RANK_4_SQRX_BITOFFSET_POS  ((uint32_t)24U) /* Value equivalent to POSITION_VAL(ADC_SQR1_SQ4) */
#define ADC_REG_RANK_5_SQRX_BITOFFSET_POS  ((uint32_t) 0U) /* Value equivalent to POSITION_VAL(ADC_SQR2_SQ5) */
#define ADC_REG_RANK_6_SQRX_BITOFFSET_POS  ((uint32_t) 6U) /* Value equivalent to POSITION_VAL(ADC_SQR2_SQ6) */
#define ADC_REG_RANK_7_SQRX_BITOFFSET_POS  ((uint32_t)12U) /* Value equivalent to POSITION_VAL(ADC_SQR2_SQ7) */
#define ADC_REG_RANK_8_SQRX_BITOFFSET_POS  ((uint32_t)18U) /* Value equivalent to POSITION_VAL(ADC_SQR2_SQ8) */
#define ADC_REG_RANK_9_SQRX_BITOFFSET_POS  ((uint32_t)24U) /* Value equivalent to POSITION_VAL(ADC_SQR2_SQ9) */
#define ADC_REG_RANK_10_SQRX_BITOFFSET_POS ((uint32_t) 0U) /* Value equivalent to POSITION_VAL(ADC_SQR3_SQ10) */
#define ADC_REG_RANK_11_SQRX_BITOFFSET_POS ((uint32_t) 6U) /* Value equivalent to POSITION_VAL(ADC_SQR3_SQ11) */
#define ADC_REG_RANK_12_SQRX_BITOFFSET_POS ((uint32_t)12U) /* Value equivalent to POSITION_VAL(ADC_SQR3_SQ12) */
#define ADC_REG_RANK_13_SQRX_BITOFFSET_POS ((uint32_t)18U) /* Value equivalent to POSITION_VAL(ADC_SQR3_SQ13) */
#define ADC_REG_RANK_14_SQRX_BITOFFSET_POS ((uint32_t)24U) /* Value equivalent to POSITION_VAL(ADC_SQR3_SQ14) */
#define ADC_REG_RANK_15_SQRX_BITOFFSET_POS ((uint32_t) 0U) /* Value equivalent to POSITION_VAL(ADC_SQR4_SQ15) */
#define ADC_REG_RANK_16_SQRX_BITOFFSET_POS ((uint32_t) 6U) /* Value equivalent to POSITION_VAL(ADC_SQR4_SQ16) */



/* Internal mask for ADC group injected sequencer:                            */
/* To select into literal LL_ADC_INJ_RANK_x the relevant bits for:            */
/* - data register offset                                                     */
/* - sequencer rank bits position into the selected register                  */

/* Internal register offset for ADC group injected data register */
/* (offset placed into a spare area of literal definition) */
#define ADC_JDR1_REGOFFSET                 ((uint32_t)0x00000000U)
#define ADC_JDR2_REGOFFSET                 ((uint32_t)0x00000100U)
#define ADC_JDR3_REGOFFSET                 ((uint32_t)0x00000200U)
#define ADC_JDR4_REGOFFSET                 ((uint32_t)0x00000300U)

#define ADC_INJ_JDRX_REGOFFSET_MASK        (ADC_JDR1_REGOFFSET | ADC_JDR2_REGOFFSET | ADC_JDR3_REGOFFSET | ADC_JDR4_REGOFFSET)
#define ADC_INJ_RANK_ID_JSQR_MASK          (ADC_CHANNEL_ID_NUMBER_MASK_POSBIT0)

/* Definition of ADC group injected sequencer bits information to be inserted */
/* into ADC group injected sequencer ranks literals definition.               */
#define ADC_INJ_RANK_1_JSQR_BITOFFSET_POS  ((uint32_t) 8U) /* Value equivalent to POSITION_VAL(ADC_JSQR_JSQ1) */
#define ADC_INJ_RANK_2_JSQR_BITOFFSET_POS  ((uint32_t)14U) /* Value equivalent to POSITION_VAL(ADC_JSQR_JSQ2) */
#define ADC_INJ_RANK_3_JSQR_BITOFFSET_POS  ((uint32_t)20U) /* Value equivalent to POSITION_VAL(ADC_JSQR_JSQ3) */
#define ADC_INJ_RANK_4_JSQR_BITOFFSET_POS  ((uint32_t)26U) /* Value equivalent to POSITION_VAL(ADC_JSQR_JSQ4) */



/* Internal mask for ADC group regular trigger:                               */
/* To select into literal LL_ADC_REG_TRIG_x the relevant bits for:            */
/* - regular trigger source                                                   */
/* - regular trigger edge                                                     */
#define ADC_REG_TRIG_EXT_EDGE_DEFAULT       (ADC_CFGR_EXTEN_0) /* Trigger edge set to rising edge (default setting for compatibility with some ADC on other STM32 families having this setting set by HW default value) */

/* Mask containing trigger source masks for each of possible                  */
/* trigger edge selection duplicated with shifts [0; 4; 8; 12]                */
/* corresponding to {SW start; ext trigger; ext trigger; ext trigger}.        */
#define ADC_REG_TRIG_SOURCE_MASK            (((LL_ADC_REG_TRIG_SOFTWARE & ADC_CFGR_EXTSEL) << (4U * 0U)) | \
                                             ((ADC_CFGR_EXTSEL)                            << (4U * 1U)) | \
                                             ((ADC_CFGR_EXTSEL)                            << (4U * 2U)) | \
                                             ((ADC_CFGR_EXTSEL)                            << (4U * 3U))  )

/* Mask containing trigger edge masks for each of possible                    */
/* trigger edge selection duplicated with shifts [0; 4; 8; 12]                */
/* corresponding to {SW start; ext trigger; ext trigger; ext trigger}.        */
#define ADC_REG_TRIG_EDGE_MASK              (((LL_ADC_REG_TRIG_SOFTWARE & ADC_CFGR_EXTEN) << (4U * 0U)) | \
                                             ((ADC_REG_TRIG_EXT_EDGE_DEFAULT)             << (4U * 1U)) | \
                                             ((ADC_REG_TRIG_EXT_EDGE_DEFAULT)             << (4U * 2U)) | \
                                             ((ADC_REG_TRIG_EXT_EDGE_DEFAULT)             << (4U * 3U))  )

/* Definition of ADC group regular trigger bits information.                  */
#define ADC_REG_TRIG_EXTSEL_BITOFFSET_POS  ((uint32_t) 6U) /* Value equivalent to POSITION_VAL(ADC_CFGR_EXTSEL) */
#define ADC_REG_TRIG_EXTEN_BITOFFSET_POS   ((uint32_t)10U) /* Value equivalent to POSITION_VAL(ADC_CFGR_EXTEN) */



/* Internal definitions for ADC group regular trigger sources:                */
/* To differentiate into literal LL_ADC_REG_TRIG_x the trigger sources        */
/* depending on ADC instances ADC1, ADC2, ADC3, ADC4 (if ADC instance is      */
/* available on the selected device).                                         */

#if defined(STM32F303xC) || defined(STM32F358xx) || defined(STM32F303xE) || defined(STM32F398xx)
/* Internal mask offset for ADC group injected trigger sources                */
/* available only on specific ADC instances.                                  */
/* (offset placed into a spare area of literal definition) */
#define ADC_REG_TRIG_EXT_INST_ADC12        ((uint32_t)0x00000001U) /* Marker for differentiation of ADC group regular external trigger available only on ADC instance: ADC1, ADC2 */
#define ADC_REG_TRIG_EXT_INST_ADC34        ((uint32_t)0x00000002U) /* Marker for differentiation of ADC group regular external trigger available only on ADC instance: ADC3, ADC4 */
#endif

/* Internal mask for ADC group injected trigger:                              */
/* To select into literal LL_ADC_INJ_TRIG_x the relevant bits for:            */
/* - injected trigger source                                                  */
/* - injected trigger edge                                                    */
#define ADC_INJ_TRIG_EXT_EDGE_DEFAULT      (ADC_JSQR_JEXTEN_0) /* Trigger edge set to rising edge (default setting for compatibility with some ADC on other STM32 families having this setting set by HW default value) */

/* Mask containing trigger source masks for each of possible                  */
/* trigger edge selection duplicated with shifts [0; 4; 8; 12]                */
/* corresponding to {SW start; ext trigger; ext trigger; ext trigger}.        */
#define ADC_INJ_TRIG_SOURCE_MASK            (((LL_ADC_INJ_TRIG_SOFTWARE & ADC_JSQR_JEXTSEL) << (4U * 0U)) | \
                                            ((ADC_JSQR_JEXTSEL)                             << (4U * 1U)) | \
                                            ((ADC_JSQR_JEXTSEL)                             << (4U * 2U)) | \
                                            ((ADC_JSQR_JEXTSEL)                             << (4U * 3U))  )

/* Mask containing trigger edge masks for each of possible                    */
/* trigger edge selection duplicated with shifts [0; 4; 8; 12]                */
/* corresponding to {SW start; ext trigger; ext trigger; ext trigger}.        */
#define ADC_INJ_TRIG_EDGE_MASK              (((LL_ADC_INJ_TRIG_SOFTWARE & ADC_JSQR_JEXTEN) << (4U * 0U)) | \
                                             ((ADC_INJ_TRIG_EXT_EDGE_DEFAULT)              << (4U * 1U)) | \
                                             ((ADC_INJ_TRIG_EXT_EDGE_DEFAULT)              << (4U * 2U)) | \
                                             ((ADC_INJ_TRIG_EXT_EDGE_DEFAULT)              << (4U * 3U))  )

/* Definition of ADC group injected trigger bits information.                 */
#define ADC_INJ_TRIG_EXTSEL_BITOFFSET_POS  ((uint32_t) 2U) /* Value equivalent to POSITION_VAL(ADC_JSQR_JEXTSEL) */
#define ADC_INJ_TRIG_EXTEN_BITOFFSET_POS   ((uint32_t) 6U) /* Value equivalent to POSITION_VAL(ADC_JSQR_JEXTEN) */



/* Internal definitions for ADC group injected trigger sources:               */
/* To differentiate into literal LL_ADC_INJ_TRIG_x the trigger sources        */
/* depending on ADC instances ADC1, ADC2, ADC3, ADC4 (if ADC instance is      */
/* available on the selected device).                                         */

#if defined(STM32F303xC) || defined(STM32F358xx) || defined(STM32F303xE) || defined(STM32F398xx)
/* Internal mask offset for ADC group injected trigger sources                */
/* available only on specific ADC instances.                                  */
/* (offset placed into a spare area of literal definition) */
#define ADC_INJ_TRIG_EXT_INST_ADC12        ((uint32_t)0x00000001U) /* Marker for differentiation of ADC group injected external trigger available only on ADC instance: ADC1, ADC2 */
#define ADC_INJ_TRIG_EXT_INST_ADC34        ((uint32_t)0x00000002U) /* Marker for differentiation of ADC group injected external trigger available only on ADC instance: ADC3, ADC4 */
#endif




/* Internal mask for ADC channel:                                             */
/* To select into literal LL_ADC_CHANNEL_x the relevant bits for:             */
/* - channel identifier defined by number                                     */
/* - channel identifier defined by bitfield                                   */
/* - channel differentiation between external channels (connected to          */
/*   GPIO pins) and internal channels (connected to internal paths)           */
/* - channel sampling time defined by SMPRx register offset                   */
/*   and SMPx bits positions into SMPRx register                              */
#define ADC_CHANNEL_ID_NUMBER_MASK         (ADC_CFGR_AWD1CH)
#define ADC_CHANNEL_ID_BITFIELD_MASK       (ADC_AWD2CR_AWD2CH)
#define ADC_CHANNEL_ID_NUMBER_BITOFFSET_POS ((uint32_t)26U)/* Value equivalent to POSITION_VAL(ADC_CHANNEL_ID_NUMBER_MASK) */
#define ADC_CHANNEL_ID_MASK                (ADC_CHANNEL_ID_NUMBER_MASK | ADC_CHANNEL_ID_BITFIELD_MASK | ADC_CHANNEL_ID_INTERNAL_CH_MASK)
/* Equivalent mask of ADC_CHANNEL_NUMBER_MASK aligned on register LSB (bit 0) */
#define ADC_CHANNEL_ID_NUMBER_MASK_POSBIT0 (ADC_SQR2_SQ5) /* Equivalent to shift: (ADC_CHANNEL_NUMBER_MASK >> POSITION_VAL(ADC_CHANNEL_NUMBER_MASK)) */

/* Channel differentiation between external and internal channels */
#define ADC_CHANNEL_ID_INTERNAL_CH         ((uint32_t)0x80000000U) /* Marker of internal channel */
#define ADC_CHANNEL_ID_INTERNAL_CH_2       ((uint32_t)0x00080000U) /* Marker of internal channel for other ADC instances, in case of different ADC internal channels mapped on same channel number on different ADC instances */
#define ADC_CHANNEL_ID_INTERNAL_CH_MASK    (ADC_CHANNEL_ID_INTERNAL_CH | ADC_CHANNEL_ID_INTERNAL_CH_2)

/* Internal register offset for ADC channel sampling time configuration */
/* (offset placed into a spare area of literal definition) */
#define ADC_SMPR1_REGOFFSET                ((uint32_t)0x00000000U)
#define ADC_SMPR2_REGOFFSET                ((uint32_t)0x02000000U)
#define ADC_CHANNEL_SMPRX_REGOFFSET_MASK   (ADC_SMPR1_REGOFFSET | ADC_SMPR2_REGOFFSET)

#define ADC_CHANNEL_SMPx_BITOFFSET_MASK    ((uint32_t)0x01F00000U)
#define ADC_CHANNEL_SMPx_BITOFFSET_POS     ((uint32_t)20U)           /* Value equivalent to POSITION_VAL(ADC_CHANNEL_SMPx_BITOFFSET_MASK) */

/* Definition of channels ID number information to be inserted into           */
/* channels literals definition.                                              */
#define ADC_CHANNEL_0_NUMBER               ((uint32_t)0x00000000U)
#define ADC_CHANNEL_1_NUMBER               (                                                                                ADC_CFGR_AWD1CH_0)
#define ADC_CHANNEL_2_NUMBER               (                                                            ADC_CFGR_AWD1CH_1                    )
#define ADC_CHANNEL_3_NUMBER               (                                                            ADC_CFGR_AWD1CH_1 | ADC_CFGR_AWD1CH_0)
#define ADC_CHANNEL_4_NUMBER               (                                        ADC_CFGR_AWD1CH_2                                        )
#define ADC_CHANNEL_5_NUMBER               (                                        ADC_CFGR_AWD1CH_2                     | ADC_CFGR_AWD1CH_0)
#define ADC_CHANNEL_6_NUMBER               (                                        ADC_CFGR_AWD1CH_2 | ADC_CFGR_AWD1CH_1                    )
#define ADC_CHANNEL_7_NUMBER               (                                        ADC_CFGR_AWD1CH_2 | ADC_CFGR_AWD1CH_1 | ADC_CFGR_AWD1CH_0)
#define ADC_CHANNEL_8_NUMBER               (                    ADC_CFGR_AWD1CH_3                                                            )
#define ADC_CHANNEL_9_NUMBER               (                    ADC_CFGR_AWD1CH_3                                         | ADC_CFGR_AWD1CH_0)
#define ADC_CHANNEL_10_NUMBER              (                    ADC_CFGR_AWD1CH_3                     | ADC_CFGR_AWD1CH_1                    )
#define ADC_CHANNEL_11_NUMBER              (                    ADC_CFGR_AWD1CH_3                     | ADC_CFGR_AWD1CH_1 | ADC_CFGR_AWD1CH_0)
#define ADC_CHANNEL_12_NUMBER              (                    ADC_CFGR_AWD1CH_3 | ADC_CFGR_AWD1CH_2                                        )
#define ADC_CHANNEL_13_NUMBER              (                    ADC_CFGR_AWD1CH_3 | ADC_CFGR_AWD1CH_2                     | ADC_CFGR_AWD1CH_0)
#define ADC_CHANNEL_14_NUMBER              (                    ADC_CFGR_AWD1CH_3 | ADC_CFGR_AWD1CH_2 | ADC_CFGR_AWD1CH_1                    )
#define ADC_CHANNEL_15_NUMBER              (                    ADC_CFGR_AWD1CH_3 | ADC_CFGR_AWD1CH_2 | ADC_CFGR_AWD1CH_1 | ADC_CFGR_AWD1CH_0)
#define ADC_CHANNEL_16_NUMBER              (ADC_CFGR_AWD1CH_4                                                                                )
#define ADC_CHANNEL_17_NUMBER              (ADC_CFGR_AWD1CH_4                                                             | ADC_CFGR_AWD1CH_0)
#define ADC_CHANNEL_18_NUMBER              (ADC_CFGR_AWD1CH_4                                         | ADC_CFGR_AWD1CH_1                    )

/* Definition of channels ID bitfield information to be inserted into         */
/* channels literals definition.                                              */
#define ADC_CHANNEL_0_BITFIELD             (ADC_AWD2CR_AWD2CH_0)
#define ADC_CHANNEL_1_BITFIELD             (ADC_AWD2CR_AWD2CH_1)
#define ADC_CHANNEL_2_BITFIELD             (ADC_AWD2CR_AWD2CH_2)
#define ADC_CHANNEL_3_BITFIELD             (ADC_AWD2CR_AWD2CH_3)
#define ADC_CHANNEL_4_BITFIELD             (ADC_AWD2CR_AWD2CH_4)
#define ADC_CHANNEL_5_BITFIELD             (ADC_AWD2CR_AWD2CH_5)
#define ADC_CHANNEL_6_BITFIELD             (ADC_AWD2CR_AWD2CH_6)
#define ADC_CHANNEL_7_BITFIELD             (ADC_AWD2CR_AWD2CH_7)
#define ADC_CHANNEL_8_BITFIELD             (ADC_AWD2CR_AWD2CH_8)
#define ADC_CHANNEL_9_BITFIELD             (ADC_AWD2CR_AWD2CH_9)
#define ADC_CHANNEL_10_BITFIELD            (ADC_AWD2CR_AWD2CH_10)
#define ADC_CHANNEL_11_BITFIELD            (ADC_AWD2CR_AWD2CH_11)
#define ADC_CHANNEL_12_BITFIELD            (ADC_AWD2CR_AWD2CH_12)
#define ADC_CHANNEL_13_BITFIELD            (ADC_AWD2CR_AWD2CH_13)
#define ADC_CHANNEL_14_BITFIELD            (ADC_AWD2CR_AWD2CH_14)
#define ADC_CHANNEL_15_BITFIELD            (ADC_AWD2CR_AWD2CH_15)
#define ADC_CHANNEL_16_BITFIELD            (ADC_AWD2CR_AWD2CH_16)
#define ADC_CHANNEL_17_BITFIELD            (ADC_AWD2CR_AWD2CH_17)
#define ADC_CHANNEL_18_BITFIELD            (ADC_AWD2CR_AWD2CH_18)

/* Definition of channels sampling time information to be inserted into       */
/* channels literals definition.                                              */
#define ADC_CHANNEL_0_SMP                  (ADC_SMPR1_REGOFFSET | (((uint32_t) 0U) << ADC_CHANNEL_SMPx_BITOFFSET_POS)) /* Value shifted is equivalent to POSITION_VAL(ADC_SMPR1_SMP0) */
#define ADC_CHANNEL_1_SMP                  (ADC_SMPR1_REGOFFSET | (((uint32_t) 3U) << ADC_CHANNEL_SMPx_BITOFFSET_POS)) /* Value shifted is equivalent to POSITION_VAL(ADC_SMPR1_SMP1) */
#define ADC_CHANNEL_2_SMP                  (ADC_SMPR1_REGOFFSET | (((uint32_t) 6U) << ADC_CHANNEL_SMPx_BITOFFSET_POS)) /* Value shifted is equivalent to POSITION_VAL(ADC_SMPR1_SMP2) */
#define ADC_CHANNEL_3_SMP                  (ADC_SMPR1_REGOFFSET | (((uint32_t) 9U) << ADC_CHANNEL_SMPx_BITOFFSET_POS)) /* Value shifted is equivalent to POSITION_VAL(ADC_SMPR1_SMP3) */
#define ADC_CHANNEL_4_SMP                  (ADC_SMPR1_REGOFFSET | (((uint32_t)12U) << ADC_CHANNEL_SMPx_BITOFFSET_POS)) /* Value shifted is equivalent to POSITION_VAL(ADC_SMPR1_SMP4) */
#define ADC_CHANNEL_5_SMP                  (ADC_SMPR1_REGOFFSET | (((uint32_t)15U) << ADC_CHANNEL_SMPx_BITOFFSET_POS)) /* Value shifted is equivalent to POSITION_VAL(ADC_SMPR1_SMP5) */
#define ADC_CHANNEL_6_SMP                  (ADC_SMPR1_REGOFFSET | (((uint32_t)18U) << ADC_CHANNEL_SMPx_BITOFFSET_POS)) /* Value shifted is equivalent to POSITION_VAL(ADC_SMPR1_SMP6) */
#define ADC_CHANNEL_7_SMP                  (ADC_SMPR1_REGOFFSET | (((uint32_t)21U) << ADC_CHANNEL_SMPx_BITOFFSET_POS)) /* Value shifted is equivalent to POSITION_VAL(ADC_SMPR1_SMP7) */
#define ADC_CHANNEL_8_SMP                  (ADC_SMPR1_REGOFFSET | (((uint32_t)24U) << ADC_CHANNEL_SMPx_BITOFFSET_POS)) /* Value shifted is equivalent to POSITION_VAL(ADC_SMPR1_SMP8) */
#define ADC_CHANNEL_9_SMP                  (ADC_SMPR1_REGOFFSET | (((uint32_t)27U) << ADC_CHANNEL_SMPx_BITOFFSET_POS)) /* Value shifted is equivalent to POSITION_VAL(ADC_SMPR1_SMP9) */
#define ADC_CHANNEL_10_SMP                 (ADC_SMPR2_REGOFFSET | (((uint32_t) 0U) << ADC_CHANNEL_SMPx_BITOFFSET_POS)) /* Value shifted is equivalent to POSITION_VAL(ADC_SMPR2_SMP10) */
#define ADC_CHANNEL_11_SMP                 (ADC_SMPR2_REGOFFSET | (((uint32_t) 3U) << ADC_CHANNEL_SMPx_BITOFFSET_POS)) /* Value shifted is equivalent to POSITION_VAL(ADC_SMPR2_SMP11) */
#define ADC_CHANNEL_12_SMP                 (ADC_SMPR2_REGOFFSET | (((uint32_t) 6U) << ADC_CHANNEL_SMPx_BITOFFSET_POS)) /* Value shifted is equivalent to POSITION_VAL(ADC_SMPR2_SMP12) */
#define ADC_CHANNEL_13_SMP                 (ADC_SMPR2_REGOFFSET | (((uint32_t) 9U) << ADC_CHANNEL_SMPx_BITOFFSET_POS)) /* Value shifted is equivalent to POSITION_VAL(ADC_SMPR2_SMP13) */
#define ADC_CHANNEL_14_SMP                 (ADC_SMPR2_REGOFFSET | (((uint32_t)12U) << ADC_CHANNEL_SMPx_BITOFFSET_POS)) /* Value shifted is equivalent to POSITION_VAL(ADC_SMPR2_SMP14) */
#define ADC_CHANNEL_15_SMP                 (ADC_SMPR2_REGOFFSET | (((uint32_t)15U) << ADC_CHANNEL_SMPx_BITOFFSET_POS)) /* Value shifted is equivalent to POSITION_VAL(ADC_SMPR2_SMP15) */
#define ADC_CHANNEL_16_SMP                 (ADC_SMPR2_REGOFFSET | (((uint32_t)18U) << ADC_CHANNEL_SMPx_BITOFFSET_POS)) /* Value shifted is equivalent to POSITION_VAL(ADC_SMPR2_SMP16) */
#define ADC_CHANNEL_17_SMP                 (ADC_SMPR2_REGOFFSET | (((uint32_t)21U) << ADC_CHANNEL_SMPx_BITOFFSET_POS)) /* Value shifted is equivalent to POSITION_VAL(ADC_SMPR2_SMP17) */
#define ADC_CHANNEL_18_SMP                 (ADC_SMPR2_REGOFFSET | (((uint32_t)24U) << ADC_CHANNEL_SMPx_BITOFFSET_POS)) /* Value shifted is equivalent to POSITION_VAL(ADC_SMPR2_SMP18) */


/* Internal mask for ADC mode single or differential ended:                   */
/* To select into literals LL_ADC_SINGLE_ENDED or LL_ADC_SINGLE_DIFFERENTIAL  */
/* the relevant bits for:                                                     */
/* (concatenation of multiple bits used in different registers)               */
/* - ADC calibration: calibration start, calibration factor get or set        */
/* - ADC channels: set each ADC channel ending mode                           */
#define ADC_SINGLEDIFF_CALIB_START_MASK    (ADC_CR_ADCALDIF)
#define ADC_SINGLEDIFF_CALIB_FACTOR_MASK   (ADC_CALFACT_CALFACT_D | ADC_CALFACT_CALFACT_S)
#define ADC_SINGLEDIFF_CHANNEL_MASK        (ADC_CHANNEL_ID_BITFIELD_MASK) /* Equivalent to ADC_DIFSEL_DIFSEL */
#define ADC_SINGLEDIFF_CHANNEL_SHIFT_MASK  (ADC_CALFACT_CALFACT_S_5) /* Bit chosen to perform of shift when single mode is selected, shift value out of channels bits range. */


/* Internal mask for ADC analog watchdog:                                     */
/* To select into literals LL_ADC_AWD_CHANNELx_xxx the relevant bits for:     */
/* (concatenation of multiple bits used in different analog watchdogs,        */
/* (feature of several watchdogs not available on all STM32 families)).       */
/* - analog watchdog 1: monitored channel defined by number,                  */
/*   selection of ADC group (ADC groups regular and-or injected).             */
/* - analog watchdog 2 and 3: monitored channel defined by bitfield, no       */
/*   selection on groups.                                                     */

/* Internal register offset for ADC analog watchdog channel configuration */
#define ADC_AWD_CR1_REGOFFSET              ((uint32_t)0x00000000U)
#define ADC_AWD_CR2_REGOFFSET              ((uint32_t)0x00100000U)
#define ADC_AWD_CR3_REGOFFSET              ((uint32_t)0x00200000U)

/* Register offset gap between AWD1 and AWD2-AWD3 configuration registers */
/* (Set separately as ADC_AWD_CRX_REGOFFSET to spare 32 bits space */
#define ADC_AWD_CR12_REGOFFSETGAP_MASK     (ADC_AWD2CR_AWD2CH_0)
#define ADC_AWD_CR12_REGOFFSETGAP_VAL      ((uint32_t)0x00000024U)

#define ADC_AWD_CRX_REGOFFSET_MASK         (ADC_AWD_CR1_REGOFFSET | ADC_AWD_CR2_REGOFFSET | ADC_AWD_CR3_REGOFFSET)

#define ADC_AWD_CR1_CHANNEL_MASK           (ADC_CFGR_AWD1CH | ADC_CFGR_JAWD1EN | ADC_CFGR_AWD1EN | ADC_CFGR_AWD1SGL)
#define ADC_AWD_CR23_CHANNEL_MASK          (ADC_AWD2CR_AWD2CH)
#define ADC_AWD_CR_ALL_CHANNEL_MASK        (ADC_AWD_CR1_CHANNEL_MASK | ADC_AWD_CR23_CHANNEL_MASK)

/* Internal register offset for ADC analog watchdog threshold configuration */
#define ADC_AWD_TR1_REGOFFSET              (ADC_AWD_CR1_REGOFFSET)
#define ADC_AWD_TR2_REGOFFSET              (ADC_AWD_CR2_REGOFFSET)
#define ADC_AWD_TR3_REGOFFSET              (ADC_AWD_CR3_REGOFFSET)
#define ADC_AWD_TRX_REGOFFSET_MASK         (ADC_AWD_TR1_REGOFFSET | ADC_AWD_TR2_REGOFFSET | ADC_AWD_TR3_REGOFFSET)


/* Internal mask for ADC offset:                                              */
/* Internal register offset for ADC offset number configuration */
#define ADC_OFR1_REGOFFSET                 ((uint32_t)0x00000000U)
#define ADC_OFR2_REGOFFSET                 ((uint32_t)0x00000001U)
#define ADC_OFR3_REGOFFSET                 ((uint32_t)0x00000002U)
#define ADC_OFR4_REGOFFSET                 ((uint32_t)0x00000003U)
#define ADC_OFRx_REGOFFSET_MASK            (ADC_OFR1_REGOFFSET | ADC_OFR2_REGOFFSET | ADC_OFR3_REGOFFSET | ADC_OFR4_REGOFFSET)


/* ADC registers bits positions */
#define ADC_CFGR_RES_BITOFFSET_POS         ((uint32_t) 3U) /* Value equivalent to POSITION_VAL(ADC_CFGR_RES) */
#define ADC_CFGR_AWD1SGL_BITOFFSET_POS     ((uint32_t)22U) /* Value equivalent to POSITION_VAL(ADC_CFGR_AWD1SGL) */
#define ADC_CFGR_AWD1EN_BITOFFSET_POS      ((uint32_t)23U) /* Value equivalent to POSITION_VAL(ADC_CFGR_AWD1EN) */
#define ADC_CFGR_JAWD1EN_BITOFFSET_POS     ((uint32_t)24U) /* Value equivalent to POSITION_VAL(ADC_CFGR_JAWD1EN) */
#define ADC_TR1_HT1_BITOFFSET_POS          ((uint32_t)16U) /* Value equivalent to POSITION_VAL(ADC_TR1_HT1) */


/* ADC registers bits groups */
#define ADC_CR_BITS_PROPERTY_RS            (ADC_CR_ADCAL | ADC_CR_JADSTP | ADC_CR_ADSTP | ADC_CR_JADSTART | ADC_CR_ADSTART | ADC_CR_ADDIS | ADC_CR_ADEN) /* ADC register CR bits with HW property "rs": Software can read as well as set this bit. Writing '0' has no effect on the bit value. */


/* ADC internal channels related definitions */
/* Internal voltage reference VrefInt */
#define VREFINT_CAL_ADDR                   ((uint16_t*) ((uint32_t)0x1FFFF7BAU)) /* Internal voltage reference, address of parameter VREFINT_CAL: VrefInt ADC raw data acquired at temperature 30 DegC (tolerance: +-5 DegC), Vref+ = 3.3 V (tolerance: +-10 mV). */
#define VREFINT_CAL_VREF                   ((uint32_t) 3300U)                    /* Analog voltage reference (Vref+) value with which temperature sensor has been calibrated in production (tolerance: +-10 mV) (unit: mV). */
/* Temperature sensor */
#define TEMPSENSOR_CAL1_ADDR               ((uint16_t*) ((uint32_t)0x1FFFF7B8U)) /* Internal temperature sensor, address of parameter TS_CAL1: On STM32F3, temperature sensor ADC raw data acquired at temperature  25 DegC (tolerance: +-5 DegC), Vref+ = 3.3 V (tolerance: +-10 mV). */
#define TEMPSENSOR_CAL2_ADDR               ((uint16_t*) ((uint32_t)0x1FFFF7C2U)) /* Internal temperature sensor, address of parameter TS_CAL2: On STM32F3, temperature sensor ADC raw data acquired at temperature 110 DegC (tolerance: +-5 DegC), Vref+ = 3.3 V (tolerance: +-10 mV). */
#define TEMPSENSOR_CAL1_TEMP               (( int32_t)   25)                     /* Internal temperature sensor, temperature at which temperature sensor has been calibrated in production for data into TEMPSENSOR_CAL1_ADDR (tolerance: +-5 DegC) (unit: DegC). */
#define TEMPSENSOR_CAL2_TEMP               (( int32_t)  110)                     /* Internal temperature sensor, temperature at which temperature sensor has been calibrated in production for data into TEMPSENSOR_CAL2_ADDR (tolerance: +-5 DegC) (unit: DegC). */
#define TEMPSENSOR_CAL_VREFANALOG          ((uint32_t) 3300U)                    /* Analog voltage reference (Vref+) voltage with which temperature sensor has been calibrated in production (+-10 mV) (unit: mV). */


/**
  * @}
  */


/* Private macros ------------------------------------------------------------*/
/** @defgroup ADC_LL_Private_Macros ADC Private Macros
  * @{
  */

/**
  * @brief  Driver macro reserved for internal use: isolate bits with the
  *         selected mask and shift them to the register LSB
  *         (shift mask on register position bit 0).
  * @param  __BITS__ Bits in register 32 bits
  * @param  __MASK__ Mask in register 32 bits
  * @retval Bits in register 32 bits
  */
#define __ADC_MASK_SHIFT(__BITS__, __MASK__)                                   \
  (((__BITS__) & (__MASK__)) >> POSITION_VAL((__MASK__)))

/**
  * @brief  Driver macro reserved for internal use: set a pointer to
  *         a register from a register basis from which an offset
  *         is applied.
  * @param  __REG__ Register basis from which the offset is applied.
  * @param  __REG_OFFFSET__ Offset to be applied (unit: number of registers).
  * @retval Pointer to register address
  */
#define __ADC_PTR_REG_OFFSET(__REG__, __REG_OFFFSET__)                         \
 ((__IO uint32_t *)((uint32_t) ((uint32_t)(&(__REG__)) + ((__REG_OFFFSET__) << 2U))))

/**
  * @}
  */


/* Exported types ------------------------------------------------------------*/
/** @defgroup ADC_LL_ES_INIT ADC Exported Init structure
  * @{
  */

/**
  * @brief  Structure definition of some features of ADC common parameters
  *         and multimode
  *         (all ADC instances belonging to the same ADC common instance).
  * @note   The setting of these parameters by function @ref LL_ADC_CommonInit()
  *         is conditioned to ADC instances state (all ADC instances
  *         sharing the same ADC common instance):
  *         All ADC instances sharing the same ADC common instance must be
  *         disabled.
  */
typedef struct
{
  uint32_t CommonClock;                 /*!< Set parameter common to several ADC: Clock source and prescaler.
                                             This parameter can be a value of @ref ADC_LL_EC_COMMON_CLOCK_SOURCE
                                             @note On this STM32 serie, if ADC group injected is used, some
                                                   clock ratio constraints between ADC clock and AHB clock
                                                   must be respected. Refer to reference manual.
                                             
                                             This feature can be modified afterwards using unitary function @ref LL_ADC_SetCommonClock(). */

#if defined(ADC_MULTIMODE_SUPPORT)
  uint32_t Multimode;                   /*!< Set ADC multimode configuration to operate in independent mode or multimode (for devices with several ADC instances).
                                             This parameter can be a value of @ref ADC_LL_EC_MULTI_MODE
                                             
                                             This feature can be modified afterwards using unitary function @ref LL_ADC_SetMultimode(). */

  uint32_t MultiDMATransfer;            /*!< Set ADC multimode conversion data transfer: no transfer or transfer by DMA.
                                             This parameter can be a value of @ref ADC_LL_EC_MULTI_DMA_TRANSFER
                                             
                                             This feature can be modified afterwards using unitary function @ref LL_ADC_SetMultiDMATransfer(). */

  uint32_t MultiTwoSamplingDelay;       /*!< Set ADC multimode delay between 2 sampling phases.
                                             This parameter can be a value of @ref ADC_LL_EC_MULTI_TWOSMP_DELAY
                                             
                                             This feature can be modified afterwards using unitary function @ref LL_ADC_SetMultiTwoSamplingDelay(). */
#endif /* ADC_MULTIMODE_SUPPORT */

} LL_ADC_CommonInitTypeDef;

/**
  * @brief  Structure definition of some features of ADC instance.
  * @note   These parameters have an impact on ADC scope: ADC instance.
  *         Affects both group regular and group injected (availability
  *         of ADC group injected depends on STM32 families).
  *         Refer to corresponding unitary functions into
  *         @ref ADC_LL_EF_Configuration_ADC_Instance .
  * @note   The setting of these parameters by function @ref LL_ADC_Init()
  *         is conditioned to ADC state:
  *         ADC instance must be disabled.
  *         This condition is applied to all ADC features, for efficiency
  *         and compatibility over all STM32 families. However, the different
  *         features can be set under different ADC state conditions
  *         (setting possible with ADC enabled without conversion on going,
  *         ADC enabled with conversion on going, ...)
  *         Each feature can be updated afterwards with a unitary function
  *         and potentially with ADC in a different state than disabled,
  *         refer to description of each function for setting
  *         conditioned to ADC state.
  */
typedef struct
{
  uint32_t Resolution;                  /*!< Set ADC resolution.
                                             This parameter can be a value of @ref ADC_LL_EC_RESOLUTION
                                             
                                             This feature can be modified afterwards using unitary function @ref LL_ADC_SetResolution(). */

  uint32_t DataAlignment;               /*!< Set ADC conversion data alignment.
                                             This parameter can be a value of @ref ADC_LL_EC_DATA_ALIGN
                                             
                                             This feature can be modified afterwards using unitary function @ref LL_ADC_SetDataAlignment(). */

  uint32_t LowPowerMode;                /*!< Set ADC low power mode.
                                             This parameter can be a value of @ref ADC_LL_EC_LP_MODE
                                             
                                             This feature can be modified afterwards using unitary function @ref LL_ADC_SetLowPowerMode(). */

} LL_ADC_InitTypeDef;

/**
  * @brief  Structure definition of some features of ADC group regular.
  * @note   These parameters have an impact on ADC scope: ADC group regular.
  *         Refer to corresponding unitary functions into
  *         @ref ADC_LL_EF_Configuration_ADC_Group_Regular
  *         (functions with prefix "REG").
  * @note   The setting of these parameters by function @ref LL_ADC_REG_Init()
  *         is conditioned to ADC state:
  *         ADC instance must be disabled.
  *         This condition is applied to all ADC features, for efficiency
  *         and compatibility over all STM32 families. However, the different
  *         features can be set under different ADC state conditions
  *         (setting possible with ADC enabled without conversion on going,
  *         ADC enabled with conversion on going, ...)
  *         Each feature can be updated afterwards with a unitary function
  *         and potentially with ADC in a different state than disabled,
  *         refer to description of each function for setting
  *         conditioned to ADC state.
  */
typedef struct
{
  uint32_t TriggerSource;               /*!< Set ADC group regular conversion trigger source: internal (SW start) or from external IP (timer event, external interrupt line).
                                             This parameter can be a value of @ref ADC_LL_EC_REG_TRIGGER_SOURCE
                                             @note On this STM32 serie, setting trigger source to external trigger also set trigger polarity to rising edge
                                                   (default setting for compatibility with some ADC on other STM32 families having this setting set by HW default value).
                                                   In case of need to modify trigger edge, use function @ref LL_ADC_REG_SetTriggerEdge().
                                             
                                             This feature can be modified afterwards using unitary function @ref LL_ADC_REG_SetTriggerSource(). */

  uint32_t SequencerLength;             /*!< Set ADC group regular sequencer length.
                                             This parameter can be a value of @ref ADC_LL_EC_REG_SEQ_SCAN_LENGTH
                                             
                                             This feature can be modified afterwards using unitary function @ref LL_ADC_REG_SetSequencerLength(). */

  uint32_t SequencerDiscont;            /*!< Set ADC group regular sequencer discontinuous mode: sequence subdivided and scan conversions interrupted every selected number of ranks.
                                             This parameter can be a value of @ref ADC_LL_EC_REG_SEQ_DISCONT_MODE
                                             @note This parameter has an effect only if group regular sequencer is enabled
                                                   (scan length of 2 ranks or more).
                                             
                                             This feature can be modified afterwards using unitary function @ref LL_ADC_REG_SetSequencerDiscont(). */

  uint32_t ContinuousMode;              /*!< Set ADC continuous conversion mode on ADC group regular, whether ADC conversions are performed in single mode (one conversion per trigger) or in continuous mode (after the first trigger, following conversions launched successively automatically).
                                             This parameter can be a value of @ref ADC_LL_EC_REG_CONTINUOUS_MODE
                                             Note: It is not possible to enable both ADC group regular continuous mode and discontinuous mode.
                                             
                                             This feature can be modified afterwards using unitary function @ref LL_ADC_REG_SetContinuousMode(). */

  uint32_t DMATransfer;                 /*!< Set ADC group regular conversion data transfer: no transfer or transfer by DMA, and DMA requests mode.
                                             This parameter can be a value of @ref ADC_LL_EC_REG_DMA_TRANSFER
                                             
                                             This feature can be modified afterwards using unitary function @ref LL_ADC_REG_SetDMATransfer(). */

  uint32_t Overrun;                     /*!< Set ADC group regular behavior in case of overrun:
                                             data preserved or overwritten.
                                             This parameter can be a value of @ref ADC_LL_EC_REG_OVR_DATA_BEHAVIOR
                                             
                                             This feature can be modified afterwards using unitary function @ref LL_ADC_REG_SetOverrun(). */

} LL_ADC_REG_InitTypeDef;

/**
  * @brief  Structure definition of some features of ADC group injected.
  * @note   These parameters have an impact on ADC scope: ADC group injected.
  *         Refer to corresponding unitary functions into
  *         @ref ADC_LL_EF_Configuration_ADC_Group_Regular
  *         (functions with prefix "INJ").
  * @note   The setting of these parameters by function @ref LL_ADC_INJ_Init()
  *         is conditioned to ADC state:
  *         ADC instance must be disabled.
  *         This condition is applied to all ADC features, for efficiency
  *         and compatibility over all STM32 families. However, the different
  *         features can be set under different ADC state conditions
  *         (setting possible with ADC enabled without conversion on going,
  *         ADC enabled with conversion on going, ...)
  *         Each feature can be updated afterwards with a unitary function
  *         and potentially with ADC in a different state than disabled,
  *         refer to description of each function for setting
  *         conditioned to ADC state.
  */
typedef struct
{
  uint32_t TriggerSource;               /*!< Set ADC group injected conversion trigger source: internal (SW start) or from external IP (timer event, external interrupt line).
                                             This parameter can be a value of @ref ADC_LL_EC_INJ_TRIGGER_SOURCE
                                             @note On this STM32 serie, setting trigger source to external trigger also set trigger polarity to rising edge
                                                   (default setting for compatibility with some ADC on other STM32 families having this setting set by HW default value).
                                                   In case of need to modify trigger edge, use function @ref LL_ADC_INJ_SetTriggerEdge().
                                             
                                             This feature can be modified afterwards using unitary function @ref LL_ADC_INJ_SetTriggerSource(). */

  uint32_t SequencerLength;             /*!< Set ADC group injected sequencer length.
                                             This parameter can be a value of @ref ADC_LL_EC_INJ_SEQ_SCAN_LENGTH
                                             
                                             This feature can be modified afterwards using unitary function @ref LL_ADC_INJ_SetSequencerLength(). */

  uint32_t SequencerDiscont;            /*!< Set ADC group injected sequencer discontinuous mode: sequence subdivided and scan conversions interrupted every selected number of ranks.
                                             This parameter can be a value of @ref ADC_LL_EC_INJ_SEQ_DISCONT_MODE
                                             @note This parameter has an effect only if group injected sequencer is enabled
                                                   (scan length of 2 ranks or more).
                                             
                                             This feature can be modified afterwards using unitary function @ref LL_ADC_INJ_SetSequencerDiscont(). */

  uint32_t TrigAuto;                    /*!< Set ADC group injected conversion trigger: independent or from ADC group regular.
                                             This parameter can be a value of @ref ADC_LL_EC_INJ_TRIG_AUTO
                                             Note: This parameter must be set to set to independent trigger if injected trigger source is set to an external trigger. 
                                             
                                             This feature can be modified afterwards using unitary function @ref LL_ADC_INJ_SetTrigAuto(). */

} LL_ADC_INJ_InitTypeDef;

/**
  * @}
  */

/* Exported constants --------------------------------------------------------*/
/** @defgroup ADC_LL_Exported_Constants ADC Exported Constants
  * @{
  */

/** @defgroup ADC_LL_EC_FLAG ADC flags
  * @brief    Flags defines which can be used with LL_ADC_ReadReg function
  * @{
  */
#define LL_ADC_FLAG_ADRDY                  ADC_ISR_ADRDY      /*!< ADC flag ADC instance ready */
#define LL_ADC_FLAG_EOC                    ADC_ISR_EOC        /*!< ADC flag ADC group regular end of unitary conversion */
#define LL_ADC_FLAG_EOS                    ADC_ISR_EOS        /*!< ADC flag ADC group regular end of sequence conversions */
#define LL_ADC_FLAG_OVR                    ADC_ISR_OVR        /*!< ADC flag ADC group regular overrun */
#define LL_ADC_FLAG_EOSMP                  ADC_ISR_EOSMP      /*!< ADC flag ADC group regular end of sampling phase */
#define LL_ADC_FLAG_JEOC                   ADC_ISR_JEOC       /*!< ADC flag ADC group injected end of unitary conversion */
#define LL_ADC_FLAG_JEOS                   ADC_ISR_JEOS       /*!< ADC flag ADC group injected end of sequence conversions */
#define LL_ADC_FLAG_JQOVF                  ADC_ISR_JQOVF      /*!< ADC flag ADC group injected contexts queue overflow */
#define LL_ADC_FLAG_AWD1                   ADC_ISR_AWD1       /*!< ADC flag ADC analog watchdog 1 */
#define LL_ADC_FLAG_AWD2                   ADC_ISR_AWD2       /*!< ADC flag ADC analog watchdog 2 */
#define LL_ADC_FLAG_AWD3                   ADC_ISR_AWD3       /*!< ADC flag ADC analog watchdog 3 */
#if defined(ADC_MULTIMODE_SUPPORT)
#define LL_ADC_FLAG_ADRDY_MST              ADC_CSR_ADRDY_MST  /*!< ADC flag ADC multimode master instance ready */
#define LL_ADC_FLAG_ADRDY_SLV              ADC_CSR_ADRDY_SLV  /*!< ADC flag ADC multimode slave instance ready */
#define LL_ADC_FLAG_EOC_MST                ADC_CSR_EOC_MST    /*!< ADC flag ADC multimode master group regular end of unitary conversion */
#define LL_ADC_FLAG_EOC_SLV                ADC_CSR_EOC_SLV    /*!< ADC flag ADC multimode slave group regular end of unitary conversion */
#define LL_ADC_FLAG_EOS_MST                ADC_CSR_EOS_MST    /*!< ADC flag ADC multimode master group regular end of sequence conversions */
#define LL_ADC_FLAG_EOS_SLV                ADC_CSR_EOS_SLV    /*!< ADC flag ADC multimode slave group regular end of sequence conversions */
#define LL_ADC_FLAG_OVR_MST                ADC_CSR_OVR_MST    /*!< ADC flag ADC multimode master group regular overrun */
#define LL_ADC_FLAG_OVR_SLV                ADC_CSR_OVR_SLV    /*!< ADC flag ADC multimode slave group regular overrun */
#define LL_ADC_FLAG_EOSMP_MST              ADC_CSR_EOSMP_MST  /*!< ADC flag ADC multimode master group regular end of sampling phase */
#define LL_ADC_FLAG_EOSMP_SLV              ADC_CSR_EOSMP_SLV  /*!< ADC flag ADC multimode slave group regular end of sampling phase */
#define LL_ADC_FLAG_JEOC_MST               ADC_CSR_JEOC_MST   /*!< ADC flag ADC multimode master group injected end of unitary conversion */
#define LL_ADC_FLAG_JEOC_SLV               ADC_CSR_JEOC_SLV   /*!< ADC flag ADC multimode slave group injected end of unitary conversion */
#define LL_ADC_FLAG_JEOS_MST               ADC_CSR_JEOS_MST   /*!< ADC flag ADC multimode master group injected end of sequence conversions */
#define LL_ADC_FLAG_JEOS_SLV               ADC_CSR_JEOS_SLV   /*!< ADC flag ADC multimode slave group injected end of sequence conversions */
#define LL_ADC_FLAG_JQOVF_MST              ADC_CSR_JQOVF_MST  /*!< ADC flag ADC multimode master group injected contexts queue overflow */
#define LL_ADC_FLAG_JQOVF_SLV              ADC_CSR_JQOVF_SLV  /*!< ADC flag ADC multimode slave group injected contexts queue overflow */
#define LL_ADC_FLAG_AWD1_MST               ADC_CSR_AWD1_MST   /*!< ADC flag ADC multimode master analog watchdog 1 of the ADC master */
#define LL_ADC_FLAG_AWD1_SLV               ADC_CSR_AWD1_SLV   /*!< ADC flag ADC multimode slave analog watchdog 1 of the ADC slave */
#define LL_ADC_FLAG_AWD2_MST               ADC_CSR_AWD2_MST   /*!< ADC flag ADC multimode master analog watchdog 2 of the ADC master */
#define LL_ADC_FLAG_AWD2_SLV               ADC_CSR_AWD2_SLV   /*!< ADC flag ADC multimode slave analog watchdog 2 of the ADC slave */
#define LL_ADC_FLAG_AWD3_MST               ADC_CSR_AWD3_MST   /*!< ADC flag ADC multimode master analog watchdog 3 of the ADC master */
#define LL_ADC_FLAG_AWD3_SLV               ADC_CSR_AWD3_SLV   /*!< ADC flag ADC multimode slave analog watchdog 3 of the ADC slave */
#endif
/**
  * @}
  */

/** @defgroup ADC_LL_EC_IT ADC interruptions for configuration (interruption enable or disable)
  * @brief    IT defines which can be used with LL_ADC_ReadReg and  LL_ADC_WriteReg functions
  * @{
  */
#define LL_ADC_IT_ADRDY                    ADC_IER_ADRDYIE    /*!< ADC interruption ADC instance ready */
#define LL_ADC_IT_EOC                      ADC_IER_EOCIE      /*!< ADC interruption ADC group regular end of unitary conversion */
#define LL_ADC_IT_EOS                      ADC_IER_EOSIE      /*!< ADC interruption ADC group regular end of sequence conversions */
#define LL_ADC_IT_OVR                      ADC_IER_OVRIE      /*!< ADC interruption ADC group regular overrun */
#define LL_ADC_IT_EOSMP                    ADC_IER_EOSMPIE    /*!< ADC interruption ADC group regular end of sampling phase */
#define LL_ADC_IT_JEOC                     ADC_IER_JEOCIE     /*!< ADC interruption ADC group injected end of unitary conversion */
#define LL_ADC_IT_JEOS                     ADC_IER_JEOSIE     /*!< ADC interruption ADC group injected end of sequence conversions */
#define LL_ADC_IT_JQOVF                    ADC_IER_JQOVFIE    /*!< ADC interruption ADC group injected contexts queue overflow */
#define LL_ADC_IT_AWD1                     ADC_IER_AWD1IE     /*!< ADC interruption ADC analog watchdog 1 */
#define LL_ADC_IT_AWD2                     ADC_IER_AWD2IE     /*!< ADC interruption ADC analog watchdog 2 */
#define LL_ADC_IT_AWD3                     ADC_IER_AWD3IE     /*!< ADC interruption ADC analog watchdog 3 */
/**
  * @}
  */

/** @defgroup ADC_LL_EC_REGISTERS  ADC registers compliant with specific purpose
  * @{
  */
/* List of ADC registers intended to be used (most commonly) with             */
/* DMA transfer.                                                              */
/* Refer to function @ref LL_ADC_DMA_GetRegAddr().                            */
#define LL_ADC_DMA_REG_REGULAR_DATA          ((uint32_t)0x00000000U) /* ADC group regular conversion data register (corresponding to register DR) to be used with ADC configured in independent mode. Without DMA transfer, register accessed by LL function @ref LL_ADC_REG_ReadConversionData32() and other functions @ref LL_ADC_REG_ReadConversionDatax() */
#if defined(ADC_MULTIMODE_SUPPORT)
#define LL_ADC_DMA_REG_REGULAR_DATA_MULTI    ((uint32_t)0x00000001U) /* ADC group regular conversion data register (corresponding to register CDR) to be used with ADC configured in multimode (available on STM32 devices with several ADC instances). Without DMA transfer, register accessed by LL function @ref LL_ADC_REG_ReadMultiConversionData32() */
#endif
/**
  * @}
  */

/** @defgroup ADC_LL_EC_COMMON_CLOCK_SOURCE  ADC common - Clock source
  * @{
  */
#define LL_ADC_CLOCK_SYNC_PCLK_DIV1        (ADC_CCR_CKMODE_0)                                    /*!< ADC synchronous clock derived from AHB clock without prescaler */
#define LL_ADC_CLOCK_SYNC_PCLK_DIV2        (ADC_CCR_CKMODE_1                   )                 /*!< ADC synchronous clock derived from AHB clock with prescaler division by 2 */
#define LL_ADC_CLOCK_SYNC_PCLK_DIV4        (ADC_CCR_CKMODE_1 | ADC_CCR_CKMODE_0)                 /*!< ADC synchronous clock derived from AHB clock with prescaler division by 4 */
#define LL_ADC_CLOCK_ASYNC_DIV1            ((uint32_t)0x00000000U)                               /*!< ADC asynchronous clock without prescaler */
/**
  * @}
  */

/** @defgroup ADC_LL_EC_COMMON_PATH_INTERNAL  ADC common - Measurement path to internal channels
  * @{
  */
/* Note: Other measurement paths to internal channels may be available        */
/*       (connections to other peripherals).                                  */
/*       If they are not listed below, they do not require any specific       */
/*       path enable. In this case, Access to measurement path is done        */
/*       only by selecting the corresponding ADC internal channel.            */
#define LL_ADC_PATH_INTERNAL_NONE          ((uint32_t)0x00000000U)/*!< ADC measurement pathes all disabled */
#define LL_ADC_PATH_INTERNAL_VREFINT       (ADC_CCR_VREFEN)       /*!< ADC measurement path to internal channel VrefInt */
#define LL_ADC_PATH_INTERNAL_TEMPSENSOR    (ADC_CCR_TSEN)         /*!< ADC measurement path to internal channel temperature sensor */
#define LL_ADC_PATH_INTERNAL_VBAT          (ADC_CCR_VBATEN)       /*!< ADC measurement path to internal channel Vbat */
/**
  * @}
  */

/** @defgroup ADC_LL_EC_RESOLUTION  ADC instance - Resolution
  * @{
  */
#define LL_ADC_RESOLUTION_12B              ((uint32_t)0x00000000U)             /*!< ADC resolution 12 bits */
#define LL_ADC_RESOLUTION_10B              (                 ADC_CFGR_RES_0)   /*!< ADC resolution 10 bits */
#define LL_ADC_RESOLUTION_8B               (ADC_CFGR_RES_1                 )   /*!< ADC resolution  8 bits */
#define LL_ADC_RESOLUTION_6B               (ADC_CFGR_RES_1 | ADC_CFGR_RES_0)   /*!< ADC resolution  6 bits */
/**
  * @}
  */

/** @defgroup ADC_LL_EC_DATA_ALIGN  ADC instance - Data alignment
  * @{
  */
#define LL_ADC_DATA_ALIGN_RIGHT            ((uint32_t)0x00000000U)/*!< ADC conversion data alignment: right aligned (alignment on data register LSB bit 0)*/
#define LL_ADC_DATA_ALIGN_LEFT             (ADC_CFGR_ALIGN)       /*!< ADC conversion data alignment: left aligned (aligment on data register MSB bit 15)*/
/**
  * @}
  */

/** @defgroup ADC_LL_EC_LP_MODE  ADC instance - Low power mode
  * @{
  */
#define LL_ADC_LP_MODE_NONE                ((uint32_t)0x00000000U)              /*!< No ADC low power mode activated */
#define LL_ADC_LP_AUTOWAIT                 (ADC_CFGR_AUTDLY)                   /*!< ADC low power mode auto delay: Dynamic low power mode, ADC conversions are performed only when necessary (when previous ADC conversion data is read). See description with function @ref LL_ADC_SetLowPowerMode(). */
/**
  * @}
  */

/** @defgroup ADC_LL_EC_OFFSET_NB  ADC instance - Offset number
  * @{
  */
#define LL_ADC_OFFSET_1                    ADC_OFR1_REGOFFSET /*!< ADC offset number 1: ADC channel and offset level to which the offset programmed will be applied (independently of channel mapped on ADC group regular or group injected) */
#define LL_ADC_OFFSET_2                    ADC_OFR2_REGOFFSET /*!< ADC offset number 2: ADC channel and offset level to which the offset programmed will be applied (independently of channel mapped on ADC group regular or group injected) */
#define LL_ADC_OFFSET_3                    ADC_OFR3_REGOFFSET /*!< ADC offset number 3: ADC channel and offset level to which the offset programmed will be applied (independently of channel mapped on ADC group regular or group injected) */
#define LL_ADC_OFFSET_4                    ADC_OFR4_REGOFFSET /*!< ADC offset number 4: ADC channel and offset level to which the offset programmed will be applied (independently of channel mapped on ADC group regular or group injected) */
/**
  * @}
  */

/** @defgroup ADC_LL_EC_OFFSET_STATE ADC instance - Offset state
  * @{
  */
#define LL_ADC_OFFSET_DISABLE              ((uint32_t)0x00000000U)/*!< ADC offset disabled (among ADC selected offset number 1, 2, 3 or 4) */
#define LL_ADC_OFFSET_ENABLE               (ADC_OFR1_OFFSET1_EN)  /*!< ADC offset enabled (among ADC selected offset number 1, 2, 3 or 4) */
/**
  * @}
  */

/** @defgroup ADC_LL_EC_GROUPS  ADC instance - Groups
  * @{
  */
#define LL_ADC_GROUP_REGULAR               ((uint32_t)0x00000001U) /*!< ADC group regular (available on all STM32 devices) */
#define LL_ADC_GROUP_INJECTED              ((uint32_t)0x00000002U) /*!< ADC group injected (not available on all STM32 devices)*/
#define LL_ADC_GROUP_REGULAR_INJECTED      ((uint32_t)0x00000003U) /*!< ADC both groups regular and injected */
/**
  * @}
  */

/** @defgroup ADC_LL_EC_CHANNEL  ADC instance - Channel number
  * @{
  */
#define LL_ADC_CHANNEL_0                   (ADC_CHANNEL_0_NUMBER  | ADC_CHANNEL_0_SMP  | ADC_CHANNEL_0_BITFIELD ) /*!< ADC external channel (channel connected to GPIO pin) ADCx_IN0  */
#define LL_ADC_CHANNEL_1                   (ADC_CHANNEL_1_NUMBER  | ADC_CHANNEL_1_SMP  | ADC_CHANNEL_1_BITFIELD ) /*!< ADC external channel (channel connected to GPIO pin) ADCx_IN1  */
#define LL_ADC_CHANNEL_2                   (ADC_CHANNEL_2_NUMBER  | ADC_CHANNEL_2_SMP  | ADC_CHANNEL_2_BITFIELD ) /*!< ADC external channel (channel connected to GPIO pin) ADCx_IN2  */
#define LL_ADC_CHANNEL_3                   (ADC_CHANNEL_3_NUMBER  | ADC_CHANNEL_3_SMP  | ADC_CHANNEL_3_BITFIELD ) /*!< ADC external channel (channel connected to GPIO pin) ADCx_IN3  */
#define LL_ADC_CHANNEL_4                   (ADC_CHANNEL_4_NUMBER  | ADC_CHANNEL_4_SMP  | ADC_CHANNEL_4_BITFIELD ) /*!< ADC external channel (channel connected to GPIO pin) ADCx_IN4  */
#define LL_ADC_CHANNEL_5                   (ADC_CHANNEL_5_NUMBER  | ADC_CHANNEL_5_SMP  | ADC_CHANNEL_5_BITFIELD ) /*!< ADC external channel (channel connected to GPIO pin) ADCx_IN5  */
#define LL_ADC_CHANNEL_6                   (ADC_CHANNEL_6_NUMBER  | ADC_CHANNEL_6_SMP  | ADC_CHANNEL_6_BITFIELD ) /*!< ADC external channel (channel connected to GPIO pin) ADCx_IN6  */
#define LL_ADC_CHANNEL_7                   (ADC_CHANNEL_7_NUMBER  | ADC_CHANNEL_7_SMP  | ADC_CHANNEL_7_BITFIELD ) /*!< ADC external channel (channel connected to GPIO pin) ADCx_IN7  */
#define LL_ADC_CHANNEL_8                   (ADC_CHANNEL_8_NUMBER  | ADC_CHANNEL_8_SMP  | ADC_CHANNEL_8_BITFIELD ) /*!< ADC external channel (channel connected to GPIO pin) ADCx_IN8  */
#define LL_ADC_CHANNEL_9                   (ADC_CHANNEL_9_NUMBER  | ADC_CHANNEL_9_SMP  | ADC_CHANNEL_9_BITFIELD ) /*!< ADC external channel (channel connected to GPIO pin) ADCx_IN9  */
#define LL_ADC_CHANNEL_10                  (ADC_CHANNEL_10_NUMBER | ADC_CHANNEL_10_SMP | ADC_CHANNEL_10_BITFIELD) /*!< ADC external channel (channel connected to GPIO pin) ADCx_IN10 */
#define LL_ADC_CHANNEL_11                  (ADC_CHANNEL_11_NUMBER | ADC_CHANNEL_11_SMP | ADC_CHANNEL_11_BITFIELD) /*!< ADC external channel (channel connected to GPIO pin) ADCx_IN11 */
#define LL_ADC_CHANNEL_12                  (ADC_CHANNEL_12_NUMBER | ADC_CHANNEL_12_SMP | ADC_CHANNEL_12_BITFIELD) /*!< ADC external channel (channel connected to GPIO pin) ADCx_IN12 */
#define LL_ADC_CHANNEL_13                  (ADC_CHANNEL_13_NUMBER | ADC_CHANNEL_13_SMP | ADC_CHANNEL_13_BITFIELD) /*!< ADC external channel (channel connected to GPIO pin) ADCx_IN13 */
#define LL_ADC_CHANNEL_14                  (ADC_CHANNEL_14_NUMBER | ADC_CHANNEL_14_SMP | ADC_CHANNEL_14_BITFIELD) /*!< ADC external channel (channel connected to GPIO pin) ADCx_IN14 */
#define LL_ADC_CHANNEL_15                  (ADC_CHANNEL_15_NUMBER | ADC_CHANNEL_15_SMP | ADC_CHANNEL_15_BITFIELD) /*!< ADC external channel (channel connected to GPIO pin) ADCx_IN15 */
#define LL_ADC_CHANNEL_16                  (ADC_CHANNEL_16_NUMBER | ADC_CHANNEL_16_SMP | ADC_CHANNEL_16_BITFIELD) /*!< ADC external channel (channel connected to GPIO pin) ADCx_IN16 */
#define LL_ADC_CHANNEL_17                  (ADC_CHANNEL_17_NUMBER | ADC_CHANNEL_17_SMP | ADC_CHANNEL_17_BITFIELD) /*!< ADC external channel (channel connected to GPIO pin) ADCx_IN17 */
#define LL_ADC_CHANNEL_18                  (ADC_CHANNEL_18_NUMBER | ADC_CHANNEL_18_SMP | ADC_CHANNEL_18_BITFIELD) /*!< ADC external channel (channel connected to GPIO pin) ADCx_IN18 */
#define LL_ADC_CHANNEL_VREFINT             (LL_ADC_CHANNEL_18 | ADC_CHANNEL_ID_INTERNAL_CH) /*!< ADC internal channel connected to VrefInt: Internal voltage reference. On STM32F3, ADC channel available only on all ADC instances, but only one ADC instance is allowed to be connected to VrefInt at the same time. */
#define LL_ADC_CHANNEL_TEMPSENSOR          (LL_ADC_CHANNEL_16 | ADC_CHANNEL_ID_INTERNAL_CH) /*!< ADC internal channel connected to Temperature sensor. On STM32F3, ADC channel available only on ADC instance: ADC1. */
#define LL_ADC_CHANNEL_VBAT                (LL_ADC_CHANNEL_17 | ADC_CHANNEL_ID_INTERNAL_CH) /*!< ADC internal channel connected to Vbat/3: Vbat voltage through a divider ladder of factor 1/3 to have Vbat always below Vdda. On STM32F3, ADC channel available only on ADC instance: ADC1. */
#if defined(OPAMP1_CSR_OPAMP1EN)
#define LL_ADC_CHANNEL_VOPAMP1             (LL_ADC_CHANNEL_15 | ADC_CHANNEL_ID_INTERNAL_CH) /*!< ADC internal channel connected to OPAMP1 output. On STM32F3, ADC channel available only on ADC instance: ADC1. */
#endif
#if defined(OPAMP2_CSR_OPAMP2EN)
#define LL_ADC_CHANNEL_VOPAMP2             (LL_ADC_CHANNEL_17 | ADC_CHANNEL_ID_INTERNAL_CH | ADC_CHANNEL_ID_INTERNAL_CH_2) /*!< ADC internal channel connected to OPAMP2 output. On STM32F3, ADC channel available only on ADC instance: ADC2. */
#endif
#if defined(OPAMP3_CSR_OPAMP3EN)
#define LL_ADC_CHANNEL_VOPAMP3             (LL_ADC_CHANNEL_17 | ADC_CHANNEL_ID_INTERNAL_CH | ADC_CHANNEL_ID_INTERNAL_CH_2) /*!< ADC internal channel connected to OPAMP3 output. On STM32F3, ADC channel available only on ADC instance: ADC3. */
#endif
#if defined(OPAMP4_CSR_OPAMP4EN)
#define LL_ADC_CHANNEL_VOPAMP4             (LL_ADC_CHANNEL_17 | ADC_CHANNEL_ID_INTERNAL_CH | ADC_CHANNEL_ID_INTERNAL_CH_2) /*!< ADC internal channel connected to OPAMP4 output. On STM32F3, ADC channel available only on ADC instance: ADC4. */
#endif
/**
  * @}
  */

/** @defgroup ADC_LL_EC_REG_TRIGGER_SOURCE  ADC group regular - Trigger source
  * @{
  */
#define LL_ADC_REG_TRIG_SOFTWARE              ((uint32_t)0x00000000U)                                                                      /*!< ADC group regular conversion trigger internal: SW start. */
#if defined(STM32F303xC) || defined(STM32F358xx) || defined(STM32F303xE) || defined(STM32F398xx)
/* ADC group regular external triggers for ADC instances: ADC1, ADC2 (for     */
/* ADC instances ADCx available on the selected device)                       */
/* Note: Literal without suffix "ADCxy" means that external trigger           */
/*       is available on all ADC instances.                                   */
/* Note: For devices STM32F303xE, STM32F398xx: some triggers require to set   */
/*       register SYSCFG_CFGR4. Refer to reference manual.                    */
#define LL_ADC_REG_TRIG_EXT_TIM1_CH1_ADC12    (ADC_REG_TRIG_EXT_EDGE_DEFAULT)                                                              /*!< ADC group regular conversion trigger from external IP: TIM1 channel 1 event (capture compare: input capture or output capture). Trigger edge set to rising edge (default setting). */
#define LL_ADC_REG_TRIG_EXT_TIM1_CH2_ADC12    (ADC_CFGR_EXTSEL_0 | ADC_REG_TRIG_EXT_EDGE_DEFAULT)                                          /*!< ADC group regular conversion trigger from external IP: TIM1 channel 2 event (capture compare: input capture or output capture). Trigger edge set to rising edge (default setting). */
#define LL_ADC_REG_TRIG_EXT_TIM1_CH3          (ADC_CFGR_EXTSEL_1 | ADC_REG_TRIG_EXT_EDGE_DEFAULT)                                          /*!< ADC group regular conversion trigger from external IP: TIM1 channel 3 event (capture compare: input capture or output capture). Trigger edge set to rising edge (default setting). */
#define LL_ADC_REG_TRIG_EXT_TIM2_CH2_ADC12    (ADC_CFGR_EXTSEL_1 | ADC_CFGR_EXTSEL_0 | ADC_REG_TRIG_EXT_EDGE_DEFAULT)                      /*!< ADC group regular conversion trigger from external IP: TIM2 channel 2 event (capture compare: input capture or output capture). Trigger edge set to rising edge (default setting). */
#define LL_ADC_REG_TRIG_EXT_TIM3_TRGO_ADC12   (ADC_CFGR_EXTSEL_2 | ADC_REG_TRIG_EXT_EDGE_DEFAULT)                                          /*!< ADC group regular conversion trigger from external IP: TIM3 TRGO. Trigger edge set to rising edge (default setting). */
#define LL_ADC_REG_TRIG_EXT_TIM4_CH4_ADC12    (ADC_CFGR_EXTSEL_2 | ADC_CFGR_EXTSEL_0 | ADC_REG_TRIG_EXT_EDGE_DEFAULT)                      /*!< ADC group regular conversion trigger from external IP: TIM4 channel 4 event (capture compare: input capture or output capture). Trigger edge set to rising edge (default setting). */
#define LL_ADC_REG_TRIG_EXT_EXTI_LINE11_ADC12 (ADC_CFGR_EXTSEL_2 | ADC_CFGR_EXTSEL_1 | ADC_REG_TRIG_EXT_EDGE_DEFAULT)                      /*!< ADC group regular conversion trigger from external IP: external interrupt line 11. Trigger edge set to rising edge (default setting). */
#define LL_ADC_REG_TRIG_EXT_TIM8_TRGO_ADC12   (ADC_CFGR_EXTSEL_2 | ADC_CFGR_EXTSEL_1 | ADC_CFGR_EXTSEL_0 | ADC_REG_TRIG_EXT_EDGE_DEFAULT)  /*!< ADC group regular conversion trigger from external IP: TIM8 TRGO. Trigger edge set to rising edge (default setting). */
#define LL_ADC_REG_TRIG_EXT_TIM8_TRGO2        (ADC_CFGR_EXTSEL_3 | ADC_REG_TRIG_EXT_EDGE_DEFAULT)                                          /*!< ADC group regular conversion trigger from external IP: TIM8 TRGO2. Trigger edge set to rising edge (default setting). */
#define LL_ADC_REG_TRIG_EXT_TIM1_TRGO         (ADC_CFGR_EXTSEL_3 | ADC_CFGR_EXTSEL_0 | ADC_REG_TRIG_EXT_EDGE_DEFAULT)                      /*!< ADC group regular conversion trigger from external IP: TIM1 TRGO. Trigger edge set to rising edge (default setting). */
#define LL_ADC_REG_TRIG_EXT_TIM1_TRGO2        (ADC_CFGR_EXTSEL_3 | ADC_CFGR_EXTSEL_1 | ADC_REG_TRIG_EXT_EDGE_DEFAULT)                      /*!< ADC group regular conversion trigger from external IP: TIM1 TRGO2. Trigger edge set to rising edge (default setting). */
#define LL_ADC_REG_TRIG_EXT_TIM2_TRGO_ADC12   (ADC_CFGR_EXTSEL_3 | ADC_CFGR_EXTSEL_1 | ADC_CFGR_EXTSEL_0 | ADC_REG_TRIG_EXT_EDGE_DEFAULT)  /*!< ADC group regular conversion trigger from external IP: TIM2 TRGO. Trigger edge set to rising edge (default setting). */
#define LL_ADC_REG_TRIG_EXT_TIM4_TRGO         (ADC_CFGR_EXTSEL_3 | ADC_CFGR_EXTSEL_2 | ADC_REG_TRIG_EXT_EDGE_DEFAULT)                      /*!< ADC group regular conversion trigger from external IP: TIM4 TRGO. Trigger edge set to rising edge (default setting). */
#define LL_ADC_REG_TRIG_EXT_TIM6_TRGO_ADC12   (ADC_CFGR_EXTSEL_3 | ADC_CFGR_EXTSEL_2 | ADC_CFGR_EXTSEL_0 | ADC_REG_TRIG_EXT_EDGE_DEFAULT)  /*!< ADC group regular conversion trigger from external IP: TIM6 TRGO. Trigger edge set to rising edge (default setting). */
#define LL_ADC_REG_TRIG_EXT_TIM15_TRGO        (ADC_CFGR_EXTSEL_3 | ADC_CFGR_EXTSEL_2 | ADC_CFGR_EXTSEL_1 | ADC_REG_TRIG_EXT_EDGE_DEFAULT)  /*!< ADC group regular conversion trigger from external IP: TIM15 TRGO. Trigger edge set to rising edge (default setting). */
#define LL_ADC_REG_TRIG_EXT_TIM3_CH4_ADC12    (ADC_CFGR_EXTSEL | ADC_REG_TRIG_EXT_EDGE_DEFAULT)                                            /*!< ADC group regular conversion trigger from external IP: TIM3 channel 4 event (capture compare: input capture or output capture). Trigger edge set to rising edge (default setting). */
#if defined(STM32F303xE) || defined(STM32F398xx)
#define LL_ADC_REG_TRIG_EXT_TIM20_TRG0_ADC12  (LL_ADC_REG_TRIG_EXT_TIM1_CH3)                                                               /*!< ADC group regular conversion trigger from external IP: TIM20 TRGO. Trigger edge set to rising edge (default setting). */
#define LL_ADC_REG_TRIG_EXT_TIM20_TRG02_ADC12 (LL_ADC_REG_TRIG_EXT_TIM2_CH2_ADC12)                                                         /*!< ADC group regular conversion trigger from external IP: TIM20 TRGO2. Trigger edge set to rising edge (default setting). */
#define LL_ADC_REG_TRIG_EXT_TIM20_CH1_ADC12   (LL_ADC_REG_TRIG_EXT_TIM4_CH4_ADC12)                                                         /*!< ADC group regular conversion trigger from external IP: TIM20 channel 1 event (capture compare: input capture or output capture). Trigger edge set to rising edge (default setting). */
#define LL_ADC_REG_TRIG_EXT_TIM20_CH2_ADC12   (LL_ADC_REG_TRIG_EXT_TIM6_TRGO_ADC12)                                                        /*!< ADC group regular conversion trigger from external IP: TIM20 channel 2 event (capture compare: input capture or output capture). Trigger edge set to rising edge (default setting). */
#define LL_ADC_REG_TRIG_EXT_TIM20_CH3_ADC12   (LL_ADC_REG_TRIG_EXT_TIM3_CH4_ADC12)                                                         /*!< ADC group regular conversion trigger from external IP: TIM20 channel 3 event (capture compare: input capture or output capture). Trigger edge set to rising edge (default setting). */
#endif /* STM32F303xE || STM32F398xx */

/* ADC group regular external triggers for ADC instances: ADC3, ADC4 (for     */
/* ADC instances ADCx available on the selected device)                       */
/* Note: Literal without suffix "ADCxy" means that external trigger           */
/*       is available on all ADC instances.                                   */
/* Note: For devices STM32F303xE, STM32F398xx: some triggers require to set   */
/*       register SYSCFG_CFGR4. Refer to reference manual.                    */
#define LL_ADC_REG_TRIG_EXT_TIM3_CH1_ADC34    (ADC_REG_TRIG_EXT_EDGE_DEFAULT)                                                              /*!< ADC group regular conversion trigger from external IP: TIM3 channel 1 event (capture compare: input capture or output capture). Trigger edge set to rising edge (default setting). */
#define LL_ADC_REG_TRIG_EXT_TIM2_CH3_ADC34    (ADC_CFGR_EXTSEL_0 | ADC_REG_TRIG_EXT_EDGE_DEFAULT)                                          /*!< ADC group regular conversion trigger from external IP: TIM2 channel 3 event (capture compare: input capture or output capture). Trigger edge set to rising edge (default setting). */
#define LL_ADC_REG_TRIG_EXT_TIM1_CH3          (ADC_CFGR_EXTSEL_1 | ADC_REG_TRIG_EXT_EDGE_DEFAULT)                                          /*!< ADC group regular conversion trigger from external IP: TIM1 channel 3 event (capture compare: input capture or output capture). Trigger edge set to rising edge (default setting). */
#define LL_ADC_REG_TRIG_EXT_TIM8_CH1_ADC34    (ADC_CFGR_EXTSEL_1 | ADC_CFGR_EXTSEL_0 | ADC_REG_TRIG_EXT_EDGE_DEFAULT)                      /*!< ADC group regular conversion trigger from external IP: TIM8 channel 1 event (capture compare: input capture or output capture). Trigger edge set to rising edge (default setting). */
#define LL_ADC_REG_TRIG_EXT_TIM8_TRGO__ADC34  (ADC_CFGR_EXTSEL_2 | ADC_REG_TRIG_EXT_EDGE_DEFAULT)                                          /*!< ADC group regular conversion trigger from external IP: TIM8 TRGO. Trigger edge set to rising edge (default setting). */
#define LL_ADC_REG_TRIG_EXT_EXTI_LINE2_ADC34  (ADC_CFGR_EXTSEL_2 | ADC_CFGR_EXTSEL_0 | ADC_REG_TRIG_EXT_EDGE_DEFAULT)                      /*!< ADC group regular conversion trigger from external IP: external interrupt line 2. Trigger edge set to rising edge (default setting). */
#define LL_ADC_REG_TRIG_EXT_TIM4_CH1_ADC34    (ADC_CFGR_EXTSEL_2 | ADC_CFGR_EXTSEL_1 | ADC_REG_TRIG_EXT_EDGE_DEFAULT)                      /*!< ADC group regular conversion trigger from external IP: TIM4 channel 1 event (capture compare: input capture or output capture). Trigger edge set to rising edge (default setting). */
#define LL_ADC_REG_TRIG_EXT_TIM2_TRGO__ADC34  (ADC_CFGR_EXTSEL_2 | ADC_CFGR_EXTSEL_1 | ADC_CFGR_EXTSEL_0 | ADC_REG_TRIG_EXT_EDGE_DEFAULT)  /*!< ADC group regular conversion trigger from external IP: TIM2 TRGO. Trigger edge set to rising edge (default setting). */
#define LL_ADC_REG_TRIG_EXT_TIM8_TRGO2        (ADC_CFGR_EXTSEL_3 | ADC_REG_TRIG_EXT_EDGE_DEFAULT)                                          /*!< ADC group regular conversion trigger from external IP: TIM8 TRGO2. Trigger edge set to rising edge (default setting). */
#define LL_ADC_REG_TRIG_EXT_TIM1_TRGO         (ADC_CFGR_EXTSEL_3 | ADC_CFGR_EXTSEL_0 | ADC_REG_TRIG_EXT_EDGE_DEFAULT)                      /*!< ADC group regular conversion trigger from external IP: TIM1 TRGO. Trigger edge set to rising edge (default setting). */
#define LL_ADC_REG_TRIG_EXT_TIM1_TRGO2        (ADC_CFGR_EXTSEL_3 | ADC_CFGR_EXTSEL_1 | ADC_REG_TRIG_EXT_EDGE_DEFAULT)                      /*!< ADC group regular conversion trigger from external IP: TIM1 TRGO2. Trigger edge set to rising edge (default setting). */
#define LL_ADC_REG_TRIG_EXT_TIM3_TRGO__ADC34  (ADC_CFGR_EXTSEL_3 | ADC_CFGR_EXTSEL_1 | ADC_CFGR_EXTSEL_0 | ADC_REG_TRIG_EXT_EDGE_DEFAULT)  /*!< ADC group regular conversion trigger from external IP: TIM3 TRGO. Trigger edge set to rising edge (default setting). */
#define LL_ADC_REG_TRIG_EXT_TIM4_TRGO         (ADC_CFGR_EXTSEL_3 | ADC_CFGR_EXTSEL_2 | ADC_REG_TRIG_EXT_EDGE_DEFAULT)                      /*!< ADC group regular conversion trigger from external IP: TIM4 TRGO. Trigger edge set to rising edge (default setting). */
#define LL_ADC_REG_TRIG_EXT_TIM7_TRGO_ADC34   (ADC_CFGR_EXTSEL_3 | ADC_CFGR_EXTSEL_2 | ADC_CFGR_EXTSEL_0 | ADC_REG_TRIG_EXT_EDGE_DEFAULT)  /*!< ADC group regular conversion trigger from external IP: TIM7 TRGO. Trigger edge set to rising edge (default setting). */
#define LL_ADC_REG_TRIG_EXT_TIM15_TRGO        (ADC_CFGR_EXTSEL_3 | ADC_CFGR_EXTSEL_2 | ADC_CFGR_EXTSEL_1 | ADC_REG_TRIG_EXT_EDGE_DEFAULT)  /*!< ADC group regular conversion trigger from external IP: TIM15 TRGO. Trigger edge set to rising edge (default setting). */
#define LL_ADC_REG_TRIG_EXT_TIM2_CH1_ADC34    (ADC_CFGR_EXTSEL | ADC_REG_TRIG_EXT_EDGE_DEFAULT)                                            /*!< ADC group regular conversion trigger from external IP: TIM2 CCx. Trigger edge set to rising edge (default setting). */
#if defined(STM32F303xE) || defined(STM32F398xx)
#define LL_ADC_REG_TRIG_EXT_TIM20_TRG0_ADC34  (LL_ADC_REG_TRIG_EXT_EXTI_LINE2_ADC34)                                                       /*!< ADC group regular conversion trigger from external IP: TIM20 TRGO. Trigger edge set to rising edge (default setting). */
#define LL_ADC_REG_TRIG_EXT_TIM20_TRG02_ADC34 (LL_ADC_REG_TRIG_EXT_TIM4_CH1_ADC34)                                                         /*!< ADC group regular conversion trigger from external IP: TIM20 TRGO2. Trigger edge set to rising edge (default setting). */
#define LL_ADC_REG_TRIG_EXT_TIM20_CH1_ADC34   (LL_ADC_REG_TRIG_EXT_TIM2_CH1_ADC34)                                                         /*!< ADC group regular conversion trigger from external IP: TIM20 channel 1 event (capture compare: input capture or output capture). Trigger edge set to rising edge (default setting). */              
#endif /* STM32F303xE || STM32F398xx */

#elif defined(STM32F303x8) || defined(STM32F328xx)
#define LL_ADC_REG_TRIG_EXT_TIM1_CH1          (ADC_REG_TRIG_EXT_EDGE_DEFAULT)                                                              /*!< ADC group regular conversion trigger from external IP: TIM1 channel 1 event (capture compare: input capture or output capture). Trigger edge set to rising edge (default setting). */
#define LL_ADC_REG_TRIG_EXT_TIM1_CH2          (ADC_CFGR_EXTSEL_0 | ADC_REG_TRIG_EXT_EDGE_DEFAULT)                                          /*!< ADC group regular conversion trigger from external IP: TIM1 channel 2 event (capture compare: input capture or output capture). Trigger edge set to rising edge (default setting). */
#define LL_ADC_REG_TRIG_EXT_TIM1_CH3          (ADC_CFGR_EXTSEL_1 | ADC_REG_TRIG_EXT_EDGE_DEFAULT)                                          /*!< ADC group regular conversion trigger from external IP: TIM1 channel 3 event (capture compare: input capture or output capture). Trigger edge set to rising edge (default setting). */
#define LL_ADC_REG_TRIG_EXT_TIM2_CH2          (ADC_CFGR_EXTSEL_1 | ADC_CFGR_EXTSEL_0 | ADC_REG_TRIG_EXT_EDGE_DEFAULT)                      /*!< ADC group regular conversion trigger from external IP: TIM2 channel 2 event (capture compare: input capture or output capture). Trigger edge set to rising edge (default setting). */
#define LL_ADC_REG_TRIG_EXT_TIM3_TRGO         (ADC_CFGR_EXTSEL_2 | ADC_REG_TRIG_EXT_EDGE_DEFAULT)                                          /*!< ADC group regular conversion trigger from external IP: TIM3 TRGO. Trigger edge set to rising edge (default setting). */
#define LL_ADC_REG_TRIG_EXT_TIM4_CH4          (ADC_CFGR_EXTSEL_2 | ADC_CFGR_EXTSEL_0 | ADC_REG_TRIG_EXT_EDGE_DEFAULT)                      /*!< ADC group regular conversion trigger from external IP: TIM4 channel 4 event (capture compare: input capture or output capture). Trigger edge set to rising edge (default setting). */
#define LL_ADC_REG_TRIG_EXT_EXTI_LINE11       (ADC_CFGR_EXTSEL_2 | ADC_CFGR_EXTSEL_1 | ADC_REG_TRIG_EXT_EDGE_DEFAULT)                      /*!< ADC group regular conversion trigger from external IP: external interrupt line 11. Trigger edge set to rising edge (default setting). */
#define LL_ADC_REG_TRIG_EXT_TIM8_TRGO         (ADC_CFGR_EXTSEL_2 | ADC_CFGR_EXTSEL_1 | ADC_CFGR_EXTSEL_0 | ADC_REG_TRIG_EXT_EDGE_DEFAULT)  /*!< ADC group regular conversion trigger from external IP: TIM8 TRGO. Trigger edge set to rising edge (default setting). */
#define LL_ADC_REG_TRIG_EXT_TIM1_TRGO         (ADC_CFGR_EXTSEL_3 | ADC_CFGR_EXTSEL_0 | ADC_REG_TRIG_EXT_EDGE_DEFAULT)                      /*!< ADC group regular conversion trigger from external IP: TIM1 TRGO. Trigger edge set to rising edge (default setting). */
#define LL_ADC_REG_TRIG_EXT_TIM1_TRGO2        (ADC_CFGR_EXTSEL_3 | ADC_CFGR_EXTSEL_1 | ADC_REG_TRIG_EXT_EDGE_DEFAULT)                      /*!< ADC group regular conversion trigger from external IP: TIM1 TRGO2. Trigger edge set to rising edge (default setting). */
#define LL_ADC_REG_TRIG_EXT_TIM2_TRGO         (ADC_CFGR_EXTSEL_3 | ADC_CFGR_EXTSEL_1 | ADC_CFGR_EXTSEL_0 | ADC_REG_TRIG_EXT_EDGE_DEFAULT)  /*!< ADC group regular conversion trigger from external IP: TIM2 TRGO. Trigger edge set to rising edge (default setting). */
#define LL_ADC_REG_TRIG_EXT_TIM4_TRGO         (ADC_CFGR_EXTSEL_3 | ADC_CFGR_EXTSEL_2 | ADC_REG_TRIG_EXT_EDGE_DEFAULT)                      /*!< ADC group regular conversion trigger from external IP: TIM4 TRGO. Trigger edge set to rising edge (default setting). */
#define LL_ADC_REG_TRIG_EXT_TIM6_TRGO         (ADC_CFGR_EXTSEL_3 | ADC_CFGR_EXTSEL_2 | ADC_CFGR_EXTSEL_0 | ADC_REG_TRIG_EXT_EDGE_DEFAULT)  /*!< ADC group regular conversion trigger from external IP: TIM6 TRGO. Trigger edge set to rising edge (default setting). */
#define LL_ADC_REG_TRIG_EXT_TIM15_TRGO        (ADC_CFGR_EXTSEL_3 | ADC_CFGR_EXTSEL_2 | ADC_CFGR_EXTSEL_1 | ADC_REG_TRIG_EXT_EDGE_DEFAULT)  /*!< ADC group regular conversion trigger from external IP: TIM15 TRGO. Trigger edge set to rising edge (default setting). */
#define LL_ADC_REG_TRIG_EXT_TIM3_CH4          (ADC_CFGR_EXTSEL | ADC_REG_TRIG_EXT_EDGE_DEFAULT)                                            /*!< ADC group regular conversion trigger from external IP: TIM3 channel 4 event (capture compare: input capture or output capture). Trigger edge set to rising edge (default setting). */

#elif defined(STM32F334x8)
#define LL_ADC_REG_TRIG_EXT_TIM1_CH1          (ADC_REG_TRIG_EXT_EDGE_DEFAULT)                                                              /*!< ADC group regular conversion trigger from external IP: TIM1 channel 1 event (capture compare: input capture or output capture). Trigger edge set to rising edge (default setting). */
#define LL_ADC_REG_TRIG_EXT_TIM1_CH2          (ADC_CFGR_EXTSEL_0 | ADC_REG_TRIG_EXT_EDGE_DEFAULT)                                          /*!< ADC group regular conversion trigger from external IP: TIM1 channel 2 event (capture compare: input capture or output capture). Trigger edge set to rising edge (default setting). */
#define LL_ADC_REG_TRIG_EXT_TIM1_CH3          (ADC_CFGR_EXTSEL_1 | ADC_REG_TRIG_EXT_EDGE_DEFAULT)                                          /*!< ADC group regular conversion trigger from external IP: TIM1 channel 3 event (capture compare: input capture or output capture). Trigger edge set to rising edge (default setting). */
#define LL_ADC_REG_TRIG_EXT_TIM2_CH2          (ADC_CFGR_EXTSEL_1 | ADC_CFGR_EXTSEL_0 | ADC_REG_TRIG_EXT_EDGE_DEFAULT)                      /*!< ADC group regular conversion trigger from external IP: TIM2 channel 2 event (capture compare: input capture or output capture). Trigger edge set to rising edge (default setting). */
#define LL_ADC_REG_TRIG_EXT_TIM3_TRGO         (ADC_CFGR_EXTSEL_2 | ADC_REG_TRIG_EXT_EDGE_DEFAULT)                                          /*!< ADC group regular conversion trigger from external IP: TIM3 TRGO. Trigger edge set to rising edge (default setting). */
#define LL_ADC_REG_TRIG_EXT_EXTI_LINE11       (ADC_CFGR_EXTSEL_2 | ADC_CFGR_EXTSEL_1 | ADC_REG_TRIG_EXT_EDGE_DEFAULT)                      /*!< ADC group regular conversion trigger from external IP: external interrupt line 11. Trigger edge set to rising edge (default setting). */
#define LL_ADC_REG_TRIG_EXT_HRTIM_TRG1        (ADC_CFGR_EXTSEL_2 | ADC_CFGR_EXTSEL_1 | ADC_CFGR_EXTSEL_0 | ADC_REG_TRIG_EXT_EDGE_DEFAULT)  /*!< ADC group regular conversion trigger from external IP: HRTIM TRG1. Trigger edge set to rising edge (default setting). */
#define LL_ADC_REG_TRIG_EXT_HRTIM_TRG3        (ADC_CFGR_EXTSEL_3 | ADC_REG_TRIG_EXT_EDGE_DEFAULT)                                          /*!< ADC group regular conversion trigger from external IP: HRTIM TRG3. Trigger edge set to rising edge (default setting). */
#define LL_ADC_REG_TRIG_EXT_TIM1_TRGO         (ADC_CFGR_EXTSEL_3 | ADC_CFGR_EXTSEL_0 | ADC_REG_TRIG_EXT_EDGE_DEFAULT)                      /*!< ADC group regular conversion trigger from external IP: TIM1 TRGO. Trigger edge set to rising edge (default setting). */
#define LL_ADC_REG_TRIG_EXT_TIM1_TRGO2        (ADC_CFGR_EXTSEL_3 | ADC_CFGR_EXTSEL_1 | ADC_REG_TRIG_EXT_EDGE_DEFAULT)                      /*!< ADC group regular conversion trigger from external IP: TIM1 TRGO2. Trigger edge set to rising edge (default setting). */
#define LL_ADC_REG_TRIG_EXT_TIM2_TRGO         (ADC_CFGR_EXTSEL_3 | ADC_CFGR_EXTSEL_1 | ADC_CFGR_EXTSEL_0 | ADC_REG_TRIG_EXT_EDGE_DEFAULT)  /*!< ADC group regular conversion trigger from external IP: TIM2 TRGO. Trigger edge set to rising edge (default setting). */
#define LL_ADC_REG_TRIG_EXT_TIM6_TRGO         (ADC_CFGR_EXTSEL_3 | ADC_CFGR_EXTSEL_2 | ADC_CFGR_EXTSEL_0 | ADC_REG_TRIG_EXT_EDGE_DEFAULT)  /*!< ADC group regular conversion trigger from external IP: TIM6 TRGO. Trigger edge set to rising edge (default setting). */
#define LL_ADC_REG_TRIG_EXT_TIM15_TRGO        (ADC_CFGR_EXTSEL_3 | ADC_CFGR_EXTSEL_2 | ADC_CFGR_EXTSEL_1 | ADC_REG_TRIG_EXT_EDGE_DEFAULT)  /*!< ADC group regular conversion trigger from external IP: TIM15 TRGO. Trigger edge set to rising edge (default setting). */
#define LL_ADC_REG_TRIG_EXT_TIM3_CH4          (ADC_CFGR_EXTSEL | ADC_REG_TRIG_EXT_EDGE_DEFAULT)                                            /*!< ADC group regular conversion trigger from external IP: TIM3 channel 4 event (capture compare: input capture or output capture). Trigger edge set to rising edge (default setting). */

#elif defined(STM32F302xC) || defined(STM32F302xE)
#define LL_ADC_REG_TRIG_EXT_TIM1_CH1          (ADC_REG_TRIG_EXT_EDGE_DEFAULT)                                                              /*!< ADC group regular conversion trigger from external IP: TIM1 channel 1 event (capture compare: input capture or output capture). Trigger edge set to rising edge (default setting). */
#define LL_ADC_REG_TRIG_EXT_TIM1_CH2          (ADC_CFGR_EXTSEL_0 | ADC_REG_TRIG_EXT_EDGE_DEFAULT)                                          /*!< ADC group regular conversion trigger from external IP: TIM1 channel 2 event (capture compare: input capture or output capture). Trigger edge set to rising edge (default setting). */
#define LL_ADC_REG_TRIG_EXT_TIM1_CH3          (ADC_CFGR_EXTSEL_1 | ADC_REG_TRIG_EXT_EDGE_DEFAULT)                                          /*!< ADC group regular conversion trigger from external IP: TIM1 channel 3 event (capture compare: input capture or output capture). Trigger edge set to rising edge (default setting). */
#define LL_ADC_REG_TRIG_EXT_TIM2_CH2          (ADC_CFGR_EXTSEL_1 | ADC_CFGR_EXTSEL_0 | ADC_REG_TRIG_EXT_EDGE_DEFAULT)                      /*!< ADC group regular conversion trigger from external IP: TIM2 channel 2 event (capture compare: input capture or output capture). Trigger edge set to rising edge (default setting). */
#define LL_ADC_REG_TRIG_EXT_TIM3_TRGO         (ADC_CFGR_EXTSEL_2 | ADC_REG_TRIG_EXT_EDGE_DEFAULT)                                          /*!< ADC group regular conversion trigger from external IP: TIM3 TRGO. Trigger edge set to rising edge (default setting). */
#define LL_ADC_REG_TRIG_EXT_TIM4_CH4          (ADC_CFGR_EXTSEL_2 | ADC_CFGR_EXTSEL_0 | ADC_REG_TRIG_EXT_EDGE_DEFAULT)                      /*!< ADC group regular conversion trigger from external IP: TIM4 channel 4 event (capture compare: input capture or output capture). Trigger edge set to rising edge (default setting). */
#define LL_ADC_REG_TRIG_EXT_EXTI_LINE11       (ADC_CFGR_EXTSEL_2 | ADC_CFGR_EXTSEL_1 | ADC_REG_TRIG_EXT_EDGE_DEFAULT)                      /*!< ADC group regular conversion trigger from external IP: external interrupt line 11. Trigger edge set to rising edge (default setting). */
#define LL_ADC_REG_TRIG_EXT_TIM1_TRGO         (ADC_CFGR_EXTSEL_3 | ADC_CFGR_EXTSEL_0 | ADC_REG_TRIG_EXT_EDGE_DEFAULT)                      /*!< ADC group regular conversion trigger from external IP: TIM1 TRGO. Trigger edge set to rising edge (default setting). */
#define LL_ADC_REG_TRIG_EXT_TIM1_TRGO2        (ADC_CFGR_EXTSEL_3 | ADC_CFGR_EXTSEL_1 | ADC_REG_TRIG_EXT_EDGE_DEFAULT)                      /*!< ADC group regular conversion trigger from external IP: TIM1 TRGO2. Trigger edge set to rising edge (default setting). */
#define LL_ADC_REG_TRIG_EXT_TIM2_TRGO         (ADC_CFGR_EXTSEL_3 | ADC_CFGR_EXTSEL_1 | ADC_CFGR_EXTSEL_0 | ADC_REG_TRIG_EXT_EDGE_DEFAULT)  /*!< ADC group regular conversion trigger from external IP: TIM2 TRGO. Trigger edge set to rising edge (default setting). */
#define LL_ADC_REG_TRIG_EXT_TIM4_TRGO         (ADC_CFGR_EXTSEL_3 | ADC_CFGR_EXTSEL_2 | ADC_REG_TRIG_EXT_EDGE_DEFAULT)                      /*!< ADC group regular conversion trigger from external IP: TIM4 TRGO. Trigger edge set to rising edge (default setting). */
#define LL_ADC_REG_TRIG_EXT_TIM6_TRGO         (ADC_CFGR_EXTSEL_3 | ADC_CFGR_EXTSEL_2 | ADC_CFGR_EXTSEL_0 | ADC_REG_TRIG_EXT_EDGE_DEFAULT)  /*!< ADC group regular conversion trigger from external IP: TIM6 TRGO. Trigger edge set to rising edge (default setting). */
#define LL_ADC_REG_TRIG_EXT_TIM15_TRGO        (ADC_CFGR_EXTSEL_3 | ADC_CFGR_EXTSEL_2 | ADC_CFGR_EXTSEL_1 | ADC_REG_TRIG_EXT_EDGE_DEFAULT)  /*!< ADC group regular conversion trigger from external IP: TIM15 TRGO. Trigger edge set to rising edge (default setting). */
#define LL_ADC_REG_TRIG_EXT_TIM3_CH4          (ADC_CFGR_EXTSEL | ADC_REG_TRIG_EXT_EDGE_DEFAULT)                                            /*!< ADC group regular conversion trigger from external IP: TIM3 channel 4 event (capture compare: input capture or output capture). Trigger edge set to rising edge (default setting). */

#elif defined(STM32F301x8) || defined(STM32F302x8) || defined(STM32F318xx)
#define LL_ADC_REG_TRIG_EXT_TIM1_CH1          (ADC_REG_TRIG_EXT_EDGE_DEFAULT)                                                              /*!< ADC group regular conversion trigger from external IP: TIM1 channel 1 event (capture compare: input capture or output capture). Trigger edge set to rising edge (default setting). */
#define LL_ADC_REG_TRIG_EXT_TIM1_CH2          (ADC_CFGR_EXTSEL_0 | ADC_REG_TRIG_EXT_EDGE_DEFAULT)                                          /*!< ADC group regular conversion trigger from external IP: TIM1 channel 2 event (capture compare: input capture or output capture). Trigger edge set to rising edge (default setting). */
#define LL_ADC_REG_TRIG_EXT_TIM1_CH3          (ADC_CFGR_EXTSEL_1 | ADC_REG_TRIG_EXT_EDGE_DEFAULT)                                          /*!< ADC group regular conversion trigger from external IP: TIM1 channel 3 event (capture compare: input capture or output capture). Trigger edge set to rising edge (default setting). */
#define LL_ADC_REG_TRIG_EXT_EXTI_LINE11       (ADC_CFGR_EXTSEL_2 | ADC_CFGR_EXTSEL_1 | ADC_REG_TRIG_EXT_EDGE_DEFAULT)                      /*!< ADC group regular conversion trigger from external IP: external interrupt line 11. Trigger edge set to rising edge (default setting). */
#define LL_ADC_REG_TRIG_EXT_TIM1_TRGO         (ADC_CFGR_EXTSEL_3 | ADC_CFGR_EXTSEL_0 | ADC_REG_TRIG_EXT_EDGE_DEFAULT)                      /*!< ADC group regular conversion trigger from external IP: TIM1 TRGO. Trigger edge set to rising edge (default setting). */
#define LL_ADC_REG_TRIG_EXT_TIM1_TRGO2        (ADC_CFGR_EXTSEL_3 | ADC_CFGR_EXTSEL_1 | ADC_REG_TRIG_EXT_EDGE_DEFAULT)                      /*!< ADC group regular conversion trigger from external IP: TIM1 TRGO2. Trigger edge set to rising edge (default setting). */
#define LL_ADC_REG_TRIG_EXT_TIM2_TRGO         (ADC_CFGR_EXTSEL_3 | ADC_CFGR_EXTSEL_1 | ADC_CFGR_EXTSEL_0 | ADC_REG_TRIG_EXT_EDGE_DEFAULT)  /*!< ADC group regular conversion trigger from external IP: TIM2 TRGO. Trigger edge set to rising edge (default setting). */
#define LL_ADC_REG_TRIG_EXT_TIM6_TRGO         (ADC_CFGR_EXTSEL_3 | ADC_CFGR_EXTSEL_2 | ADC_CFGR_EXTSEL_0 | ADC_REG_TRIG_EXT_EDGE_DEFAULT)  /*!< ADC group regular conversion trigger from external IP: TIM6 TRGO. Trigger edge set to rising edge (default setting). */
#define LL_ADC_REG_TRIG_EXT_TIM15_TRGO        (ADC_CFGR_EXTSEL_3 | ADC_CFGR_EXTSEL_2 | ADC_CFGR_EXTSEL_1 | ADC_REG_TRIG_EXT_EDGE_DEFAULT)  /*!< ADC group regular conversion trigger from external IP: TIM15 TRGO. Trigger edge set to rising edge (default setting). */
#endif
/**
  * @}
  */

/** @defgroup ADC_LL_EC_REG_TRIGGER_EDGE  ADC group regular - Trigger edge
  * @{
  */
#define LL_ADC_REG_TRIG_EXT_RISING         (                   ADC_CFGR_EXTEN_0)   /*!< ADC group regular conversion trigger polarity set to rising edge */
#define LL_ADC_REG_TRIG_EXT_FALLING        (ADC_CFGR_EXTEN_1                   )   /*!< ADC group regular conversion trigger polarity set to falling edge */
#define LL_ADC_REG_TRIG_EXT_RISINGFALLING  (ADC_CFGR_EXTEN_1 | ADC_CFGR_EXTEN_0)   /*!< ADC group regular conversion trigger polarity set to both rising and falling edges */
/**
  * @}
  */

/** @defgroup ADC_LL_EC_REG_CONTINUOUS_MODE  ADC group regular - Continuous mode
* @{
*/
#define LL_ADC_REG_CONV_SINGLE             ((uint32_t)0x00000000U) /*!< ADC conversions are performed in single mode: one conversion per trigger */
#define LL_ADC_REG_CONV_CONTINUOUS         (ADC_CFGR_CONT)         /*!< ADC conversions are performed in continuous mode: after the first trigger, following conversions launched successively automatically */
/**
  * @}
  */

/** @defgroup ADC_LL_EC_REG_DMA_TRANSFER  ADC group regular - DMA transfer of ADC conversion data
  * @{
  */
#define LL_ADC_REG_DMA_TRANSFER_NONE       ((uint32_t)0x00000000U)              /*!< ADC conversions are not transferred by DMA */
#define LL_ADC_REG_DMA_TRANSFER_LIMITED    (                  ADC_CFGR_DMAEN)   /*!< ADC conversion data are transferred by DMA, in limited mode (one shot mode): DMA transfer requests are stopped when number of DMA data transfers (number of ADC conversions) is reached. This ADC mode is intended to be used with DMA mode non-circular. */
#define LL_ADC_REG_DMA_TRANSFER_UNLIMITED  (ADC_CFGR_DMACFG | ADC_CFGR_DMAEN)   /*!< ADC conversion data are transferred by DMA, in unlimited mode: DMA transfer requests are unlimited, whatever number of DMA data transferred (number of ADC conversions). This ADC mode is intended to be used with DMA mode circular. */
/**
  * @}
  */

/** @defgroup ADC_LL_EC_REG_OVR_DATA_BEHAVIOR  ADC group regular - Overrun behavior on conversion data
* @{
*/
#define LL_ADC_REG_OVR_DATA_PRESERVED      ((uint32_t)0x00000000U)/*!< ADC group regular behavior in case of overrun: data preserved */
#define LL_ADC_REG_OVR_DATA_OVERWRITTEN    (ADC_CFGR_OVRMOD)      /*!< ADC group regular behavior in case of overrun: data overwritten */
/**
  * @}
  */

/** @defgroup ADC_LL_EC_REG_SEQ_SCAN_LENGTH  ADC group regular - Sequencer scan length
  * @{
  */
#define LL_ADC_REG_SEQ_SCAN_DISABLE        ((uint32_t)0x00000000U)                                     /*!< ADC group regular sequencer disable (equivalent to sequencer of 1 rank: ADC conversion on only 1 channel) */
#define LL_ADC_REG_SEQ_SCAN_ENABLE_2RANKS  (                                             ADC_SQR1_L_0) /*!< ADC group regular sequencer enable with 2 ranks in the sequence */
#define LL_ADC_REG_SEQ_SCAN_ENABLE_3RANKS  (                              ADC_SQR1_L_1               ) /*!< ADC group regular sequencer enable with 3 ranks in the sequence */
#define LL_ADC_REG_SEQ_SCAN_ENABLE_4RANKS  (                              ADC_SQR1_L_1 | ADC_SQR1_L_0) /*!< ADC group regular sequencer enable with 4 ranks in the sequence */
#define LL_ADC_REG_SEQ_SCAN_ENABLE_5RANKS  (               ADC_SQR1_L_2                              ) /*!< ADC group regular sequencer enable with 5 ranks in the sequence */
#define LL_ADC_REG_SEQ_SCAN_ENABLE_6RANKS  (               ADC_SQR1_L_2                | ADC_SQR1_L_0) /*!< ADC group regular sequencer enable with 6 ranks in the sequence */
#define LL_ADC_REG_SEQ_SCAN_ENABLE_7RANKS  (               ADC_SQR1_L_2 | ADC_SQR1_L_1               ) /*!< ADC group regular sequencer enable with 7 ranks in the sequence */
#define LL_ADC_REG_SEQ_SCAN_ENABLE_8RANKS  (               ADC_SQR1_L_2 | ADC_SQR1_L_1 | ADC_SQR1_L_0) /*!< ADC group regular sequencer enable with 8 ranks in the sequence */
#define LL_ADC_REG_SEQ_SCAN_ENABLE_9RANKS  (ADC_SQR1_L_3                                             ) /*!< ADC group regular sequencer enable with 9 ranks in the sequence */
#define LL_ADC_REG_SEQ_SCAN_ENABLE_10RANKS (ADC_SQR1_L_3                               | ADC_SQR1_L_0) /*!< ADC group regular sequencer enable with 10 ranks in the sequence */
#define LL_ADC_REG_SEQ_SCAN_ENABLE_11RANKS (ADC_SQR1_L_3                | ADC_SQR1_L_1               ) /*!< ADC group regular sequencer enable with 11 ranks in the sequence */
#define LL_ADC_REG_SEQ_SCAN_ENABLE_12RANKS (ADC_SQR1_L_3                | ADC_SQR1_L_1 | ADC_SQR1_L_0) /*!< ADC group regular sequencer enable with 12 ranks in the sequence */
#define LL_ADC_REG_SEQ_SCAN_ENABLE_13RANKS (ADC_SQR1_L_3 | ADC_SQR1_L_2                              ) /*!< ADC group regular sequencer enable with 13 ranks in the sequence */
#define LL_ADC_REG_SEQ_SCAN_ENABLE_14RANKS (ADC_SQR1_L_3 | ADC_SQR1_L_2                | ADC_SQR1_L_0) /*!< ADC group regular sequencer enable with 14 ranks in the sequence */
#define LL_ADC_REG_SEQ_SCAN_ENABLE_15RANKS (ADC_SQR1_L_3 | ADC_SQR1_L_2 | ADC_SQR1_L_1               ) /*!< ADC group regular sequencer enable with 15 ranks in the sequence */
#define LL_ADC_REG_SEQ_SCAN_ENABLE_16RANKS (ADC_SQR1_L_3 | ADC_SQR1_L_2 | ADC_SQR1_L_1 | ADC_SQR1_L_0) /*!< ADC group regular sequencer enable with 16 ranks in the sequence */
/**
  * @}
  */

/** @defgroup ADC_LL_EC_REG_SEQ_DISCONT_MODE  ADC group regular - Sequencer discontinuous mode
  * @{
  */
#define LL_ADC_REG_SEQ_DISCONT_DISABLE     ((uint32_t)0x00000000U)                                                          /*!< ADC group regular sequencer discontinuous mode disable */
#define LL_ADC_REG_SEQ_DISCONT_1RANK       (                                                               ADC_CFGR_DISCEN) /*!< ADC group regular sequencer discontinuous mode enable with sequence interruption every rank */
#define LL_ADC_REG_SEQ_DISCONT_2RANKS      (                                          ADC_CFGR_DISCNUM_0 | ADC_CFGR_DISCEN) /*!< ADC group regular sequencer discontinuous mode enabled with sequence interruption every 2 ranks */
#define LL_ADC_REG_SEQ_DISCONT_3RANKS      (                     ADC_CFGR_DISCNUM_1                      | ADC_CFGR_DISCEN) /*!< ADC group regular sequencer discontinuous mode enable with sequence interruption every 3 ranks */
#define LL_ADC_REG_SEQ_DISCONT_4RANKS      (                     ADC_CFGR_DISCNUM_1 | ADC_CFGR_DISCNUM_0 | ADC_CFGR_DISCEN) /*!< ADC group regular sequencer discontinuous mode enable with sequence interruption every 4 ranks */
#define LL_ADC_REG_SEQ_DISCONT_5RANKS      (ADC_CFGR_DISCNUM_2                                           | ADC_CFGR_DISCEN) /*!< ADC group regular sequencer discontinuous mode enable with sequence interruption every 5 ranks */
#define LL_ADC_REG_SEQ_DISCONT_6RANKS      (ADC_CFGR_DISCNUM_2                      | ADC_CFGR_DISCNUM_0 | ADC_CFGR_DISCEN) /*!< ADC group regular sequencer discontinuous mode enable with sequence interruption every 6 ranks */
#define LL_ADC_REG_SEQ_DISCONT_7RANKS      (ADC_CFGR_DISCNUM_2 | ADC_CFGR_DISCNUM_1                      | ADC_CFGR_DISCEN) /*!< ADC group regular sequencer discontinuous mode enable with sequence interruption every 7 ranks */
#define LL_ADC_REG_SEQ_DISCONT_8RANKS      (ADC_CFGR_DISCNUM_2 | ADC_CFGR_DISCNUM_1 | ADC_CFGR_DISCNUM_0 | ADC_CFGR_DISCEN) /*!< ADC group regular sequencer discontinuous mode enable with sequence interruption every 8 ranks */
/**
  * @}
  */

/** @defgroup ADC_LL_EC_REG_SEQ_RANKS  ADC group regular - Sequencer ranks
  * @{
  */
#define LL_ADC_REG_RANK_1                  (ADC_SQR1_REGOFFSET | ADC_REG_RANK_1_SQRX_BITOFFSET_POS)  /*!< ADC group regular sequencer rank 1 */
#define LL_ADC_REG_RANK_2                  (ADC_SQR1_REGOFFSET | ADC_REG_RANK_2_SQRX_BITOFFSET_POS)  /*!< ADC group regular sequencer rank 2 */
#define LL_ADC_REG_RANK_3                  (ADC_SQR1_REGOFFSET | ADC_REG_RANK_3_SQRX_BITOFFSET_POS)  /*!< ADC group regular sequencer rank 3 */
#define LL_ADC_REG_RANK_4                  (ADC_SQR1_REGOFFSET | ADC_REG_RANK_4_SQRX_BITOFFSET_POS)  /*!< ADC group regular sequencer rank 4 */
#define LL_ADC_REG_RANK_5                  (ADC_SQR2_REGOFFSET | ADC_REG_RANK_5_SQRX_BITOFFSET_POS)  /*!< ADC group regular sequencer rank 5 */
#define LL_ADC_REG_RANK_6                  (ADC_SQR2_REGOFFSET | ADC_REG_RANK_6_SQRX_BITOFFSET_POS)  /*!< ADC group regular sequencer rank 6 */
#define LL_ADC_REG_RANK_7                  (ADC_SQR2_REGOFFSET | ADC_REG_RANK_7_SQRX_BITOFFSET_POS)  /*!< ADC group regular sequencer rank 7 */
#define LL_ADC_REG_RANK_8                  (ADC_SQR2_REGOFFSET | ADC_REG_RANK_8_SQRX_BITOFFSET_POS)  /*!< ADC group regular sequencer rank 8 */
#define LL_ADC_REG_RANK_9                  (ADC_SQR2_REGOFFSET | ADC_REG_RANK_9_SQRX_BITOFFSET_POS)  /*!< ADC group regular sequencer rank 9 */
#define LL_ADC_REG_RANK_10                 (ADC_SQR3_REGOFFSET | ADC_REG_RANK_10_SQRX_BITOFFSET_POS) /*!< ADC group regular sequencer rank 10 */
#define LL_ADC_REG_RANK_11                 (ADC_SQR3_REGOFFSET | ADC_REG_RANK_11_SQRX_BITOFFSET_POS) /*!< ADC group regular sequencer rank 11 */
#define LL_ADC_REG_RANK_12                 (ADC_SQR3_REGOFFSET | ADC_REG_RANK_12_SQRX_BITOFFSET_POS) /*!< ADC group regular sequencer rank 12 */
#define LL_ADC_REG_RANK_13                 (ADC_SQR3_REGOFFSET | ADC_REG_RANK_13_SQRX_BITOFFSET_POS) /*!< ADC group regular sequencer rank 13 */
#define LL_ADC_REG_RANK_14                 (ADC_SQR3_REGOFFSET | ADC_REG_RANK_14_SQRX_BITOFFSET_POS) /*!< ADC group regular sequencer rank 14 */
#define LL_ADC_REG_RANK_15                 (ADC_SQR4_REGOFFSET | ADC_REG_RANK_15_SQRX_BITOFFSET_POS) /*!< ADC group regular sequencer rank 15 */
#define LL_ADC_REG_RANK_16                 (ADC_SQR4_REGOFFSET | ADC_REG_RANK_16_SQRX_BITOFFSET_POS) /*!< ADC group regular sequencer rank 16 */
/**
  * @}
  */

/** @defgroup ADC_LL_EC_INJ_TRIGGER_SOURCE  ADC group injected - Trigger source
  * @{
  */
#define LL_ADC_INJ_TRIG_SOFTWARE              ((uint32_t)0x00000000U)                                                                        /*!< ADC group injected conversion trigger internal: SW start.. Trigger edge set to rising edge (default setting). */
#if defined(STM32F303xC) || defined(STM32F358xx) || defined(STM32F303xE) || defined(STM32F398xx)
/* ADC group injected external triggers for ADC instances: ADC1, ADC2 (for    */
/* ADC instances ADCx available on the selected device)                       */
/* Note: Literal without suffix "ADCxy" means that external trigger           */
/*       is available on all ADC instances.                                   */
/* Note: For devices STM32F303xE, STM32F398xx: some triggers require to set   */
/*       register SYSCFG_CFGR4. Refer to reference manual.                    */
#define LL_ADC_INJ_TRIG_EXT_TIM1_TRGO         (ADC_INJ_TRIG_EXT_EDGE_DEFAULT)                                                                /*!< ADC group injected conversion trigger from external IP: TIM1 TRG0. Trigger edge set to rising edge (default setting). */
#define LL_ADC_INJ_TRIG_EXT_TIM1_CH4          (ADC_JSQR_JEXTSEL_0 | ADC_INJ_TRIG_EXT_EDGE_DEFAULT)                                           /*!< ADC group injected conversion trigger from external IP: TIM1 channel 4 event (capture compare: input capture or output capture). Trigger edge set to rising edge (default setting). */
#define LL_ADC_INJ_TRIG_EXT_TIM2_TRGO_ADC12   (ADC_JSQR_JEXTSEL_1 | ADC_INJ_TRIG_EXT_EDGE_DEFAULT)                                           /*!< ADC group injected conversion trigger from external IP: TIM2 TRG0. Trigger edge set to rising edge (default setting). */
#define LL_ADC_INJ_TRIG_EXT_TIM2_CH1_ADC12    (ADC_JSQR_JEXTSEL_1 | ADC_JSQR_JEXTSEL_0 | ADC_INJ_TRIG_EXT_EDGE_DEFAULT)                      /*!< ADC group injected conversion trigger from external IP: TIM2 channel 1 event (capture compare: input capture or output capture). Trigger edge set to rising edge (default setting). */
#define LL_ADC_INJ_TRIG_EXT_TIM3_CH4_ADC12    (ADC_JSQR_JEXTSEL_2 | ADC_INJ_TRIG_EXT_EDGE_DEFAULT)                                           /*!< ADC group injected conversion trigger from external IP: TIM3 channel 4 event (capture compare: input capture or output capture). Trigger edge set to rising edge (default setting). */
#define LL_ADC_INJ_TRIG_EXT_TIM4_TRGO_ADC12   (ADC_JSQR_JEXTSEL_2 | ADC_JSQR_JEXTSEL_0 | ADC_INJ_TRIG_EXT_EDGE_DEFAULT)                      /*!< ADC group injected conversion trigger from external IP: TIM4 TRG0. Trigger edge set to rising edge (default setting). */
#define LL_ADC_INJ_TRIG_EXT_EXTI_LINE15_ADC12 (ADC_JSQR_JEXTSEL_2 | ADC_JSQR_JEXTSEL_1 | ADC_INJ_TRIG_EXT_EDGE_DEFAULT)                      /*!< ADC group injected conversion trigger from external IP: external interrupt line 15. Trigger edge set to rising edge (default setting). */
#define LL_ADC_INJ_TRIG_EXT_TIM8_CH4_ADC12    (ADC_JSQR_JEXTSEL_2 | ADC_JSQR_JEXTSEL_1 | ADC_JSQR_JEXTSEL_0 | ADC_INJ_TRIG_EXT_EDGE_DEFAULT) /*!< ADC group injected conversion trigger from external IP: TIM8 channel 4 event (capture compare: input capture or output capture). Trigger edge set to rising edge (default setting). */
#define LL_ADC_INJ_TRIG_EXT_TIM1_TRGO2        (ADC_JSQR_JEXTSEL_3 | ADC_INJ_TRIG_EXT_EDGE_DEFAULT)                                           /*!< ADC group injected conversion trigger from external IP: TIM1 TRG02. Trigger edge set to rising edge (default setting). */
#define LL_ADC_INJ_TRIG_EXT_TIM8_TRGO         (ADC_JSQR_JEXTSEL_3 | ADC_JSQR_JEXTSEL_0 | ADC_INJ_TRIG_EXT_EDGE_DEFAULT)                      /*!< ADC group injected conversion trigger from external IP: TIM8 TRG0. Trigger edge set to rising edge (default setting). */
#define LL_ADC_INJ_TRIG_EXT_TIM8_TRGO2        (ADC_JSQR_JEXTSEL_3 | ADC_JSQR_JEXTSEL_1 | ADC_INJ_TRIG_EXT_EDGE_DEFAULT)                      /*!< ADC group injected conversion trigger from external IP: TIM8 TRG02. Trigger edge set to rising edge (default setting). */
#define LL_ADC_INJ_TRIG_EXT_TIM3_CH3_ADC12    (ADC_JSQR_JEXTSEL_3 | ADC_JSQR_JEXTSEL_1 | ADC_JSQR_JEXTSEL_0 | ADC_INJ_TRIG_EXT_EDGE_DEFAULT) /*!< ADC group injected conversion trigger from external IP: TIM3 channel 3 event (capture compare: input capture or output capture). Trigger edge set to rising edge (default setting). */
#define LL_ADC_INJ_TRIG_EXT_TIM3_TRGO         (ADC_JSQR_JEXTSEL_3 | ADC_JSQR_JEXTSEL_2 | ADC_INJ_TRIG_EXT_EDGE_DEFAULT)                      /*!< ADC group injected conversion trigger from external IP: TIM3 TRG0. Trigger edge set to rising edge (default setting). */
#define LL_ADC_INJ_TRIG_EXT_TIM3_CH1_ADC12    (ADC_JSQR_JEXTSEL_3 | ADC_JSQR_JEXTSEL_2 | ADC_JSQR_JEXTSEL_0 | ADC_INJ_TRIG_EXT_EDGE_DEFAULT) /*!< ADC group injected conversion trigger from external IP: TIM3 channel 1 event (capture compare: input capture or output capture). Trigger edge set to rising edge (default setting). */
#define LL_ADC_INJ_TRIG_EXT_TIM6_TRGO_ADC12   (ADC_JSQR_JEXTSEL_3 | ADC_JSQR_JEXTSEL_2 | ADC_JSQR_JEXTSEL_1 | ADC_INJ_TRIG_EXT_EDGE_DEFAULT) /*!< ADC group injected conversion trigger from external IP: TIM6 TRG0. Trigger edge set to rising edge (default setting). */
#define LL_ADC_INJ_TRIG_EXT_TIM15_TRGO        (ADC_JSQR_JEXTSEL | ADC_INJ_TRIG_EXT_EDGE_DEFAULT)                                             /*!< ADC group injected conversion trigger from external IP: TIM15 TRG0. Trigger edge set to rising edge (default setting). */
#if defined(STM32F303xE) || defined(STM32F398xx)
#define LL_ADC_INJ_TRIG_EXT_TIM20_TRGO_ADC12  (LL_ADC_INJ_TRIG_EXT_TIM2_CH1_ADC12)                                                           /*!< ADC group injected conversion trigger from external IP: TIM20 TRG0. Trigger edge set to rising edge (default setting). */
#define LL_ADC_INJ_TRIG_EXT_TIM20_TRGO2_ADC12 (LL_ADC_INJ_TRIG_EXT_EXTI_LINE15_ADC12)                                                        /*!< ADC group injected conversion trigger from external IP: TIM20 TRG02. Trigger edge set to rising edge (default setting). */
#define LL_ADC_INJ_TRIG_EXT_TIM20_CH4_ADC12   (LL_ADC_INJ_TRIG_EXT_TIM2_CH1_ADC12)                                                           /*!< ADC group injected conversion trigger from external IP: TIM20 channel 4 event (capture compare: input capture or output capture). Trigger edge set to rising edge (default setting). */
#endif /* STM32F303xE || STM32F398xx */

/* ADC group injected external triggers for ADC instances: ADC3, ADC4 (for    */
/* ADC instances ADCx available on the selected device)                       */
/* Note: Literal without suffix "ADCxy" means that external trigger           */
/*       is available on all ADC instances.                                   */
/* Note: External triggers JEXT2 and JEXT5 are the same (TIM4_CH3 event).     */
/*       JEXT2 is the main trigger, JEXT5 is kept as spare trigger for        */
/*       future devices.                                                      */
/* Note: For devices STM32F303xE, STM32F398xx: some triggers require to set   */
/*       register SYSCFG_CFGR4. Refer to reference manual.                    */
#define LL_ADC_INJ_TRIG_EXT_TIM1_TRGO         (ADC_INJ_TRIG_EXT_EDGE_DEFAULT)                                                                /*!< ADC group injected conversion trigger from external IP: TIM1 TRG0. Trigger edge set to rising edge (default setting). */
#define LL_ADC_INJ_TRIG_EXT_TIM1_CH4          (ADC_JSQR_JEXTSEL_0 | ADC_INJ_TRIG_EXT_EDGE_DEFAULT)                                           /*!< ADC group injected conversion trigger from external IP: TIM1 channel 4 event (capture compare: input capture or output capture). Trigger edge set to rising edge (default setting). */
#define LL_ADC_INJ_TRIG_EXT_TIM4_CH3_ADC34    (ADC_JSQR_JEXTSEL_1 | ADC_INJ_TRIG_EXT_EDGE_DEFAULT)                                           /*!< ADC group injected conversion trigger from external IP: TIM4 channel 3 event (capture compare: input capture or output capture). Trigger edge set to rising edge (default setting). */
#define LL_ADC_INJ_TRIG_EXT_TIM8_CH2_ADC34    (ADC_JSQR_JEXTSEL_1 | ADC_JSQR_JEXTSEL_0 | ADC_INJ_TRIG_EXT_EDGE_DEFAULT)                      /*!< ADC group injected conversion trigger from external IP: TIM8 channel 2 event (capture compare: input capture or output capture). Trigger edge set to rising edge (default setting). */
#define LL_ADC_INJ_TRIG_EXT_TIM8_CH4__ADC34   (ADC_JSQR_JEXTSEL_2 | ADC_INJ_TRIG_EXT_EDGE_DEFAULT)                                           /*!< ADC group injected conversion trigger from external IP: TIM8 channel 4 event (capture compare: input capture or output capture). Trigger edge set to rising edge (default setting). */
#define LL_ADC_INJ_TRIG_EXT_TIM4_CH4_ADC34    (ADC_JSQR_JEXTSEL_2 | ADC_JSQR_JEXTSEL_1 | ADC_INJ_TRIG_EXT_EDGE_DEFAULT)                      /*!< ADC group injected conversion trigger from external IP: TIM4 channel 4 event (capture compare: input capture or output capture). Trigger edge set to rising edge (default setting). */
#define LL_ADC_INJ_TRIG_EXT_TIM4_TRGO__ADC34  (ADC_JSQR_JEXTSEL_2 | ADC_JSQR_JEXTSEL_1 | ADC_JSQR_JEXTSEL_0 | ADC_INJ_TRIG_EXT_EDGE_DEFAULT) /*!< ADC group injected conversion trigger from external IP: TIM4 TRG0. Trigger edge set to rising edge (default setting). */
#define LL_ADC_INJ_TRIG_EXT_TIM1_TRGO2        (ADC_JSQR_JEXTSEL_3 | ADC_INJ_TRIG_EXT_EDGE_DEFAULT)                                           /*!< ADC group injected conversion trigger from external IP: TIM1 TRG02. Trigger edge set to rising edge (default setting). */
#define LL_ADC_INJ_TRIG_EXT_TIM8_TRGO         (ADC_JSQR_JEXTSEL_3 | ADC_JSQR_JEXTSEL_0 | ADC_INJ_TRIG_EXT_EDGE_DEFAULT)                      /*!< ADC group injected conversion trigger from external IP: TIM8 TRG0. Trigger edge set to rising edge (default setting). */
#define LL_ADC_INJ_TRIG_EXT_TIM8_TRGO2        (ADC_JSQR_JEXTSEL_3 | ADC_JSQR_JEXTSEL_1 | ADC_INJ_TRIG_EXT_EDGE_DEFAULT)                      /*!< ADC group injected conversion trigger from external IP: TIM8 TRG02. Trigger edge set to rising edge (default setting). */
#define LL_ADC_INJ_TRIG_EXT_TIM1_CH3_ADC34    (ADC_JSQR_JEXTSEL_3 | ADC_JSQR_JEXTSEL_1 | ADC_JSQR_JEXTSEL_0 | ADC_INJ_TRIG_EXT_EDGE_DEFAULT) /*!< ADC group injected conversion trigger from external IP: TIM1 channel 3 event (capture compare: input capture or output capture). Trigger edge set to rising edge (default setting). */
#define LL_ADC_INJ_TRIG_EXT_TIM3_TRGO         (ADC_JSQR_JEXTSEL_3 | ADC_JSQR_JEXTSEL_2 | ADC_INJ_TRIG_EXT_EDGE_DEFAULT)                      /*!< ADC group injected conversion trigger from external IP: TIM3 TRG0. Trigger edge set to rising edge (default setting). */
#define LL_ADC_INJ_TRIG_EXT_TIM2_TRGO__ADC34  (ADC_JSQR_JEXTSEL_3 | ADC_JSQR_JEXTSEL_2 | ADC_JSQR_JEXTSEL_0 | ADC_INJ_TRIG_EXT_EDGE_DEFAULT) /*!< ADC group injected conversion trigger from external IP: TIM2 TRG0. Trigger edge set to rising edge (default setting). */
#define LL_ADC_INJ_TRIG_EXT_TIM7_TRGO_ADC34   (ADC_JSQR_JEXTSEL_3 | ADC_JSQR_JEXTSEL_2 | ADC_JSQR_JEXTSEL_1 | ADC_INJ_TRIG_EXT_EDGE_DEFAULT) /*!< ADC group injected conversion trigger from external IP: TIM7 TRG0. Trigger edge set to rising edge (default setting). */
#define LL_ADC_INJ_TRIG_EXT_TIM15_TRGO        (ADC_JSQR_JEXTSEL | ADC_INJ_TRIG_EXT_EDGE_DEFAULT)                                             /*!< ADC group injected conversion trigger from external IP: TIM15 TRG0. Trigger edge set to rising edge (default setting). */
#if defined(STM32F303xE) || defined(STM32F398xx)
#define LL_ADC_INJ_TRIG_EXT_TIM20_TRG_ADC34   (ADC_JSQR_JEXTSEL_2 | ADC_JSQR_JEXTSEL_0 | ADC_INJ_TRIG_EXT_EDGE_DEFAULT)                      /*!< ADC group injected conversion trigger from external IP: TIM20 TRG0. Trigger edge set to rising edge (default setting). */
#define LL_ADC_INJ_TRIG_EXT_TIM20_TRG2_ADC34  (LL_ADC_INJ_TRIG_EXT_TIM1_CH3_ADC34)                                                           /*!< ADC group injected conversion trigger from external IP: TIM20 TRG02. Trigger edge set to rising edge (default setting). */
#define LL_ADC_INJ_TRIG_EXT_TIM20_CH2         (LL_ADC_INJ_TRIG_EXT_TIM15_TRGO)                                                               /*!< ADC group injected conversion trigger from external IP: TIM20 channel 2 event (capture compare: input capture or output capture). Trigger edge set to rising edge (default setting). */
#endif /* STM32F303xE || STM32F398xx */

#elif defined(STM32F303x8) || defined(STM32F328xx)
#define LL_ADC_INJ_TRIG_EXT_TIM1_TRGO         (ADC_INJ_TRIG_EXT_EDGE_DEFAULT)                                                                /*!< ADC group injected conversion trigger from external IP: TIM1 TRG0. Trigger edge set to rising edge (default setting). */
#define LL_ADC_INJ_TRIG_EXT_TIM1_CH4          (ADC_JSQR_JEXTSEL_0 | ADC_INJ_TRIG_EXT_EDGE_DEFAULT)                                           /*!< ADC group injected conversion trigger from external IP: TIM1 channel 4 event (capture compare: input capture or output capture). Trigger edge set to rising edge (default setting). */
#define LL_ADC_INJ_TRIG_EXT_TIM2_TRGO         (ADC_JSQR_JEXTSEL_1 | ADC_INJ_TRIG_EXT_EDGE_DEFAULT)                                           /*!< ADC group injected conversion trigger from external IP: TIM2 TRG0. Trigger edge set to rising edge (default setting). */
#define LL_ADC_INJ_TRIG_EXT_TIM2_CH1          (ADC_JSQR_JEXTSEL_1 | ADC_JSQR_JEXTSEL_0 | ADC_INJ_TRIG_EXT_EDGE_DEFAULT)                      /*!< ADC group injected conversion trigger from external IP: TIM2 channel 1 event (capture compare: input capture or output capture). Trigger edge set to rising edge (default setting). */
#define LL_ADC_INJ_TRIG_EXT_TIM3_CH4          (ADC_JSQR_JEXTSEL_2 | ADC_INJ_TRIG_EXT_EDGE_DEFAULT)                                           /*!< ADC group injected conversion trigger from external IP: TIM3 channel 4 event (capture compare: input capture or output capture). Trigger edge set to rising edge (default setting). */
#define LL_ADC_INJ_TRIG_EXT_TIM4_TRGO         (ADC_JSQR_JEXTSEL_2 | ADC_JSQR_JEXTSEL_0 | ADC_INJ_TRIG_EXT_EDGE_DEFAULT)                      /*!< ADC group injected conversion trigger from external IP: TIM4 TRG0. Trigger edge set to rising edge (default setting). */
#define LL_ADC_INJ_TRIG_EXT_EXTI_LINE15       (ADC_JSQR_JEXTSEL_2 | ADC_JSQR_JEXTSEL_1 | ADC_INJ_TRIG_EXT_EDGE_DEFAULT)                      /*!< ADC group injected conversion trigger from external IP: external interrupt line 15. Trigger edge set to rising edge (default setting). */
#define LL_ADC_INJ_TRIG_EXT_TIM8_CH4          (ADC_JSQR_JEXTSEL_2 | ADC_JSQR_JEXTSEL_1 | ADC_JSQR_JEXTSEL_0 | ADC_INJ_TRIG_EXT_EDGE_DEFAULT) /*!< ADC group injected conversion trigger from external IP: TIM8 channel 4 event (capture compare: input capture or output capture). Trigger edge set to rising edge (default setting). */
#define LL_ADC_INJ_TRIG_EXT_TIM1_TRGO2        (ADC_JSQR_JEXTSEL_3 | ADC_INJ_TRIG_EXT_EDGE_DEFAULT)                                           /*!< ADC group injected conversion trigger from external IP: TIM1 TRG02. Trigger edge set to rising edge (default setting). */
#define LL_ADC_INJ_TRIG_EXT_TIM8_TRGO         (ADC_JSQR_JEXTSEL_3 | ADC_JSQR_JEXTSEL_0 | ADC_INJ_TRIG_EXT_EDGE_DEFAULT)                      /*!< ADC group injected conversion trigger from external IP: TIM8 TRG0. Trigger edge set to rising edge (default setting). */
#define LL_ADC_INJ_TRIG_EXT_TIM8_TRGO2        (ADC_JSQR_JEXTSEL_3 | ADC_JSQR_JEXTSEL_1 | ADC_INJ_TRIG_EXT_EDGE_DEFAULT)                      /*!< ADC group injected conversion trigger from external IP: TIM8 TRG02. Trigger edge set to rising edge (default setting). */
#define LL_ADC_INJ_TRIG_EXT_TIM3_CH3          (ADC_JSQR_JEXTSEL_3 | ADC_JSQR_JEXTSEL_1 | ADC_JSQR_JEXTSEL_0 | ADC_INJ_TRIG_EXT_EDGE_DEFAULT) /*!< ADC group injected conversion trigger from external IP: TIM3 channel 3 event (capture compare: input capture or output capture). Trigger edge set to rising edge (default setting). */
#define LL_ADC_INJ_TRIG_EXT_TIM3_TRGO         (ADC_JSQR_JEXTSEL_3 | ADC_JSQR_JEXTSEL_2 | ADC_INJ_TRIG_EXT_EDGE_DEFAULT)                      /*!< ADC group injected conversion trigger from external IP: TIM3 TRG0. Trigger edge set to rising edge (default setting). */
#define LL_ADC_INJ_TRIG_EXT_TIM3_CH1          (ADC_JSQR_JEXTSEL_3 | ADC_JSQR_JEXTSEL_2 | ADC_JSQR_JEXTSEL_0 | ADC_INJ_TRIG_EXT_EDGE_DEFAULT) /*!< ADC group injected conversion trigger from external IP: TIM3 channel 1 event (capture compare: input capture or output capture). Trigger edge set to rising edge (default setting). */
#define LL_ADC_INJ_TRIG_EXT_TIM6_TRGO         (ADC_JSQR_JEXTSEL_3 | ADC_JSQR_JEXTSEL_2 | ADC_JSQR_JEXTSEL_1 | ADC_INJ_TRIG_EXT_EDGE_DEFAULT) /*!< ADC group injected conversion trigger from external IP: TIM6 TRG0. Trigger edge set to rising edge (default setting). */
#define LL_ADC_INJ_TRIG_EXT_TIM15_TRGO        (ADC_JSQR_JEXTSEL | ADC_INJ_TRIG_EXT_EDGE_DEFAULT)                                             /*!< ADC group injected conversion trigger from external IP: TIM15 TRG0. Trigger edge set to rising edge (default setting). */
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
