vkottler/senior-design/src/driver/gpio.c

#include "gpio.h"

static int verify_gpio_mode(GPIO_MODE mode) {
	if ((uint32_t) mode > 3) return -1;
	return 0;
}

static int verify_gpio_speed(GPIO_SPEED speed) {
	if ((uint32_t) speed > 3) return -1;
	return 0;
}

static int verify_gpio_pullup(GPIO_PULLUP_STATE state) {
	if ((uint32_t) state > 2) return -1;
	return 0;
}

static int verify_gpio_port(GPIO_TypeDef* port) {
	if (IS_GPIO_ALL_INSTANCE(port)) return 0;
	return -1;
}

int gpio_setClock(GPIO_TypeDef* port, bool state) {

	volatile uint32_t *to_set;

	to_set = &RCC->AHBENR;

	uint8_t bit_num = 0;
	switch ((uint32_t) port) {
		case GPIOA_BASE: bit_num = RCC_AHBENR_GPIOAEN_Pos; break;
		case GPIOB_BASE: bit_num = RCC_AHBENR_GPIOBEN_Pos; break;
		case GPIOC_BASE: bit_num = RCC_AHBENR_GPIOCEN_Pos; break;
		case GPIOD_BASE: bit_num = RCC_AHBENR_GPIODEN_Pos; break;
		case GPIOE_BASE: bit_num = RCC_AHBENR_GPIOEEN_Pos; break;
		case GPIOF_BASE: bit_num = RCC_AHBENR_GPIOFEN_Pos; break;
		case GPIOG_BASE: bit_num = RCC_AHBENR_GPIOGEN_Pos; break;
		case GPIOH_BASE: bit_num = RCC_AHBENR_GPIOHEN_Pos; break;
		default: return -1;
	}
	
	*to_set &= ~(0x1 << bit_num);
	while (*to_set & (0x1 << bit_num)) {;}
		
	if (state)
		*to_set |= 0x1 << bit_num;
	
	return 0;
}

int gpio_setMode(GPIO_TypeDef* port, uint8_t pin, GPIO_MODE mode) {
	if (verify_gpio_port(port) || verify_gpio_mode(mode)
		|| pin > 15) return -1;
	
	port->MODER &= ~(0x3 << (pin*2));	/* clear mode	*/
	port->MODER |= mode << (pin*2);		/* set mode		*/
	return 0;
}

int gpio_openDrainState(GPIO_TypeDef* port, uint8_t pin, bool state) {
	
	if (verify_gpio_port(port) || pin > 15) return -1;
	
	port->OTYPER &= ~(0x1 << pin);			/* clear output-type state	*/
	if (state) port->OTYPER |= 0x1 << pin;	/* set open drain			*/
	return 0;
}

int gpio_setSpeed(GPIO_TypeDef* port, uint8_t pin, GPIO_SPEED speed) {
	
	if (verify_gpio_port(port) || pin > 15 ||
		verify_gpio_speed(speed)) return -1;
	
	port->OSPEEDR &= ~(0x3 << (pin*2));
	port->OSPEEDR |= speed << (pin*2);
	return 0;
}

int gpio_setPullupState(GPIO_TypeDef* port, uint8_t pin, GPIO_PULLUP_STATE state) {
	
	if (verify_gpio_port(port) || pin > 15 ||
		verify_gpio_pullup(state)) return -1;
	
	port->PUPDR &= ~(0x3 << (pin*2));
	port->PUPDR |= state << (pin*2);
	return 0;
}

inline void gpio_setPin(GPIO_TypeDef* port, uint8_t pin) {
	port->BSRR |= 0x1 << pin;
}

inline void gpio_resetPin(GPIO_TypeDef* port, uint8_t pin) {
	port->BSRR |= 0x1 << (pin + 16);
}

int gpio_writePin(GPIO_TypeDef* port, uint8_t pin, bool state) {
	
	if (verify_gpio_port(port) || pin > 15) return -1;
	state ? gpio_setPin(port, pin) :
			gpio_resetPin(port, pin);
	return 0;
}

int gpio_setAlternateFunc(GPIO_TypeDef* port, uint8_t pin, uint8_t val) {
	
	if (verify_gpio_port(port) || pin > 15 ||
		val > 15) return -1;
	
	port->AFR[pin / 8] &= ~(0xF << ((pin % 8) * 4));
	port->AFR[pin / 8] |= val << ((pin % 8) * 4);
	return 0;
}

/* Getters */

int gpio_readPin(GPIO_TypeDef* port, uint8_t pin) {

	if (verify_gpio_port(port) || pin > 15) return -1;
	return port->IDR >> pin & 0x1 ;
}

GPIO_MODE gpio_getMode(GPIO_TypeDef* port, uint8_t pin) {
    return port->MODER >> (pin * 2) & 0x3;
}

GPIO_SPEED gpio_getSpeed(GPIO_TypeDef* port, uint8_t pin) {
    return port->OSPEEDR >> (pin * 2) & 0x3;
}

GPIO_PULLUP_STATE gpio_getPullupState(GPIO_TypeDef* port, uint8_t pin) {
    return port->PUPDR >> (pin * 2)& 0x3;
}

int gpio_getAlternateFunc(GPIO_TypeDef* port, uint8_t pin) {
    return 	port->AFR[pin / 8] >> ((pin % 8) * 4) & 0xF;
}

void gpio_getPinInfo(GPIO_TypeDef* port, uint8_t pin, GPIO * gpio) {
	gpio->pin = pin;
	gpio->state = gpio_readPin(port, pin);
	gpio->mode = gpio_getMode(port, pin);
	gpio->speed = gpio_getSpeed(port, pin);
	gpio->pullup = gpio_getPullupState(port, pin);
}

GPIO_TypeDef *gpio_getGpioPort(char portChar){
    uint32_t port = (uint32_t) GPIOA;
    portChar -= 'A';
    port += 0x400 * portChar;
    return (GPIO_TypeDef *) port;
}

char gpio_getGpioPortChar(GPIO_TypeDef *port) {
    char portChar = 'A';
    portChar = ((uint32_t) port - (uint32_t) GPIOA) / 0x400 + 'A'; 
    return portChar;
}
