vkottler/senior-design/src/common/cli.c

#include "stm32f303xe.h"
#include <stdio.h>
#include <string.h>
#include <stdlib.h>
#include <stdbool.h>
#include "pcbuffer.h"
#include "cli.h"
#include "accel.h"
#include "esc.h"
#include "timer.h"

char buffer[BUFSIZ];
/* how to print a backspace to the console */
char backspace[3] = {0x08, ' ', 0x08};

void process_input(char *buffer) {
    printf("%s\r\n", buffer);
    if(strcmp(buffer, "accel") == 0)
    {
        printf("ACCEL\r\n");
/*        printf("x: %d\r\n", accel_read_x());*/
/*        printf("y: %d\r\n", accel_read_y());*/
/*        printf("z: %d\r\n", accel_read_z());*/
    }
    else if(buffer[0] == 'p' && buffer[1] == 'w' && buffer[2] == 'm')
    {
        uint32_t pulse = atoi(&buffer[4]);
        esc_set_pulse(ESC_TABLE[0], pulse);
        esc_set_pulse(ESC_TABLE[1], pulse);
        esc_set_pulse(ESC_TABLE[2], pulse);
        esc_set_pulse(ESC_TABLE[3], pulse);
    }
    else if(strcmp(buffer, "throughput") == 0)
    {
        uint32_t prev_ticks = ticks;
        uint32_t cnt = 0;

        while(prev_ticks + 5000 < ticks)
        {
            printf("%lx", cnt);
            cnt ++;
        }
    }
    else if(strcmp(buffer, "packetloss") == 0)
    {
        uint32_t cnt = 0;

        for(cnt = 0; cnt < 1000; cnt ++)
        {
            printf("%lx", cnt);
        }
    }
}

inline void printPrompt(void) {
    printf("=> ");
    fflush(stdout);
}

void check_input(void) {
    if (pc_buffer_messageAvailable(rx_buf[2])) {
        pc_buffer_getMessage(rx_buf[2], buffer, 128);
        if (buffer[0] != '\0') {
            process_input(buffer);
        }
        printPrompt();
    }
}
