vkottler/senior-design/src/include/usart.h

#ifndef _USART__H__
#define _USART__H__

#include <stdio.h>
#include <stdbool.h>
#include "stm32f303xe.h"
#include "pcbuffer.h"

#define USART_BUF		128
#define LIDAR_BUF	    9	
#define USART_INT_PRIO	4

#define USB_UART	USART3

typedef enum {
	APBX =		0,
	SYSCLK =	1,
	HSI_SRC =	2,
	LSE_SRC =	3
} usart_clk_src_t;

int usart_config(
	USART_TypeDef* usart, usart_clk_src_t src, uint32_t control[3],
	uint32_t baud, bool ie
);

int _getc(USART_TypeDef* usart, bool block, char *c);
int _putc(USART_TypeDef* usart, bool block, char data);
PC_Buffer *get_tx(USART_TypeDef* usart);
PC_Buffer *get_rx(USART_TypeDef* usart);

extern PC_Buffer *tx_buf[3], *rx_buf[3];

#endif
