vkottler/senior-design/(commit log)

2018-06-05 initial commit, add some directory structure and notes
    [BOM.ods]
2018-06-05 Add to readme and add an installation script for KiCad
2018-08-05 some wireframing
2018-08-12 Getting started with a KiCad base.
    [main.sch]
2018-08-12 Add some KiCad structure and a script to easily open projects.
    [battery_rio.kicad_pcb, battery_rio.sch, compute.kicad_pcb, compute.sch, controller.kicad_pcb, controller.sch, motor_rio.kicad_pcb, motor_rio.sch]
2018-09-06 STABLE-1 add readmes and initial docs (#5)
    * Initial start on docs.
    * STABLE-1: Setup Read the Docs Sphinx theme
    * STABLE-1: Don't install latex automatically
    * STABLE-1: Add more workflow infra for docs
    * STABLE-1: Initial docs structure
    * STABLE-1: Initial landing-page
    * STABLE-1: Finalize initial 'read the docs'
    * STABLE-1: Small change to GitHub README
2018-09-07 DOCS-6: Initial BOM skeleton
    [BOM.ods]
2018-09-09 DOCS-6: Add chassis to BOM and change requirements filename
    [BOM.ods]
2018-09-11 DOCS-6: Update top-level component landing pages
2018-09-17 LAB-1 Altium 12V -> {5V, 3.3V} (#16)
    * LAB-1: Initial Altium work
    * LAB-1: Finished required work for the power lab
    * generate outputs
    [01 Revision History and Contents.SchDoc, 02 Mobile Power.SchDoc, ASPI-8040S.STEP, Bill of Materials-ECE453-PWR.xlsx, Bill of Materials-ECE453_Interface.xlsx, CUI_PJ-002A.step, ECE453-PWR.PrjPcb, ECE453-PWR.SCHLIB]
2018-09-19 progress commit on libraries
    [ECE453_PWR.PcbLib, ECE453_PWR.SchLib]
2018-09-19 ready to do board layout and routing
    [02 Mobile Power.SchDoc, 0805_single.stp, C0805C104M5RACTU.step, D8.stp, DBV5.stp, DO-214AC.stp, ECE453_PWR.PcbDoc, ECE453_PWR.PcbLib]
2018-09-26 commit final work for lab 2
    [ECE453-PWR.PrjPcb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]
2018-10-22 add ESC and motor manuals
2018-10-22 more work on simulated the battery
2018-10-22 complete initial Battery simulation class
2018-10-22 move kicad assets
    [battery_rio.kicad_pcb, battery_rio.sch, compute.kicad_pcb, compute.sch, controller.kicad_pcb, controller.sch, motor_rio.kicad_pcb, motor_rio.sch]
2018-10-22 initial altium files
    [flight-controller.PrjPCB, flight-power.PrjPCB, mezzanine-card.PrjPCB]
2018-10-22 huge progress commit, accelerometer and gyro schematics done plus top-level schematic started
    [Connectors.SchDoc, MB1136.PcbDoc, MB1136.PrjPCB, MB1136.SCHLIB, MB1136.SchDoc, MCU_64.SchDoc, ST_LINK_V2-1.SCHDOC, accelerometer.SchDoc]
2018-10-22 made a lot of progress
    [flight-controller.PrjPCB, flight-power.PrjPCB, gyro.SchDoc, mcu_power.SchDoc, mezzanine-card.PrjPCB, motor_control.SchDoc]
2018-10-22 finished motor interface schematic sheet
    [accelerometer.SchDoc, flight-controller.PrjPCB, gyro.SchDoc, mcu_power.SchDoc, motor_control.SchDoc, radio.SchDoc, top_level.SchDoc]
2018-10-24 ground schematic need to verify De1 pin out
    [de1_soc_connector.SchLib, mezzanine-card.PrjPCB, mezzanine_card.SchDoc]
2018-10-24 finished BMP280 schematic symbol
    [flight-controller.PrjPCB, radio.SchDoc, sensors.SchDoc]
2018-10-24 forgot to save project
    [flight-controller.PrjPCB]
2018-10-25 more work on the flight control board
    [flight-controller.PrjPCB, mcu_power.SchDoc, power.SchDoc, programming.SchDoc, sensors.SchDoc, usb_serial.SchDoc]
2018-10-26 progress commit
    [power.SchDoc]
2018-10-26 add main toggle switch 3D model
2018-10-26 playing with the toggle switch
2018-10-27 added a TODO
    [motor_control.SchDoc]
2018-10-28 ESC output stage complete
    [esc.PrjPCB, esc.SchDoc, fets.SchDoc]
2018-10-29 just need to finish the input configuration for the ESC
    [esc.PrjPCB, esc.SchDoc, esc_inputs.SchDoc, esc_outputs.SchDoc, fets.SchDoc]
2018-10-29 finished with bldc controller schematic
    [esc.PrjPCB, esc.SchDoc, esc_inputs.SchDoc, fets.SchDoc]
2018-10-29 somehow the project was modified
    [esc.PrjPCB]
2018-10-30 started the PCB layout but need to start over with a four-layer board
    [esc.PcbDoc, esc.PrjPCB, esc_four_layer.PcbDoc, fets.SchDoc]
2018-10-30 good start on a new four layer board
    [esc.PrjPCB, esc.SchDoc, esc_four_layer2.PcbDoc, esc_inputs.SchDoc]
2018-10-31 UART on the ground station
2018-10-31 finished initial layout
    [esc.PcbDoc, esc.PrjPCB, esc_four_layer.PcbDoc, esc_four_layer2.PcbDoc, fets.SchDoc]
2018-10-31 finished layout and generated fabrication outputs
    [esc.GBL, esc.GBO, esc.GBP, esc.GBS, esc.GTL, esc.GTO, esc.GTP, esc.GTS]
2018-10-31 board and parts ordered
    [Bill of Materials-esc.xlsx]
2018-10-31 added STEP output, started working on 3D case
    [Bill of Materials-esc.xlsx, M2 screw size FLAT WASHER.STEP, M2 x 0.4mm Thread HEX NUT.STEP, esc_case.FCStd]
2018-10-31 GPIO driver
2018-10-31 work on the flight control board
    [flight-controller.PrjPCB, mcu_power.SchDoc, motor_control_an.SchDoc, programming.SchDoc, radio.SchDoc, sensors.SchDoc, usb_serial.SchDoc]
2018-11-01 progress commit on flight control schematic capture
    [mcu_power.SchDoc, power.SchDoc, programming.SchDoc, sensors.SchDoc, usb_serial.SchDoc]
2018-11-03 got a lot of work done on the protection circuitry
    [power.SchDoc]
2018-11-04 STMF303 GPIO driver with BLINKY
2018-11-04 good progress on power distribution board
    [monitoring.SchDoc, motor_control.SchDoc, outputs.SchDoc, power.SchDoc, power_dist.PrjPCB, raw_input.SchDoc]
2018-11-05 progress commit on power distribution board
    [low_voltage_rails.SchDoc, monitoring.SchDoc, outputs.SchDoc, power_dist.PrjPCB, raw_input.SchDoc]
2018-11-06 finished MCAD and started locating components for the power board
    [low_voltage_rails.SchDoc, monitoring.SchDoc, outputs.SchDoc, power_dist.PcbDoc, power_dist.PrjPCB, raw_input.SchDoc]
2018-11-10 I2C ll_stm working and gyro and accel datasheet
    connect to accel and gyro will try to read data from the devices tomorrow
2018-11-10 add 3D outputs for creating plates
    [quadcopter_bottom_plate.iges, quadcopter_bottom_plate.step, quadcopter_bottom_plate.stl, quadcopter_top_plate.iges, quadcopter_top_plate.step, quadcopter_top_plate.stl]
2018-11-11 power board, all components placed
    [flight-controller.PrjPCB, low_voltage_rails.SchDoc, power_dist.PcbDoc, power_dist.PrjPCB]
2018-11-11 power distribution board layout complete
    [Bill of Materials-power_dist.xlsx, power_dist.PcbDoc, power_dist.PrjPCB, raw_input.SchDoc]
2018-11-11 for some reason these files weren't saved
    [power_dist.PrjPCB]
2018-11-11 add some of the power input headers for the flight board
    [power.SchDoc, power_dist.PrjPCB]
2018-11-12 minor updates to the radio sheet
    [flight-controller.PrjPCB, motor_control_an.SchDoc, radio.SchDoc]
2018-11-12 progress commit, just need to assign pins now
    [accelerometer.SchDoc, gyro.SchDoc, mcu_power.SchDoc, power.SchDoc, power_dist.PrjPCB, programming.SchDoc, radio.SchDoc, sensors.SchDoc]
2018-11-13 partially complete with assigning I/O
    [top_level.SchDoc]
2018-11-13 flight control board schematic complete
    [accelerometer.SchDoc, flight-controller.PcbDoc, flight-controller.PrjPCB, gyro.SchDoc, power.SchDoc, programming.SchDoc, radio.SchDoc, sensors.SchDoc]
2018-11-13 some work on component placement
    [motor_control.SchDoc]
2018-11-14 I2C working and sending data across radios
2018-11-14 Print uart from MCU
2018-11-14 client.c has uart
2018-11-14 a lot of progress on the flight control board
    [sensors.SchDoc]
2018-11-14 Final demo code
    Commands being sent from the ground station and being used to control
    the pwm on the Quad. I2C sending from the accel to the ground station
    and printed on client.
2018-11-16 esc .c start
2018-11-18 Gyro and vector rework
    [accel.c, accel.h, board.c, board.h, cli.c, gpio_alias.c, gyro.c, gyro.h]
2018-11-18 power board and flight computer done, need to create fabrication outputs and order
    [flight-controller.PrjPCB, gyro.SchDoc, mcu_power.SchDoc, motor_control.SchDoc, power.SchDoc, power_dist.PcbDoc, power_dist.PrjPCB, raw_input.SchDoc]
2018-11-19 generated outputs from the power distribution and flight controller boards
    [Bill of Materials-flight-controller.xlsx, Bill of Materials-power_dist.xlsx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]
2018-11-19 updated BOM output
    [Bill of Materials-flight-controller.xlsx, Bill of Materials-power_dist.xlsx]
2018-11-19 added PCBs to quadcotper assembly
2018-11-19 mounting hole size change and new stl outputs
    [quadcopter_bottom_plate.stl, quadcopter_top_plate.stl]
2018-11-20 gyro graph side by side
2018-11-20 Gyro Driver
2018-11-25 a start on a telemetry framework that will support http services for convenience, tcp data/command services and a websocket service
2018-11-26 Control loop started
    gyro init doesnt work right now
2018-11-30 testing sample incoming packet
2018-11-30 SPI working with need to work on interrupts
2018-12-01 Gyro data working callibration needs work
2018-12-02 accel/gyro packets graph
2018-12-03 Battery Driver
2018-12-03 Lidar driver
2018-12-03 Improved lidar driver with interrupts
2018-12-05 add a global timer
2018-12-05 turn off printing
2018-12-07 button fix
2018-12-09 added some useful features for PID tuning
